zhuyanheng/Phys39-teamR-X/README.md

# Phys 39 Team R&X

Team members:

- Ricky Huang
- Xavier Zhu

## Repository

[Phys39 Team R&X GitHub Repository](https://github.com/zhuyanheng/Phys39-teamR-X)

### Quick navigation

- [Module 1: Arduino measurements](Module_1/arduino/README.md)
- [Module 2: Instrument pieces](Module_2/arduino/README.md)
- [Module 3: Manual TEC and Python GUI](Module_3/python/README.md)
- [Module 4: Open-loop TEC](Module_4/README.md)
- [Module 5: P control](Module_5/README.md)
- [Module 6: P/PI control and thermal models](Module_6/README.md)
- [Module 7: Aluminum rod instrument and stationary fin](Module_7/README.md)
- [Module 8: Angstrom experiment and final thermal transport](Module_8/README.md)
- [Current A3 PDF](Module_6/output/pdf/A3_Huang_Zhu.pdf)

## Module 1: Arduino Measurements

This repository contains the Arduino sketches, experimental data, figures,
measurement notes, and analysis used for Module 1.

- [Module 1 Arduino documentation](Module_1/arduino/README.md)
- [Module 1 data documentation](Module_1/data/README.md)
- [Part 3C quantitative analysis](Module_1/data/analysis_3c_ab.md)
- [A1 Module 1 evidence note](docs/module_notes/module_01_evidence.md)

### Module 1 Arduino Sketches

#### Part 1: Blink and Digital Output

- [Blink with 1:1 HIGH:LOW ratio](Module_1/arduino/part_01_blink_1to1/part_01_blink_1to1.ino)
- [Blink with 1:10 HIGH:LOW ratio](Module_1/arduino/part_01_blink_1to10/part_01_blink_1to10.ino)
- [Blink with 10:1 HIGH:LOW ratio](Module_1/arduino/part_01_blink_10to1/part_01_blink_10to1.ino)

#### Part 2: AnalogReadSerial

- [AnalogReadSerial](Module_1/arduino/part_02_analog_read_serial/part_02_analog_read_serial.ino)

#### Part 3: ADC Digitization and Averaging

- [Part 3A: Integer ADC readings](Module_1/arduino/part_03a_adc_integer/part_03a_adc_integer.ino)
- [Part 3B: ADC-to-voltage conversion](Module_1/arduino/part_03b_adc_voltage/part_03b_adc_voltage.ino)
- [Part 3C: N=1 and N=1000 averaging comparison](Module_1/arduino/part_03c_averaging_comparison/part_03c_averaging_comparison.ino)
- [Part 3D: ADC acquisition timing](Module_1/arduino/part_03d_averaging_timing/part_03d_averaging_timing.ino)

#### Part 4: PWM LED Control

- [Averaged ADC input controlling LED PWM](Module_1/arduino/part_04_averaged_adc_pwm_led/part_04_averaged_adc_pwm_led.ino)

### Module 1 Experimental Data

- [N=1 voltage data](Module_1/data/part_3c_N1_data.csv)
- [N=1000 averaged voltage data](Module_1/data/part_3c_N1000_data.csv)
- [Part 3C data analysis](Module_1/data/analysis_3c_ab.md)

## Module 2: First Real Instrument Pieces

This repository contains the Arduino sketches, figures, and evidence note
for Module 2: thermistor temperature measurement, Serial Plotter output,
trim-pot PWM control, H-bridge logic verification, and DC motor drive.

- [Module 2 Arduino documentation](Module_2/arduino/README.md)
- [Module 2 evidence note](docs/module_notes/module_02_instrument_pieces.md)

### Module 2 Arduino Sketches

- [Part 1: Thermistor Serial Data and Temperature Conversion](Module_2/arduino/part_1/part_1.ino)
- [Part 2: Serial Plotter Output](Module_2/arduino/part_2/part_2.ino)
- [Part 3: Trim-Pot PWM and H-Bridge Control](Module_2/arduino/part_3/part_3.ino)

### Module 2 Figures

- [Part 1 Serial Output](Module_2/figures/part_1.png)
- [Part 2 Serial Plotter](Module_2/figures/part_2.png)
- [Part 3A Serial Plotter](Module_2/figures/part_3a_serial_plotter.png)
- [Part 3AB Setup](Module_2/figures/part_3ab_setup.png)
- [Part 3B Cool PWM=142](Module_2/figures/part_3b_cool_PWM=142.png)
- [Part 3B Cool PWM=60](Module_2/figures/part_3b_cool_PWM=60.png)
- [Part 3B Heat PWM=115](Module_2/figures/part_3b_heat_PWM=115.png)
- [Part 3B Heat PWM=60](Module_2/figures/part_3b_heat_PWM=60.png)
- [Part 3C Heat Motor Running](Module_2/figures/part_3c_heat.png)
- [Part 3C Motor Video](Module_2/figures/part_3c.mp4)

## Module 3: Manual TEC Heat/Cool And First Python GUI

This repository contains the Arduino sketches, Python scripts, data, and
figures for Module 3: manual TEC control via H-bridge, thermistor feedback,
and a Python GUI for display and control.

- [Module 3 Arduino documentation](Module_3/arduino/README.md)
- [Module 3 Python documentation](Module_3/python/README.md)
- [Module 3 data documentation](Module_3/data/README.md)
- [Module 3 evidence note](docs/module_notes/module_03_tec_gui.md)

### Module 3 Arduino Sketches

- [Part 2: Manual Trim-pot Motor Control](Module_3/arduino/part_2/part_2.ino)
- [Part 3: Manual TEC Calibration](Module_3/arduino/part_3/part_3.ino)
- [Part 6: TEC Python Serial Control](Module_3/arduino/part_6_tec_python_control/part_6_tec_python_control.ino)

### Module 3 Python Scripts

- [Part 4: Temperature Strip Chart](Module_3/python/part_4_graphing.py)
- [Part 5: TEC Control GUI](Module_3/python/part_5_tec_control_gui.py)
- [Python dependencies](requirements.txt)

The final integrated pair is the
[Arduino serial-command sketch](Module_3/arduino/part_6_tec_python_control/part_6_tec_python_control.ino)
and the [Python TEC control GUI](Module_3/python/part_5_tec_control_gui.py).
They communicate at `9600 baud` using commands such as
`SET PWM 40 DIR HEAT` and measurements such as:

```text
Temperature (C): 27.73, Time (s): 645.06, PWM: 40, Heat/Cool: 1
```

The fields are temperature in degrees Celsius, Arduino elapsed time in
seconds, the active PWM command, and direction (`1` = heat, `0` = cool).

### Module 3 Figures

- [Part 2 Cooling](Module_3/figures/part_2_cooling.png)
- [Part 3 Oscilloscope on Digitals](Module_3/figures/part_3_oscilloscope_on_digitals.mp4)
- [Part 3 Oscilloscope on M+ and M-](Module_3/figures/part_3_oscilloscope_on_M+-.mp4)
- [Part 3 Switch Between Cooling and Heating](Module_3/figures/part_3_switch_between_cooling_heating.png)
- [Part 4 Temperature Graph](Module_3/figures/part_4_temperature_graph.png)
- [Part 5 GUI Without Actual Control](Module_3/figures/part_5_GUI_without_actual_control.png)
- [Part 6 TEC Control Using GUI 1](Module_3/figures/part_6_TEC_control_using_GUI_1.png)
- [Part 6 TEC Control Using GUI 2](Module_3/figures/part_6_TEC_control_using_GUI_2.png)
- [Part 7 GUI](Module_3/figures/part_7_GUI.png)
- [Part 7 Labeled Heat/Cool Record](Module_3/figures/part_7_heat_cool_record.png)
- [Part 7 Cooling](Module_3/figures/part_7_cooling.png)
- [Part 7 Heating](Module_3/figures/part_7_heating.png)

## Module 4: Open-Loop TEC Heating and Cooling

This repository contains the Arduino and Python programs, raw temperature
records, figures, and A2 analysis for Module 4: software temperature shutdown,
open-loop heating and cooling at five PWM levels per direction, and a
steady-temperature-versus-signed-PWM comparison.

- [Module 4 documentation](Module_4/README.md)
- [Module 4 selected measurements](Module_4/data/steady_state.csv)
- [Module 4 lab record and steady-state protocol audit](docs/module_notes/module_04_open_loop_tec.md)

### Module 4 Arduino Sketch

- [Part 1: TEC Control and Temperature Safety](Module_4/arudino/part_1/part_1.ino)

### Module 4 Python Scripts

- [TEC Control GUI and CSV Logger](Module_4/python/part_5_tec_control_gui.py)
- [Part 4 Data Validation and Figures](Module_4/python/plot_a2.py)
- [A2 PDF Builder](Module_4/python/build_a2_existing_data.py)

### Module 4 Data and Figures

- [Ten selected HEAT/COOL measurements](Module_4/data/steady_state.csv)
- [Raw experimental CSVs and safety-test logs](Module_4/data/)
- [Part 1 safety-test record](Module_4/check/part_1_safety_check.md)
- [Part 1 HEAT high-current diagram](Module_4/figures/part_1_heating_high_current.png)
- [Part 1 COOL high-current diagram](Module_4/figures/part_1_cooling_high_current.png)
- [HEAT time trace](Module_4/figures/part_4_heating_trace.png)
- [COOL time trace](Module_4/figures/part_4_cooling_trace.png)
- [Steady temperature versus signed PWM](Module_4/figures/part_4_steady_temperature_vs_pwm.png)
- A2 two-page PDF candidate: not present in this checkout; see the Module 4 analysis files above.

The ten-point analysis and A2 PDF are provisional. The professor's revised
Part 3 steady-state rule requires about three step-response time constants
followed by one additional minute of observation. See the Module 4 lab record
for the measurements that need review or longer recordings before submission.
The two Part 1 diagrams are historical illustrations, not verified as-built
wiring records; inspect the actual thermal-switch path with the instructor.

## Module 5: P-Only Temperature Control

This repository contains the Arduino and Python programs, raw temperature
records, figures, and analysis for Module 5: closing the TEC feedback loop with
proportional control. Python computes the signed PWM `u = Kp (T_set − T)`,
sends the direction and magnitude to the Arduino, and the Arduino keeps its
independent 60 °C shutdown. The team verified the feedback signs, swept five
gains at a 30 °C heating setpoint, and compared measured droop with the
Module 4 susceptibility model.
Three later October 7 trials tested higher gains; the fixed `Kp=250` run
overshot and oscillated around 30 °C after cooling near 20 °C.

- [Module 5 documentation](Module_5/README.md)
- [Module 5 lab note and Part 6 derivation](docs/module_notes/module_05_p_control.md)

### Module 5 Arduino Sketch

- [P-only TEC sketch](Module_5/arduino/p_only_tec/p_only_tec.ino)

### Module 5 Python Scripts

- [P-control GUI and CSV logger](Module_5/python/p_only_tec_control_gui.py)
- [Part 4 droop comparison](Module_5/python/plot_droop_comparison.py)
- [Strip-chart traces](Module_5/python/plot_strip_chart_traces.py)
- [Kp=250 oscillation plotting script](Module_5/python/plot_kp250_oscillation.py)
- [Controller tests](Module_5/python/test_p_only_tec_control_gui.py)

### Module 5 Data and Figures

- [Module 5 raw-data index](Module_5/data/README.md)
- [October 7 Kp=32 short trial](Module_5/data/20261007_104314_kp32_short_of_30c.csv)
- [October 7 mixed-gain exploration](Module_5/data/20261007_104346_mixed_kp_setpoint_exploration.csv)
- [October 7 Kp=250 oscillation CSV](Module_5/data/20261007_105005_kp250_20to30c_oscillation.csv)
- [Part 4 droop summary](Module_5/data/part_04_droop_comparison.csv)
- [Measured vs predicted droop](Module_5/figures/part_04_measured_vs_predicted_droop.png)
- [Low-gain strip-chart trace (Kp = 0.25)](Module_5/figures/low_gain_kp0.25_trace.png)
- [High-gain strip-chart trace (Kp = 4)](Module_5/figures/high_gain_kp4_trace.png)
- [Kp=250 oscillation: temperature and signed PWM](Module_5/figures/kp250_20to30c_oscillation.png)

The team selected `Kp = 0.25–4 PWM/°C` and accepts the Module 5 comparison
using the provisional Module 4 heating slope (`χ_h = 0.4954 °C/PWM`). The
underlying Module 4 steady-state limitation remains documented. Instructor
approval for the gain range and the Part 2 cooling target is not recorded.

## Module 6: P/PI Control and Lumped Modeling

Module 6 data analysis and the A3 report are complete using the retained
measurements: three P runs collected on October 21 (`Kp=0.25, 4, 100`, `Ki=0`)
and three PI runs collected on October 19 (`Kp=20`, `Ki=0.1, 0.2, 0.5`).
All six include the target sequence `20 -> 30 -> 20 °C` and a PWM limit of
255. The current A3 uses these Module 6 measurements and Module 4 calibration;
Module 5 P records remain historical evidence for Module 5 and are no longer
used in the current A3.

The 12-page report covers Questions 1-5, six experimental plots, six
standardized two-lump simulation plots, step-response metrics, damping and PI
stability calculations, windup, and gain selection. The simulations use the
teacher's v3 calculation core. Physical records, operator GUI screenshots,
and newly computed model trajectories are distinguished. Measurement and
model qualifications are recorded in the report. Repository publication and
Moodle submission are separate from completing the analysis.

### Module 6 report and evidence

- [Module 6 guide and directory map](Module_6/README.md)
- [Current A3 PDF](Module_6/output/pdf/A3_Huang_Zhu.pdf)
- [Current A3 Markdown](Module_6/docs/a3_feedback_model.md)
- [Current experimental analysis](Module_6/docs/experiment_analysis_2026-10-21.md)
- [Six raw measurements and retained run IDs](Module_6/data/physical/README.md)
- [Measured step-response metrics](Module_6/data/experiment_analysis/step_metrics.csv)
- [Data and provenance index](Module_6/data/README.md)
- [Figures index](Module_6/figures/README.md)
- [P comparison](Module_6/figures/experiment_analysis/p_aligned_comparison.png)
- [PI comparison](Module_6/figures/experiment_analysis/pi_aligned_comparison.png)
- [Analysis scripts and PDF reproduction](Module_6/python/analysis/README.md)
- [Earlier one-lump notes](Module_6/docs/one_lump_model_notes.md)
- [Earlier executed baseline notebook](Module_6/python/analysis/model_baseline_analysis.ipynb)

### Module 6 programs

- [Simulation launcher](Module_6/run_gui.command) and [teacher v3 source](Module_6/python/Lab_6_7_modeling_tec_v3.py)
- [Physical P/PI launcher](Module_6/run_pi_control.command) and [operator guide](Module_6/docs/pi_controller_guide_zh.md)
- [Arduino sketch and serial protocol](Module_6/arduino/README.md)

On the team's macOS setup, launch from the repository root or double-click
the appropriate `.command` file:

```bash
./Module_6/run_gui.command
./Module_6/run_pi_control.command
```

The mathematical simulator uses `Module_6/.venv` with modern Python/Tk;
the physical GUI and numerical analysis use the repository `.venv`.
These ignored local environments must be installed on a new checkout;
see the [Module 6 setup instructions](Module_6/README.md#首次配置环境).
The simulator never connects to the Arduino. The physical GUI connects only
when the operator requests it.

To recompute the current experimental analysis and numerical simulations:

```bash
.venv/bin/python Module_6/python/analysis/analyze_retained_experiments.py
.venv/bin/python Module_6/python/analysis/prepare_a3_evidence.py
```

These scripts do not access hardware. See the analysis README for PDF
dependencies and the final build command. Earlier Module 5-based analysis and
superseded A3 outputs are identified as historical, with the prior report in
`Module_6/archive/2026-10-21_pre_new_p/`.

## Module 7: Aluminum Rod, Step Response, and Stationary Fin

Module 7 replaces the one- and two-temperature lumped descriptions with a
position-dependent temperature field `T(x, t)`. The three course parts build
one model-testing chain: Part I derives the heat equation and the Biot test,
Part II derives the stationary finite-rod profile and its semi-infinite limit,
and Part III builds the six-channel rod instrument and measures the step
response and stationary profile.

- [Module 7 plan and requirements](Module_7/README.md)
- [Module 7 status snapshot](docs/module_notes/module_07_state.md)
- [Module 7 lab-day runbook, S16 → S17](docs/module_notes/module_07_lab_day_runbook_2026-10-26.md)
- Due Wednesday, October 28 at 9:05 AM: individual A4, submitted as
  `docs/assessments/a4_finite_length_biot.md` and `A4_Lastname.pdf`
- Due Wednesday, October 28 at 11:55 AM: C5 rod-instrument checkoff receipt
  citing the pushed acquisition-code and evidence commit

The governing equations used throughout are

```text
∂θ/∂t = α ∂²θ/∂x² − νθ,     α = k/(ρc),   ν = hP/(ρcA)
d²θ/dx² − m²θ = 0,          m² = hP/(kA)
Θ(x) = cosh[m(L − x)]/cosh(mL)   (insulated tip)
Θ∞(x) = e^(−mx)                  (semi-infinite limit)
Bi⊥ = hR/(2k) = (mR/2)²          (radius check)
```

Module 7 keeps the Module 6 Arduino sketch and Python GUI unchanged as a
working checkpoint and adds new Module 7 copies for six-channel acquisition.
Raw rod data, calibration coefficients, and corrected data are stored
separately so that measured values are never overwritten.

## Hardware

- Arduino Uno
- 100 kΩ potentiometer
- LED
- Current-limiting resistor
- Breadboard
- Jumper wires
- Oscilloscope and probe
- 100 kΩ NTC thermistor
- 100 kΩ precision resistor
- BTS7960 H-bridge
- 12 V DC power supply
- Small DC motor
- SPDT switch
- Thermoelectric Cooler (TEC)
- Thermal switch (NC)
- Heat exchanger (pump and radiator fans)

## Tested Capabilities

The team uploaded and tested the Module 1, Module 2, and Module 3 programs on an Arduino Uno.

- The three Part 1 sketches produced the intended HIGH:LOW timing ratios.
- Part 2 reported raw analog-input values over the serial connection.
- Part 3A reported discrete integer ADC values.
- Part 3B converted ADC values to voltage.
- Part 3C compared single readings with 1000-reading averages.
- Part 3D measured the time required for 1000 ADC conversions.
- Part 4 used the averaged potentiometer input to control LED brightness with PWM.
- Module 2 Part 1 measured temperature using a thermistor voltage divider and the Beta model.
- Module 2 Part 2 output temperature values for the Arduino Serial Plotter.
- Module 2 Part 3 controlled H-bridge PWM and direction with a trim-pot and switch.
- Module 2 Part 3B verified H-bridge command signals with an oscilloscope.
- Module 2 Part 3C drove a small DC motor in both directions with variable speed.
- Module 3 Part 2 and Part 3 successfully drove the TEC manually and calibrated heat/cool directions.
- Module 3 Part 4 displayed live temperature data in a Python strip chart.
- Module 3 Part 5 built a functional Python GUI with synchronized slider and text box.
- Module 3 Part 6 enabled serial-command control of PWM and direction from Python.
- Module 3 Part 7 completed integrated manual-control testing with real-time plotting and CSV logging.
- Module 4 software-safety tests recorded temperature-limit shutdown and continuing serial reports; the Part 1 record distinguishes firmware reports from independent electrical measurements.
- Module 4 collected ten selected HEAT/COOL PWM points and generated provisional time traces, fitted slopes, and an A2 PDF. Compliance with the revised steady-state rule remains to be established.
- Module 5 verified the low-gain HEAT and COOL feedback signs, swept five proportional gains at a 30 °C setpoint, measured droop versus gain, and compared measured droop with the Module 4 susceptibility prediction (no oscillation up to Kp = 4 in the September sweep). An October 7 exploratory run at Kp = 250 overshot the setpoint and showed repeated oscillation.
- Module 6 collected three P and three PI runs, with temperature, target, signed PWM, P/I terms and error logging. The retained high-gain P run uses Kp=100 and shows decaying ringing. The three PI gains trade final heating speed against overshoot.
- Module 6 completed six two-lump GUI simulations and reproducible numerical calculations, checked the P damping and PI stability criteria, and generated the current A3 report. The control software has 16 hardware-free tests, and the simulator's six model/controller combinations passed startup checks.

## How to Run a Sketch

1. Open the selected `.ino` file in Arduino IDE.
2. Select `Arduino Uno` as the board.
3. Select the correct serial port.
4. Click **Verify**.
5. Click **Upload**.
6. Open Serial Monitor or Serial Plotter at `9600 baud` when required.
7. For Module 3 Python scripts, ensure the Serial Monitor is closed before running the GUI.
8. For the Module 4 GUI, also set its `SERIAL_PORT` to the connected Arduino and close Serial Monitor before launch; see the [Module 4 documentation](Module_4/README.md).
9. Module 6 uses the same serial-command firmware family. Close other applications using the port, select the port in its physical GUI, and follow the [P/PI operator guide](Module_6/docs/pi_controller_guide_zh.md). Uploading firmware and connecting the mathematical simulator are different operations; the simulator requires no board.

### Running the Module 3 Python Programs

From the repository root, install the dependencies once:

```text
python3 -m pip install -r requirements.txt
```

Run the display-only strip chart:

```text
python3 Module_3/python/part_4_graphing.py
```

Run the final manual-control GUI:

```text
python3 Module_3/python/part_5_tec_control_gui.py
```

## AI Use

AI helped draft and debug the Arduino thermistor/serial-command code, Python
serial parser, GUI controls, plotting, CSV logging, documentation, and
repository organization. The team selected and verified the pin mapping,
thermistor constants, 1000-sample average, heat/cool direction mapping, and
low-power PWM setting, and tested the programs on the real Arduino, H-bridge,
thermistor, TEC, oscilloscope, and power supply. The code paths reviewed for
the C3 oral explanation are the measurement conversion, serial format, GUI
synchronization, command path, and plot updates; each team member must be able
to explain them without relying on the AI transcript.

For Module 4, AI also assisted with CSV validation, plotting, and the draft A2
analysis. The selected steady-state windows and physical checks remain subject
to the team's and instructor's review; generated figures are not a substitute
for the revised measurement protocol.

The Module 4 temperature-limit shutdown has serial-log evidence, but actual
output-pin voltage, disconnected-sensor behavior, and broken-serial behavior
have not been independently verified in the cited test record. The ten-point
steady-state analysis also requires review against the revised Part 3 rule.

For Module 5, AI helped draft and debug the P-control GUI, the droop
comparison and strip-chart plotting scripts, and the Part 6 one-lump
derivation. The measured droop, gain values, and the provisional Module 4
heating slope used in the prediction remain subject to the team's and
instructor's review; generated figures do not replace the physical runs or the
instructor-approved gain range.

For Module 6, AI assisted with P/PI software, raw-data checks, reproducible
analysis, two-lump stability calculations, plots, file organization, and A3
writing/PDF generation. Experimental CSVs are the team's measurements;
computed model data are labeled separately. The current A3 excludes the
superseded Module 5 P evidence. Each team member remains responsible for
understanding the equations, data selection, and interpretation.
