zhuyanheng/Phys39-teamR-X/Module_7/docs/README.md

# Module 7 documentation index

`Module_7/` holds only **this module's own** artefacts. The evidence notes the course asks for live in the repository-root `docs/`, following the same convention as Modules 1-6, and are not duplicated here.

## This directory

| File | Contents |
| --- | --- |
| `README.md` (this file) | Index of Module 7 documentation: which documents live in the repository-root `docs/`, and where figures and data come from |
| `../README.md` | Module 7 experiment design, the six components, the prediction record, the software extension plan |

## Module 7 evidence in the repository-root `docs/`

| File | Contents | Status |
| --- | --- | --- |
| `docs/module_notes/module_07_state.md` | Status snapshot: what exists, what is verified, what is missing, and the known warts; read this first when picking the module up cold | Present |
| `docs/module_notes/module_07_lab_day_runbook_2026-10-26.md` | Lab-day sequence: software, geometry, calibration, step, steady state | Present |
| `docs/module_notes/module_07_step1_integration_check.md` | On-site procedure for the first power-up of the six-channel chain: wiring, expected voltages, per-channel fingerprints, fault injection | Present |
| `docs/module_notes/module_07_rod_instrument.md` | Sensor map, same-temperature check record, geometry, baseline/step, run metadata; includes the decision to skip the soak calibration and what that costs | Holes 2, 5, 7, 8, 9 and the measured distances recorded 2026-10-30; the 2026-11-02 20 °C/40 °C runs, the 45 °C interlock trip, the ≈ 30 min settling estimate and the 31 min 40 °C confirmation run (still 2.6× over the slope limit, so the target is now ≈ 45 min) recorded 2026-11-02; the self-read ambient and why it is the largest systematic; residuals and the `h` inversion still to be filled in |
| `docs/module_notes/module_07_stationary_fin.md` | Part 3 method, steady-state criteria, the two models, two-layer uncertainty, predictions for the measured geometry, open items | Method and script complete (22 tests pass); §9: all three 2026-11-02 runs refused, so still no certified stationary profile; §10: the diagnostic fit the 31-minute record supports (`m = 4.83 ± 0.07 1/m`, five systematics) and how to quote it |
| `docs/assessments/a4_finite_length_biot.md` | A4, parts 1-4 | Complete theoretical draft for Yanheng Zhu, updated 2026-11-06; source/PDF version receipt separately verified; regenerated PNG bytes excluded from source checks; measured 12.77 mm diameter and 0.01 mm caliper specification recorded; reproducible predictions and PDF in `Module_7/output/pdf/A4_Zhu.pdf`; student review and Moodle submission not confirmed |

A4 numerical checks: `.venv/bin/python Module_7/python/analysis/a4_theory_checks.py`.
This writes provisional results to `data/processed/a4_predictions/` and the
finite-length comparison to `figures/a4/`. PDF authoring and version recording
are handled by `python/analysis/build_a4_pdf.py`; see that script's usage note.
The A4 predictions use fixed `h = 10 W/(m^2 K)` and the same 6061-T6 table's
`k = 166-172 W/(m K)` temperature envelope, never a diagnostic fitted `m`.

## Figures

`Module_7/figures/` is written by the analysis scripts. The file names map one-to-one onto the figure numbers used in the report:

- `part_01_sensor_map.png` - rod geometry, hole positions, probe numbering (`python/analysis/sensor_map_figure.py`)
- `part_02_step_response.png` - six-channel step response (no calibration correction curves: the soak was skipped) (`python/analysis/step_response_figure.py`, default input `module_07_rod_interlock_trip_45C_40C.csv`)
- `part_03_stationary_profile.png` - stationary profile with both fits and both residual sets; the committed copy is titled `CRITERION RELAXED`, because the pre-registered criterion was not met (`python/analysis/stationary_fin_fit.py`)

All three exist and are regenerated by rerunning those three commands; nothing in them is hand-edited. Regenerating
them on 2026-11-02 after the documentation pass produced **byte-identical** PNGs, and the same rerun of the fit and
the diagnostics reproduced both JSONs and the profile CSV byte for byte — so the committed files are exactly what
the committed scripts emit. Diagnostic figures are not deliverable figures: the per-run check traces sit in
`figures/pilot_checks/<raw stem>_temperatures.png`, one file per checked run.

Every number that appears in a figure must be traceable to a fit result in `Module_7/data/processed/`, and vice versa. The
`part_03` numbers therefore come from `module_07_rod_stationary_40C_stationary_fit.json`, and the systematics quoted next to them
in the report come from `module_07_rod_stationary_40C_stationary_diagnostics.json` (written by
`python/analysis/stationary_diagnostics.py`).
