zhuyanheng/Phys39-teamR-X/Module_5/figures/README.md

# Module 5 figures

- [Measured vs predicted droop](part_04_measured_vs_predicted_droop.png): Part 4 comparison, generated by `Module_5/python/plot_droop_comparison.py`.
- [Low-gain strip-chart trace (Kp = 0.25)](low_gain_kp0.25_trace.png): temperature and PWM, generated by `Module_5/python/plot_strip_chart_traces.py`.
- [High-gain strip-chart trace (Kp = 4)](high_gain_kp4_trace.png): temperature and PWM, generated by `Module_5/python/plot_strip_chart_traces.py`.
- [Kp=250 oscillation from near 20 °C toward 30 °C](kp250_20to30c_oscillation.png): temperature, setpoint, and signed firmware-reported PWM; generated by [`plot_kp250_oscillation.py`](../python/plot_kp250_oscillation.py) from [`20261007_105005_kp250_20to30c_oscillation.csv`](../data/20261007_105005_kp250_20to30c_oscillation.csv).

See the [Module 5 lab note](../../docs/module_notes/module_05_p_control.md) and [data index](../data/README.md) for source CSVs, calculations, and limitations.
