zhuyanheng/Phys39-teamR-X/Module_6/docs/pi_run_ki_0p1_2026-10-19.md

# PI experiment receipt — 2026-10-19

Source: `../data/physical/pi_kp_20_ki_0p1_20261019_093424_268559.csv`.
Raw CSV unchanged. Earlier discarded experiments are not used here.

Retain run_id=3: PI, Kp=20 PWM/°C, Ki=0.1 PWM/(°C s), PWM limit=255,
conditional anti-windup enabled. Runs 1 and 2 are brief preliminary starts
(30°C for about 2.5 s and 10°C for about 4.1 s), excluded from the comparison.
Run 3 begins with integral reset; the subsequent 20→30→20°C changes retain
the integral. All active measurement rows in run 3 report Safety=OK and no
computed output saturation. Firmware PWM is a reported command, not a current measurement.

| Segment | Recorded duration (s) | Initial T (°C) | Final-60-s mean T (°C) | Final-60-s range (°C) | Observed settling time (s) |
|---|---:|---:|---:|---:|---:|
| Initial conditioning toward 20°C | 228.50 | 24.99 | 19.9914 | 19.97–20.01 | 80.81 |
| 20→30°C | 650.92 | 19.97 | 29.9306 | 29.88–29.97 | 401.35 |
| 30→20°C | 332.86 | 29.93 | 20.0275 | 20.02–20.04 | 127.43 |

Settling definition: earliest measurement after the segment begins whose
remaining measurements stay within target ±0.2°C, with at least 60 s of
remaining observations. Times are relative to the first active measurement
after each step; event rows lack Arduino timestamps, so step timing has
approximately one sampling-interval uncertainty (about 0.51 s).

Heating maximum: 30.01°C (0.01°C above target; near reported measurement
resolution, not evidence of substantial overshoot). Cooling minimum: 20.02°C,
with no measured undershoot below target during the retained cooling step.
Final-60-s errors, defined as target minus measured temperature: heating
+0.0694°C; cooling −0.0275°C. These are finite-record tail errors, not proof of
an infinite-time equilibrium. The intact matched up/down trace is usable for
the PI comparison; classify as low/intermediate/high only after comparing the
other retained Ki runs. The response establishes that the present apparatus
can heat and cool; it does not identify the cause of the earlier flat trace.
