zhuyanheng/Phys39-teamR-X/docs/module_notes/module_05_p_control.md

# Module 5: P-only temperature control

## Part 1: controller implementation

- Python GUI: `Module_5/python/p_only_tec_control_gui.py`.
- Arduino sketch: `Module_5/arduino/p_only_tec/p_only_tec.ino`, copied from the Module 4 source on 2026-09-29. Verify that this is the version actually uploaded before a powered run.
- At startup the GUI sends PWM 0 and leaves P control off. It waits for a recent, finite 10–45 °C measurement with `Safety: OK` before enabling P control.
- For each Arduino report, Python calculates `error = setpoint - temperature`, `signed_pwm = Kp * error`, sends `HEAT` for nonnegative signed PWM or `COOL` for negative signed PWM, and rounds/clamps `abs(signed_pwm)` to an integer 0–255.
- The GUI plots measured temperature, setpoint, measured PWM by direction, and error. It writes all measurements and control values to a timestamped CSV in `Module_5/data/`.
- While P control is active, setpoint and Kp can be edited and applied with the **Apply setpoint / Kp** button (or Enter). The new command is calculated from the latest valid temperature immediately, and each subsequent CSV sample records the applied settings. Editing text alone does not change the controller. For the formal Part 3 gain sweep, stop and restart each gain from PWM 0 as the assignment requires.
- Stop requests PWM 0. A reported safety fault, temperature outside 10–45 °C, or a measurement gap over 2 seconds stops P mode and requests PWM 0. The Arduino independently checks its 60 °C software limit and invalid sensor readings. A lost Python process cannot be relied on to send a final zero command; operate only with the instructor's approved hardware precautions and supervision.

## Still to verify on the physical apparatus

- [ ] Instructor-approved wiring, current limit, live sensor reading, and firmware version.
- [x] Start with PWM 0 and confirm both firmware outputs report 0 (`20260930_105823_sign_test_heat_cool_confirmed.csv`, 0.56–11.16 s; firmware reports 0/0 and `Safety=OK`).
- [x] Low-gain HEAT and COOL feedback signs (Part 2); see the raw-data assessment below. Stop if temperature moves the wrong way in any future run.

Operator update, 2026-10-05: the team selected `Kp = 0.25–4 PWM/°C` as the Module 5 test range. The operator reports the original power-supply output setup as **12 V, 10 A, 120 W**. This reports the setup values; it does not independently verify the current-limit setting during each run, measured TEC current, instructor approval, wiring, or the uploaded firmware version. The team considers the existing Module 5 temperature records and provisional susceptibility sufficient for the Module 5 comparison; the Module 4 steady-state caveat remains part of the interpretation.

The initial implementation checks above were software-only; the subsequent physical observations are recorded below.

## Part 2: low-gain sign test, 2026-09-30

Primary raw record: `Module_5/data/20260930_105823_sign_test_heat_cool_confirmed.csv`. All 432 serial rows report `Safety=OK`. The first 22 PWM-0 samples average 23.283 °C (range 23.26–23.30 °C). The provisional Module 4 slopes are 0.4954 °C/PWM for heating and 0.1414 °C/PWM in cooling magnitude, so at `Kp=0.5 PWM/°C` the estimated loop gains are about 0.248 and 0.071, respectively; the slopes still need Module 4 steady-state revalidation.

| Segment | Setpoint, Kp | Firmware direction/PWM | Temperature observation | Assessment |
| --- | --- | --- | --- | --- |
| Heating, 12.18–59.76 s | 35 °C, 0.5 PWM/°C | HEAT, PWM 5–6 | 23.30 → 24.55 °C | Positive-error command and heating response supported. |
| PWM 0, 60.27–72.91 s | — | Both outputs 0 | 24.56 → 24.28 °C | The block cooled naturally while above ambient. |
| Cooling, 73.92–218.94 s | 15 °C, 0.5 PWM/°C | COOL, PWM 4–5 | 24.26 → 22.95 °C | Negative-error command and active cooling supported: 140 samples from 148.43 s onward were below the 23.26 °C minimum of the initial PWM-0 baseline; the final 20 samples averaged 22.961 °C. |

The earlier record, `20260930_104014_sign_test_preliminary.csv`, shows the same command directions but did not establish active cooling below ambient. The new run supplies that missing evidence. The 15 °C target remains farther below ambient than the assignment's “slightly below room temperature” instruction; instructor approval for that choice is not recorded here. **Part 2 physical direction result: both HEAT and COOL supported.** Confirm the cooling-setpoint choice with the instructor if strict adherence to “slightly below” is required.

## Part 3: original droop-versus-gain plan

Use one heating setpoint of 30 °C and a fresh PWM-0 ambient baseline before the gain sweep. With the earlier 23.283 °C baseline and provisional heating susceptibility `χ_h = 0.4954 °C/PWM`, the estimated open-loop PWM needed for the 6.717 °C change is `P_required ≈ 6.717/0.4954 = 13.56`. For each candidate, `P0 = Kp × 6.717`; recalculate if the actual ambient baseline changes. The following was the **pre-run candidate calculation** for the range the team ultimately selected. Instructor approval before the powered sweep is not documented:

| Candidate Kp (PWM/°C) | Predicted initial P0 (PWM) | Estimated loop gain L=Kpχ_h | Relative to P_required |
| ---: | ---: | ---: | --- |
| 0.25 | 1.68 | 0.124 | Well below |
| 0.5 | 3.36 | 0.248 | Below |
| 1 | 6.72 | 0.495 | About half |
| 2 | 13.43 | 0.991 | Comparable |
| 4 | 26.87 | 1.982 | Above |

For **each** approved gain: stop P mode and confirm PWM 0; start the run at the same 30 °C setpoint; wait until temperature settles or clearly fails to settle; record the actual starting temperature, final/mean temperature, error, final PWM, response shape, and raw CSV filename. Do not treat changes made with the live Apply button as separate Part 3 gain runs. Save a representative time trace and eventually plot measured droop against Kp. Keep the instructor-approved range, safety observations, and any saturation or failure to settle in the notes.

## Part 3: recorded gain sweep, 2026-09-30

The five new runs used a 30 °C heating setpoint and separate P-control starts. Each CSV begins with PWM 0 and reports `Safety=OK` throughout. The first run's PWM-0 baseline (39 samples) averaged **23.1885 °C**. Later runs began while the block was still warm, so their PWM-0 temperatures are not used as room-temperature estimates. The measured temperatures and droops below use each run's last 20 seconds of active control (40 samples).

| Kp (PWM/°C) | Last-20-s mean T (°C) | Measured droop (°C) | Last-20-s mean PWM | Raw CSV |
| ---: | ---: | ---: | ---: | --- |
| 0.25 | 24.0000 | 6.0000 | 1.700 | `20260930_110723_droop_kp0p25.csv` |
| 0.5 | 24.7700 | 5.2300 | 3.000 | `20260930_111214_droop_kp0p5.csv` |
| 1 | 25.4977 | 4.5023 | 4.275 | `20260930_112131_droop_kp1.csv` |
| 2 | 26.7695 | 3.2305 | 6.000 | `20260930_112429_droop_kp2.csv` |
| 4 | 27.7400 | 2.2600 | 9.000 | `20260930_112955_droop_kp4.csv` |

The last-20-s temperature change was about 0.01–0.02 °C per run. The team accepts these windows for the Module 5 comparison. A longer documented steady-state criterion would be needed to establish true equilibrium. The operator confirmed `Kp=0.25–4` as the team's selected range on 2026-10-05; instructor approval is not recorded in these files.

## Part 4: predicted versus measured droop

Use the provisional Module 4 heating susceptibility `χ_h = 0.4954 °C/PWM` and the first run's ambient reference `T_amb = 23.1885 °C`. At equilibrium, `T = T_amb + χ_h P` and `P = Kp(T_set − T)`, hence

`e_pred = T_set − T = (T_set − T_amb)/(1 + Kp χ_h)`.

Here `T_set − T_amb = 6.8115 °C`. The loop gain is `L = Kp χ_h`, so predicted fractional droop is `e_pred/(T_set − T_amb) = 1/(1 + L)`.

| Kp (PWM/°C) | L | Measured droop (°C) | Predicted droop (°C) | Measured − predicted (°C) |
| ---: | ---: | ---: | ---: | ---: |
| 0.25 | 0.124 | 6.0000 | 6.0609 | −0.0609 |
| 0.5 | 0.248 | 5.2300 | 5.4593 | −0.2293 |
| 1 | 0.495 | 4.5023 | 4.5550 | −0.0527 |
| 2 | 0.991 | 3.2305 | 3.4215 | −0.1910 |
| 4 | 1.982 | 2.2600 | 2.2845 | −0.0245 |

The measured droop decreases with gain and is 0.02–0.23 °C below the prediction across the five points. This is close agreement for this provisional comparison, but the Module 4 susceptibility was derived from windows that still need steady-state revalidation. The ambient reference came from the first run only; the later warm starts and the limited final windows are additional limitations. Recompute from the raw records if the Module 4 slope or ambient estimate is updated.

- Reproducible calculation: `Module_5/python/plot_droop_comparison.py`
- Calculated values and provenance: `Module_5/data/part_04_droop_comparison.csv`
- Comparison plot: `Module_5/figures/part_04_measured_vs_predicted_droop.png`
- Representative strip charts: `Module_5/figures/low_gain_kp0.25_trace.png` and `Module_5/figures/high_gain_kp4_trace.png`

## Part 5: high-gain response

The original September 30 gain sweep gives the following Part 5 summary. “Near flat” describes the last 20 s only; it is not proof of full thermal equilibrium. None of these five runs approached the PWM limit of 255.

| Kp (PWM/°C) | Last-20-s mean T (°C) | Last-20-s T range (°C) | Maximum active PWM | Saturation? | Response observation |
| ---: | ---: | --- | ---: | --- | --- |
| 0.25 | 24.0000 | 23.99–24.02 | 2 | No | Gradual heating; near-flat end |
| 0.5 | 24.7700 | 24.76–24.78 | 3 | No | Heating; near-flat end |
| 1 | 25.4977 | 25.49–25.51 | 5 | No | Heating; near-flat end |
| 2 | 26.7695 | 26.75–26.79 | 10 | No | Heating; near-flat end |
| 4 | 27.7400 | 27.73–27.75 | 19 | No | Heating; near-flat end, no sustained oscillation evident |

The highest gain in the 2026-09-30 sweep was `Kp = 4 PWM/°C` (`L ≈ 1.98` using the provisional Module 4 heating slope). Its active-control trace lasts about 273 s. Temperature rises from approximately 25.24 °C to 27.74 °C and stays within 27.73–27.75 °C in the final 20 s. The active-run PWM is at most 19 and stays at 9 in the final 20 s; the 255-count limit is never reached. The file reports `Safety=OK` throughout. No sustained temperature oscillation is evident in this record.

At the lowest gain, `Kp = 0.25 PWM/°C`, the temperature rises gradually and ends near 24.00 °C; its final-20-s PWM alternates between 1 and 2. Thus the highest recorded gain uses a larger PWM command and has smaller droop, with no observed saturation. These runs start at different block temperatures, so their absolute rise times are not a controlled settling-time comparison.

The team initially selected `Kp=4` as the top of that sweep. The assignment calls for instructor approval of the gain range, but approval is not documented in the present records. The later October 7 exploratory trials extend well beyond this range; approval of those gains is also not documented here.

### October 7 exploratory trials and setpoint crossing

The three later CSVs are indexed in [`Module_5/data/README.md`](../../Module_5/data/README.md). They are separate from the five-run droop comparison and must not be pooled with it:

| Trial | Raw record | Active settings | Observation |
| --- | --- | --- | --- |
| 1 | [`20261007_104314_kp32_short_of_30c.csv`](../../Module_5/data/20261007_104314_kp32_short_of_30c.csv) | 30 °C; `Kp=32` | Temperature reached 29.67 °C at most and ended at 29.59 °C during only about 22 s of P control. This record shows that 30 °C was not reached **during this short trial**; it does not establish an unreachable steady state. |
| 2 | [`20261007_104346_mixed_kp_setpoint_exploration.csv`](../../Module_5/data/20261007_104346_mixed_kp_setpoint_exploration.csv) | `Kp=64, 128, 50, 250`; setpoints 20 and 30 °C | Multiple live changes of setpoint and gain, with heating, cooling, a maximum of 32.49 °C, and PWM saturation. This is exploratory behavior, not one controlled gain comparison. |
| 3 | [`20261007_105005_kp250_20to30c_oscillation.csv`](../../Module_5/data/20261007_105005_kp250_20to30c_oscillation.csv) | Pre-cooled near 20 °C; then 30 °C at fixed `Kp=250` | P mode begins at 20.90 °C (57.94 s), overshoots, and continues oscillating around the target. All 270 rows report `Safety=OK`. |

In trial 3 the temperature first exceeds 30 °C at 63.55 s (30.37 °C). The calculated error has then become negative, so the controller requests cooling. The firmware still reports the preceding HEAT command in that same serial row; at 64.06 s it reports COOL. **Reversing the command does not reverse the block's temperature instantly:** the temperature keeps rising to its first peak of **32.46 °C at 65.08 s**, an overshoot of **2.46 °C**, while COOL is already reported. It then falls below the setpoint and the controller requests HEAT again. The repeated direction changes and thermal response produce the observed oscillation. The CSV's `signed_pwm` is calculated from the *current* temperature, whereas the firmware PWM fields report the command already in effect; comparing them on the same row requires this one-report timing distinction.

Using local temperature peaks after 90 s (seven peaks from 93.12 to 134.48 s), the mean peak-to-peak period is **6.89 s** (frequency about **0.145 Hz**). Seven late peaks average **31.65 °C** and seven late troughs average **29.19 °C**. Define oscillation amplitude here as **half their mean peak-to-trough difference**, about **1.23 °C**; peak-to-peak is **2.46 °C**. The active record contains **64 of 157 samples at the PWM magnitude limit of 255**. These are descriptive measurements of the late observed cycles, not a claim that the oscillation will persist indefinitely. [Temperature and signed PWM plot](../../Module_5/figures/kp250_20to30c_oscillation.png); reproducible plotting script: [`plot_kp250_oscillation.py`](../../Module_5/python/plot_kp250_oscillation.py).

The much larger gain and repeated saturation distinguish trial 3 from the September sweep. Thermal lag between the TEC and sensor, other thermal masses, discrete sampling, and saturation are plausible contributors; the record alone does not isolate one cause. Do not extend the gain further without the instructor's approved range and supervision.

## Part 6: interpretation — one-lump model, loop gain, and transients

### Steady droop from the one-lump balance

Treat the TEC, block, and thermistor as one object at uniform temperature `T` with thermal capacity `C = dU/dT ≈ m c_p` (J/°C). Under P-only control the energy balance is

`C dT/dt = P_u Kp (T_set − T) − H (T − T_amb)`,

where `P_u` is the TEC power per signed PWM count (W/PWM count) and `H` is the lump's total passive conductance to the room (W/°C). Setting `dT/dt = 0` gives

`H (T − T_amb) = P_u Kp (T_set − T)`.

Collecting the `T` terms and solving,

`T_set − T = H (T_set − T_amb) / (H + P_u Kp) = (T_set − T_amb) / (1 + Kp P_u/H)`.

This is identical to Part 4's `e_pred = (T_set − T_amb)/(1 + Kp χ_h)` provided `χ_h = P_u/H`. The agreement requires the one-lump idealizations: one uniform temperature, linear passive heat loss (`H` constant), instantaneous measurement and actuation, no PWM saturation, and `P_u` approximately constant over the tested PWM/temperature range.

### Susceptibility is `P_u/H`, not a thermal capacity

Open the loop (`u` an independent input). At steady state `0 = P_u u − H(T − T_amb)`, so `T − T_amb = (P_u/H) u` and

`χ_{T,u} = dT/du = P_u/H`,  units `(W/PWM)/(W/°C) = °C/PWM`.

- `P_u` doubles → `χ` doubles (same `H`).
- `H` doubles → `χ` halves.
- `C` alone doubles → `χ` and the steady droop are unchanged; only the closed-loop time constant `τ_cl = C/(H + P_u Kp)` doubles.

So `C` controls how fast the lump moves but does not enter the steady droop, which is a balance between actuator strength per count and passive coupling. This is why the Part 4 susceptibility model (which has no `C`) predicts droop correctly.

### Loop gain and fractional droop

With `χ_h = 0.4954 °C/PWM` and `T_set − T_amb = 6.8115 °C`, the loop gain is `L = Kp χ_h` and the predicted fractional droop is `1/(1+L)`. Measured fractional droop is `(measured droop)/(T_set − T_amb)`.

| Kp (PWM/°C) | L | 1/(1+L) | measured fractional droop | measured − model |
| ---: | ---: | ---: | ---: | ---: |
| 0.25 | 0.124 | 0.890 | 0.881 | −0.009 |
| 0.5 | 0.248 | 0.801 | 0.768 | −0.034 |
| 1 | 0.495 | 0.669 | 0.661 | −0.008 |
| 2 | 0.991 | 0.502 | 0.474 | −0.028 |
| 4 | 1.982 | 0.335 | 0.332 | −0.004 |

The measured fractional droop tracks `1/(1+L)` closely, falling from about 0.88 at `L≈0.12` to about 0.33 at `L≈2.0`. Only `Kp=0.25` and `Kp=0.5` (`L≈0.12`, `0.25`) genuinely qualify as small gain (`L≪1`); `Kp=1` has `L≈0.5`, and `Kp=2` (`L≈1`) and `Kp=4` (`L≈2`) are comparable and strong feedback. The measured droop is consistently a little below the prediction (the block settles slightly closer to the setpoint), consistent with `χ_h = P_u/H` being a local approximation: the Module 4 heating slope spans 0–45 PWM, whereas these runs use only about 2–19 PWM near 24–28 °C, so `P_u` and `H` are not exactly constant. A heating setpoint uses `χ_h = 0.4954`; a cooling setpoint would instead use the cooling magnitude `0.1414 °C/PWM`, so this comparison is specific to the heating branch. Different starting temperatures also prevent a controlled settling-time comparison.

### First-order (transient) expectation

The algebraic model gives only the steady droop. For time dependence, define `θ = T − T_ss`. The one-lump P-only model gives

`dθ/dt = −θ/τ_cl`,  `τ_cl = C/(H + P_u Kp)`,

so `θ(t) = θ(0) e^(−t/τ_cl)`: under its assumptions, the response approaches steady state exponentially and cannot sustain an oscillation. The 2026-09-30 sweep shows no sustained oscillation up to `Kp=4` (`L≈1.98`), consistent with this picture. The October 7 `Kp=250` run **does** oscillate, so this simple model is insufficient for that run. It assumes instantaneous, unsaturated actuation and a single uniform temperature; the observed PWM clipping and possible thermal or measurement delay violate or may violate those assumptions. The data show the model's limitation but do not by themselves identify a unique mechanism.

This derivation is preserved for the A3 feedback-and-model memo.
