zhuyanheng/Phys39-teamR-X/docs/module_notes/module_06_p_pi_model.md

# Module 6, Part I: P/PI control and lumped modeling

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

## Part 1: Algebraic droop model

### 1a. Derivation

The measured Module 4 open-loop steady-state relationship (signed PWM `u`, positive = heat) is

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

P-only feedback supplies

`u = Kp (T_set − T)`.

Substitute the controller law into the open-loop relationship:

`T = T_amb + χ_{T,u} Kp (T_set − T)`.

At steady state, collect all terms containing `T`:

`(1 + χ_{T,u} Kp) T = T_amb + χ_{T,u} Kp T_set`.

Subtract this from `T_set` to isolate the droop:

`T_set − T = (T_set − T_amb) / (1 + χ_{T,u} Kp)`.

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

### 1b. Numerical check (one Module 5 gain sweep)

Measured inputs (2026-09-30 sweep, 30 °C heating setpoint):

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

Detailed example, `Kp = 2 PWM/°C`:

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

Measured droop decreases with gain and tracks the prediction to within 0.02–0.23 °C (a few hundredths of the full `e_0 = 6.81 °C`). Source values are in [`part_04_droop_comparison.csv`](../../Module_5/data/part_04_droop_comparison.csv) and the [Module 5 note](module_05_p_control.md).

### 1c. One physical reason the prediction differs

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

## Part 2: dimensional energy balance and measured parameters

The First Law gives

\[
C\frac{dT}{dt}=P_u u-H(T-T_{\rm amb}).
\]

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

\[
\frac{dT}{dt}=\frac{T_{\rm amb}+\chi_{T,u}u-T}{\tau}.
\]

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

### Integrated Module 5 interpretation questions

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

## Part 3: time constant and its uncertainty

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

\[
T_{63.2}=T_0+(1-e^{-1})(T_f-T_0)
\]

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

H0/C0 and H4/C4 are excluded from time-constant estimation because there is no meaningful captured step or sufficient final-command duration. H1 still has endpoint drift and insufficient duration for 3τ+60 s. Having enough duration in other rows does not establish a noise/drift acceptance criterion. The [Module 4 protocol audit](module_04_open_loop_tec.md#revised-steady-state-protocol-audit) remains applicable.

Time-constant estimates

## Part 4: official v3 open-loop comparison

The official v3 source is preserved unchanged at `python/Lab_6_7_modeling_tec_v3.py`. Download URL and SHA256 are recorded in [`analysis_results.json`](../../data/module_06/analysis_results.json).

From the five provisional points per direction, ordinary unweighted straight-line fits with free intercept give:

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

The fitted intercepts and slope sensitivity after excluding each maximum endpoint are in [`susceptibility.csv`](../../data/module_06/susceptibility.csv). The fit is provisional; five selected windows are not five independently validated equilibria.

Susceptibility

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

Open-loop comparison

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

## Parts 5–6: P-only simulation and analytic solution

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

P droop

Measured and simulated P transient

The Kp=2 transient starts from the first P-active measurement, with the same measured starting temperature for its simulation. Firmware PWM is delayed relative to the newly computed Python command and is integer-rounded; v3 applies a continuous-valued command. This explains why the two PWM traces should not match sample by sample. The existing record says no oscillation was observed through Kp=4. Do not infer an instability threshold or oscillation frequency from these stable runs; the current Module 5 onset-evidence requirement remains incomplete.

## Part 7: matched simulated P/PI comparison

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

P/PI simulation

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

### Physical PI implementation and matched measurements — pending

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

## Part 8: windup thought experiment

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

Windup simulation

This is a **simulation-only** demonstration: setpoint 60 °C for 400 s, then 30 °C, Kp=2, Ki=0.08, limit ±15 PWM, otherwise the same model. The first setpoint is unreachable because maximum heating equilibrium is about 30.62 °C. Without anti-windup, the I contribution reaches about 983.39 PWM counts at the switch and the model remains near 30.62 °C through 1400 s. Conditional integration prevents that accumulation and the model returns near 30 °C. The 60 °C setting is not a physical run instruction. Numeric data are in [`windup_comparison.csv`](../../data/module_06/windup_comparison.csv).

## Part 9: reproduction and evidence checkpoint

Authoritative inputs: unchanged Module 4 raw CSVs and selected summary, unchanged Module 5 raw CSVs and droop summary, and the official v3 source. Raw hashes, parameters and output values are stored in [`analysis_results.json`](../../data/module_06/analysis_results.json). Derived outputs live in `data/module_06/` and `docs/figures/module_06/`.

From the repository root:

```bash
.venv/bin/python -m pip install -r python/analysis/requirements.txt
.venv/bin/python python/analysis/module_06_analysis.py
.venv/bin/python python/Lab_6_7_modeling_tec_v3.py
```

The first analysis command produces all numerical tables and seven PNG/SVG figures using the official v3 computation core. The GUI command is separate; no screenshot of a GUI experiment is claimed. A companion executed notebook is `python/analysis/module_06_analysis.ipynb`. Numerical validation is recorded in [`numerical_checks.csv`](../../data/module_06/numerical_checks.csv). Simulation CSVs preserve solver outputs at 0.5 s export cadence, with solver dt=0.1 s; `StepResult` reports post-step temperature alongside the command used over the preceding Euler step.

This local checkpoint has not yet been committed or pushed. Before submission, commit the completed evidence, push it, and replace this status with a verified GitHub commit permalink. The draft [A3 memo](../assessments/a3_feedback_model.md) remains incomplete until physical P/PI and required onset evidence are supplied.

## What the team still needs to do

- Review/extend Module 4 calibration where required by the existing steady-state audit.
- Explain the derivation and the selected parameters without relying on the AI transcript.
- Prepare and review the physical PI controller with the instructor; collect matched P/PI evidence and tune gains.
- Obtain instructor-approved Module 5 instability/onset evidence or document an accepted limitation; no threshold is inferred here.
- Insert physical results, verify the Git checkpoint, and produce `A3_Huang_Zhu.pdf`. Each teammate separately uploads the team PDF to Moodle by Wednesday, October 21, 2026, 6:00 PM.

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
