zhuyanheng/Phys39-teamR-X/Module_8/docs/README.md

# Module 8 documentation index

| File | Purpose |
| --- | --- |
| `../README.md` | Module structure, programs, status, output locations and deadlines |
| `theory_and_analysis.md` | Periodic derivation, offline fitting/viewer, reproduction and uncertainty limits |
| `serial_protocol.md` | Commands, schema, events, timing and safety state |
| `verification.json` | Current software verification and build results |
| `source_manifest.json` | Original copied files and their source SHA-256 hashes |
| `../../docs/module_notes/module_08_angstrom.md` | Current setup and experimental evidence status |
| `../../docs/module_notes/module_08_lab_day_runbook_2026-11-04.md` | Ordered trials and acceptance gates |
| `../../docs/module_notes/module_08_modeling_app.md` | Implemented offline analysis and remaining experimental requirements |

Course evidence remains in repository-root `docs/`, consistent with Modules 1–7.
