zhuyanheng/Phys39-teamR-X/Module_6/docs/README.md

# Module 6 文档索引

| 文档 | 用途 |
|---|---|
| [a3_feedback_model.md](a3_feedback_model.md) | A3 完整英文报告；[当前 PDF](../output/pdf/A3_Huang_Zhu.pdf) |
| [experiment_analysis_2026-10-21.md](experiment_analysis_2026-10-21.md) | 当前六组Module 6实测定量分析 |
| [experiment_analysis_2026-10-19.md](experiment_analysis_2026-10-19.md) | 已替代的旧P分析记录 |
| [pi_comparison_2026-10-19.md](pi_comparison_2026-10-19.md) | 三组PI对照 |
| [pi_run_ki_0p1_2026-10-19.md](pi_run_ki_0p1_2026-10-19.md) | 第一组PI收数记录 |
| [two_lump_simulation_log_2026-10-19.md](two_lump_simulation_log_2026-10-19.md) | 六张 two-lump 截图检查；旧 P 配对说明已由21日新数据替代 |
| [one_lump_model_notes.md](one_lump_model_notes.md) | 早期理论、标定和one-lump记录 |
| [gui_simulation_log_2026-10-13.md](gui_simulation_log_2026-10-13.md) | 早期GUI操作日志 |
| [pi_controller_guide_zh.md](pi_controller_guide_zh.md) | 实物控制器说明 |
| [file_organization_2026-10-21.json](file_organization_2026-10-21.json) | 改名路径、SHA256及检查清单 |

历史记录描述当时状态；当前结果优先阅读 A3 及 [10月21日实验分析](experiment_analysis_2026-10-21.md)。19日 PI 对照记录仍适用；含旧 Module 5 P 的分析只作历史资料。

10月21日新 P 命名与来源校验：[new_p_data_selection_2026-10-21.json](new_p_data_selection_2026-10-21.json)。[旧报告归档](../archive/2026-10-21_pre_new_p/README.md)不用于当前 A3。
