zhuyanheng/Phys39-teamR-X/Module_6/data/physical/README.md

# 原始实物 P / PI 数据

以下文件内容保持原样，仅统一文件名。Kp单位PWM/°C，Ki单位PWM/(°C s)。

| 文件 | Kp | Ki | 正式 run_id |
|---|---:|---:|---:|
| [p_kp_0p25_20261021_103204_751306.csv](p_kp_0p25_20261021_103204_751306.csv) | 0.25 | 0 | 1 |
| [p_kp_4_20261021_103836_296838.csv](p_kp_4_20261021_103836_296838.csv) | 4 | 0 | 1 |
| [p_kp_100_20261021_105056_326633.csv](p_kp_100_20261021_105056_326633.csv) | 100 | 0 | 1 |
| [pi_kp_20_ki_0p1_20261019_093424_268559.csv](pi_kp_20_ki_0p1_20261019_093424_268559.csv) | 20 | 0.1 | 3 |
| [pi_kp_20_ki_0p2_20261019_095648_364327.csv](pi_kp_20_ki_0p2_20261019_095648_364327.csv) | 20 | 0.2 | 2 |
| [pi_kp_20_ki_0p5_20261019_101544_769937.csv](pi_kp_20_ki_0p5_20261019_101544_769937.csv) | 20 | 0.5 | 3 |

文件中有连接、停止和短暂试运行，不能把整份 CSV 自动当作一组正式实验。分析选取 `event=measurement`、`control_active=1`、表中 `run_id`，并验证逐行模式与参数，保留同一正式运行里的20→30→20°C过程。

新采集仍按连接时间命名，一次连接可包含多组增益，归档文件名不能替代逐行参数。早期改名对照见[文件整理清单](../../docs/file_organization_2026-10-21.json)。

10月21日新增三组 P，已替代 A3 中旧 Module 5 P。新 P 改名与哈希见[数据选择清单](../../docs/new_p_data_selection_2026-10-21.json)，观测时长与计算定义见[当前分析](../../docs/experiment_analysis_2026-10-21.md)。
