zhuyanheng/Phys39-teamR-X/docs/figures/module_05/high_gain_kp4_trace.png

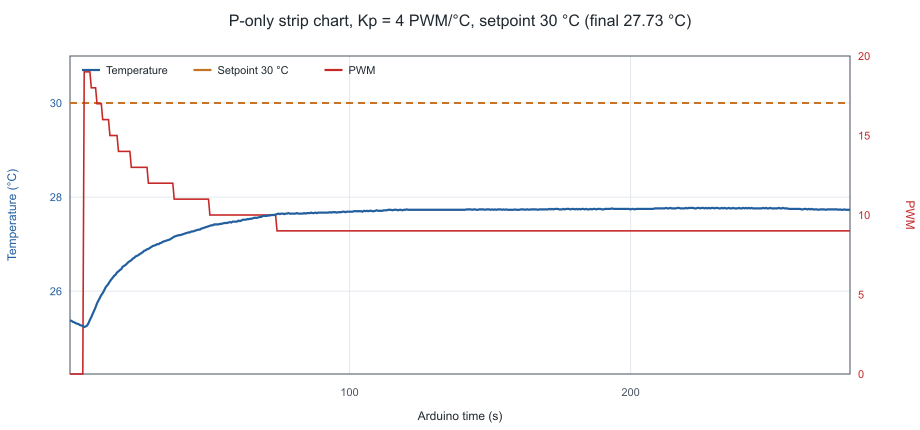
docs/figures/module_05/high_gain_kp4_trace.png
