zhuyanheng/Phys39-teamR-X/docs/figures/module_05/kp250_20to30c_oscillation.png

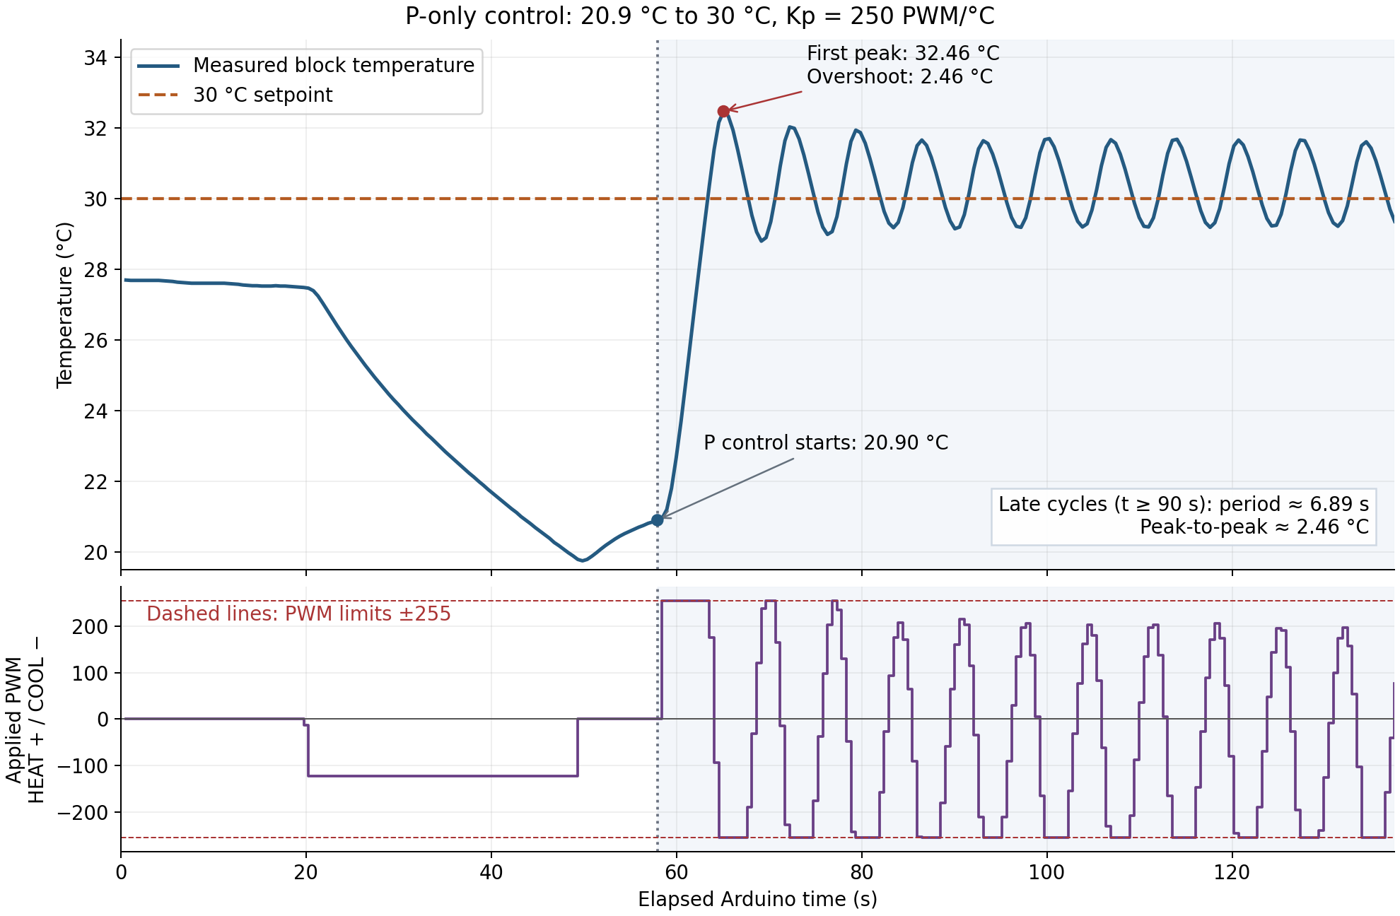
docs/figures/module_05/kp250_20to30c_oscillation.png
