zhuyanheng/Phys39-teamR-X/docs/figures/module_05/low_gain_kp0.25_trace.png

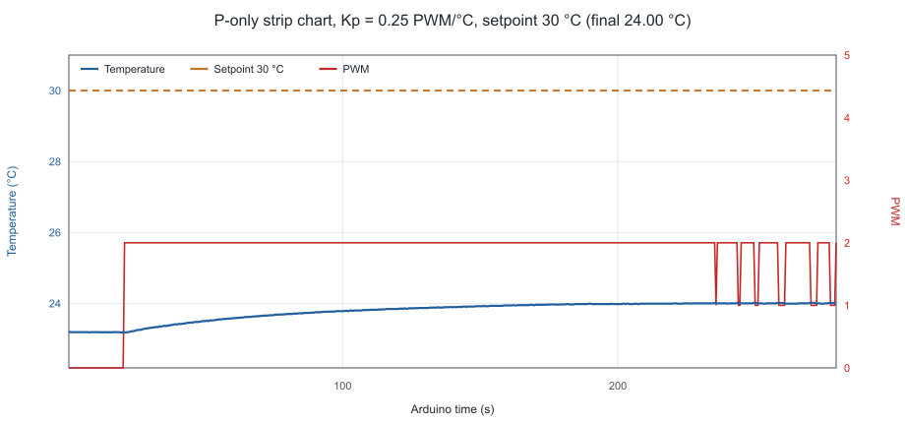
docs/figures/module_05/low_gain_kp0.25_trace.png
