zhuyanheng/Phys39-teamR-X/Module_1/figures/part_2b_potentiometer.png

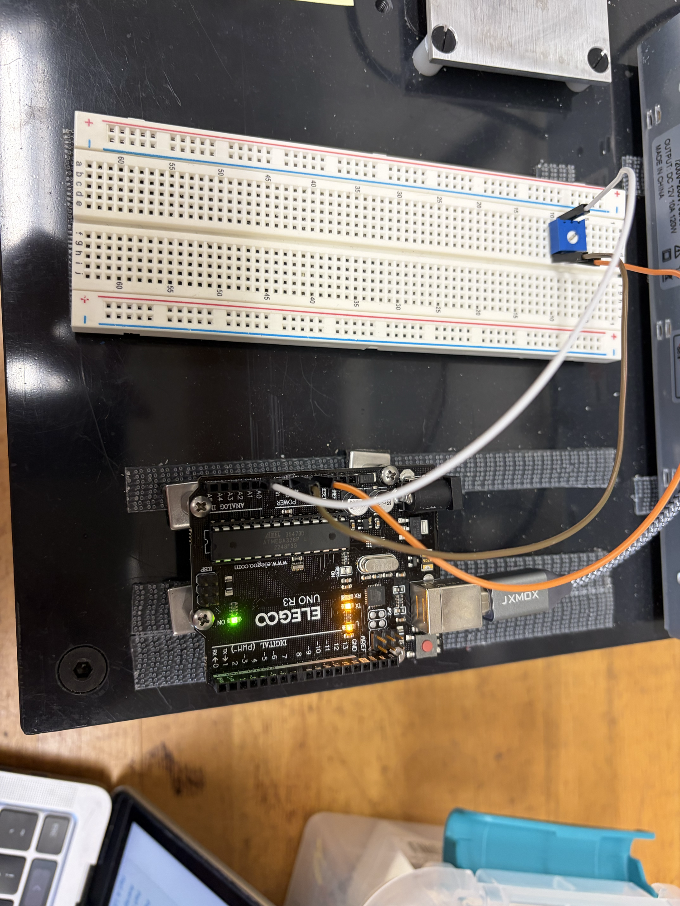
Module_1/figures/part_2b_potentiometer.png
