zhuyanheng/Phys39-teamR-X/Module_1/figures/part_4_oscilloscope.png

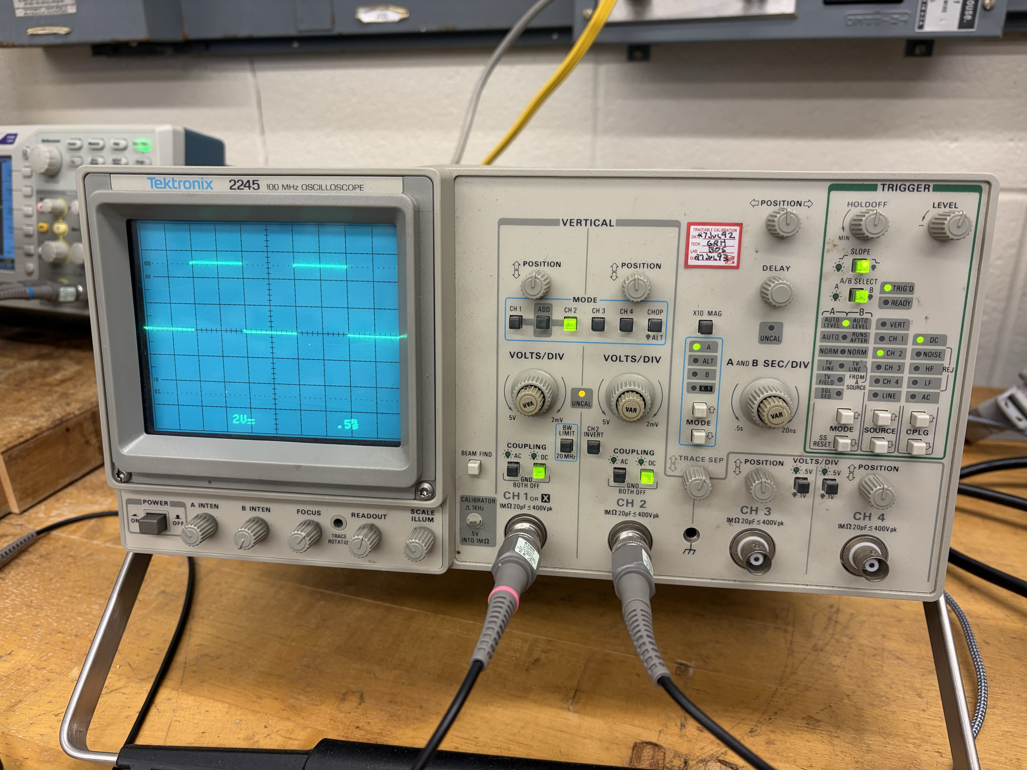
Module_1/figures/part_4_oscilloscope.png
