zhuyanheng/Phys39-teamR-X/Module_2/figures/part_3a_serial_plotter.png

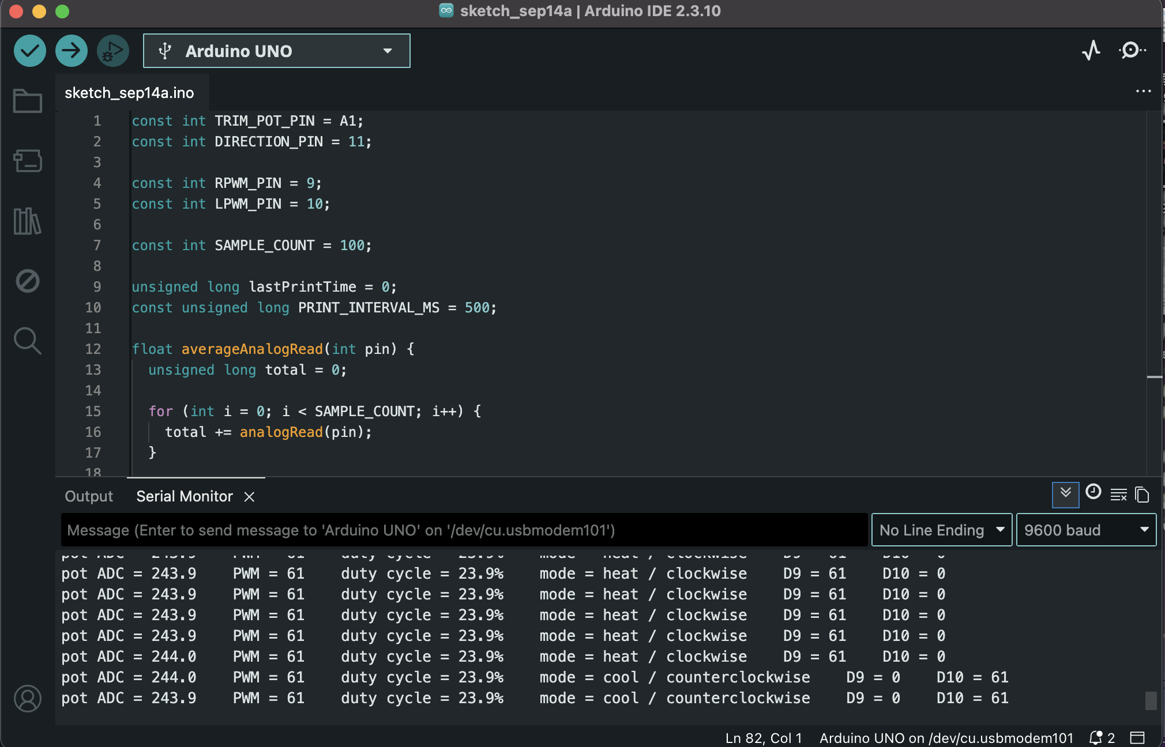
Module_2/figures/part_3a_serial_plotter.png
