zhuyanheng/Phys39-teamR-X/Module_3/figures/part_2_cooling.png

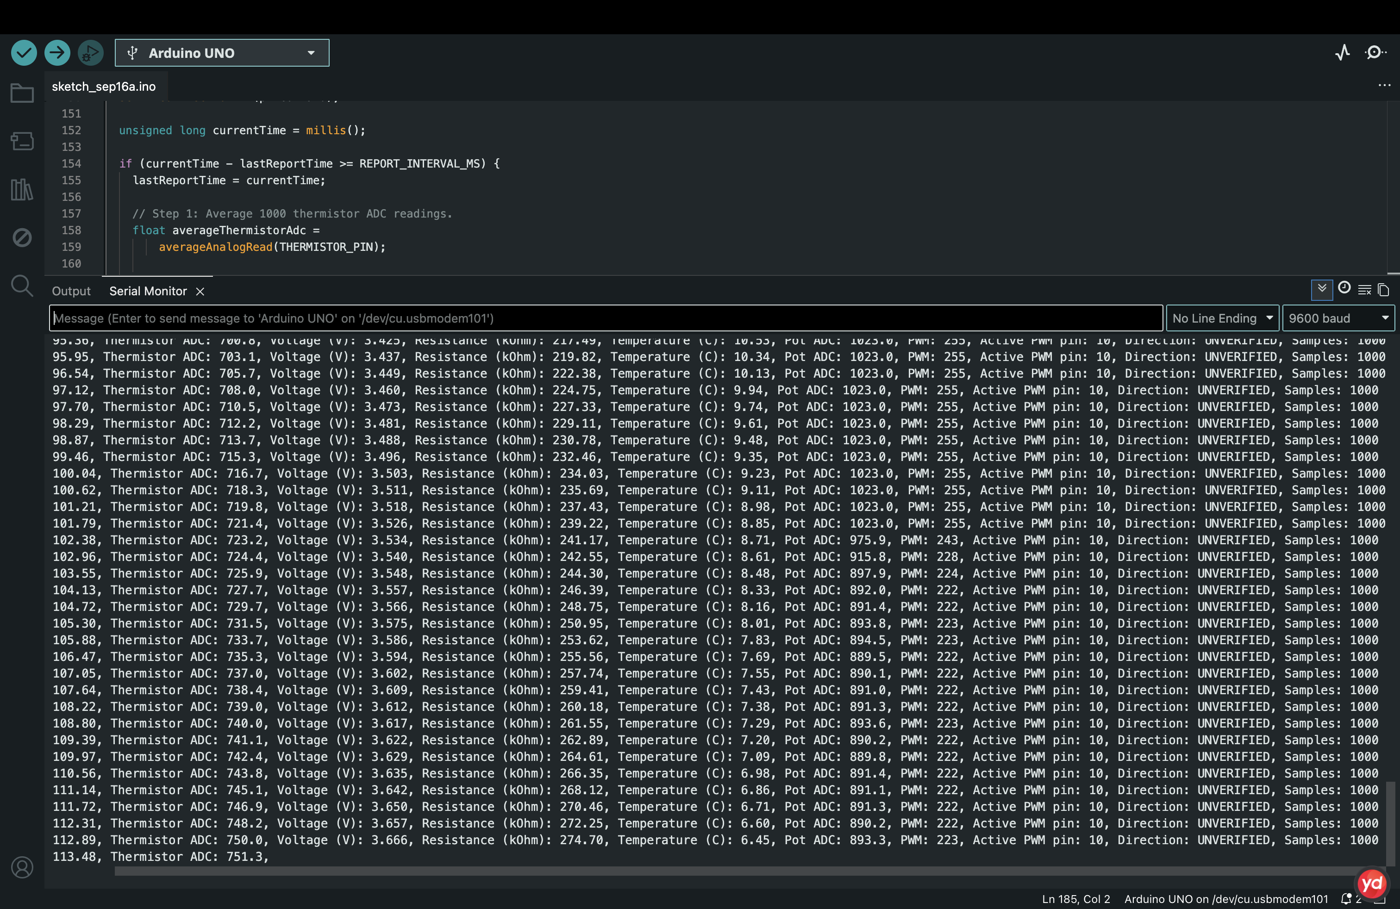
Module_3/figures/part_2_cooling.png
