zhuyanheng/Phys39-teamR-X/Module_3/figures/part_3_switch_between_cooling_heating.png

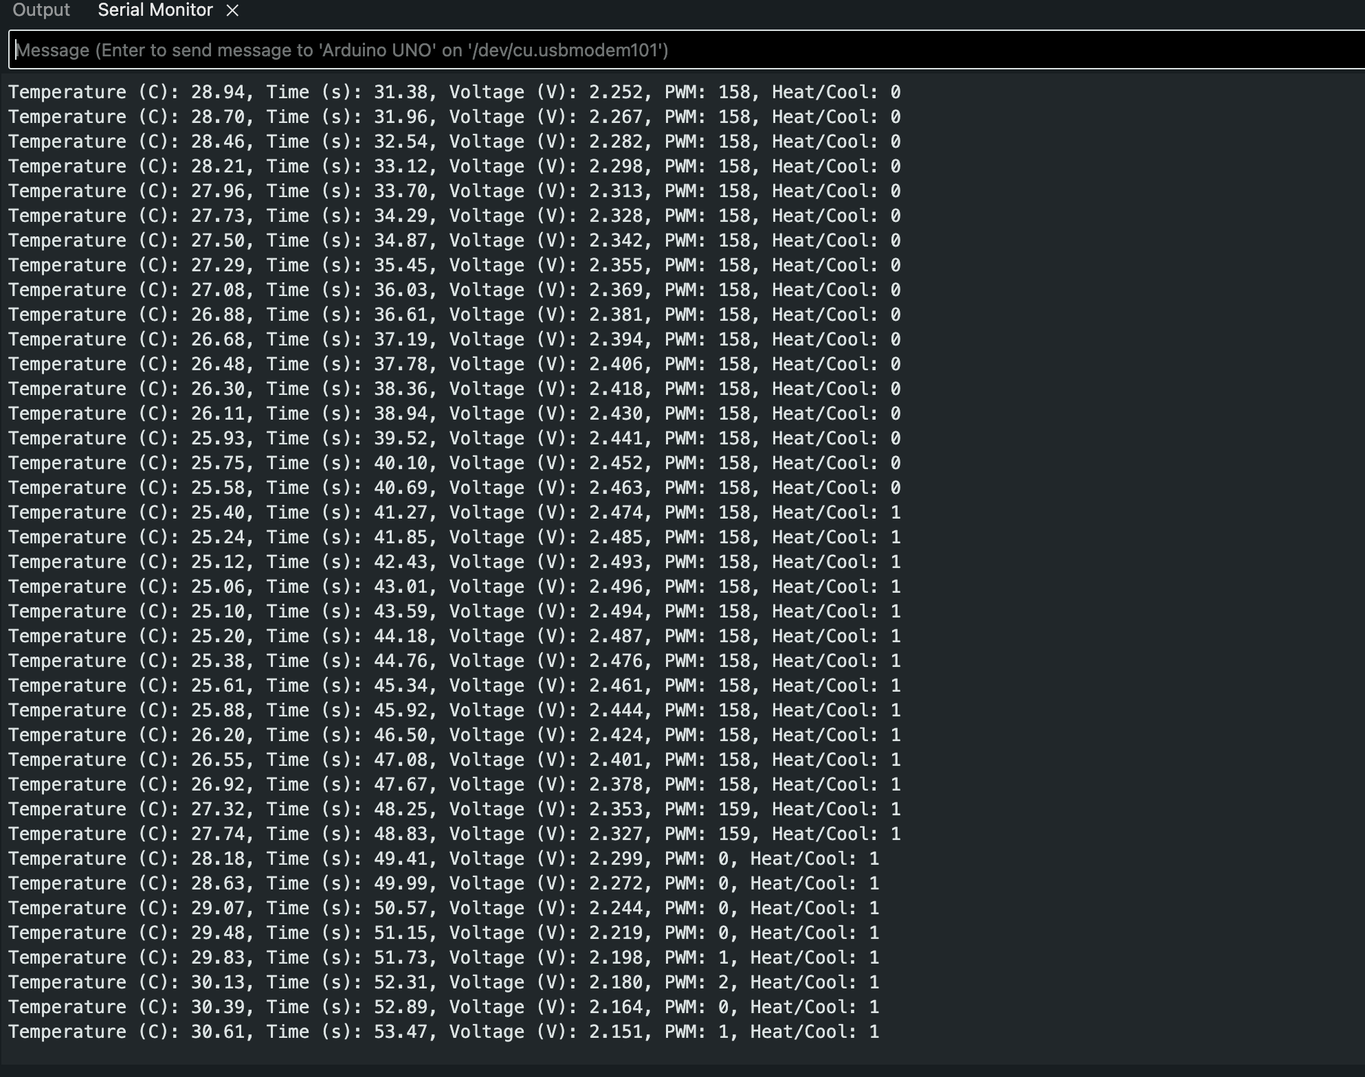
Module_3/figures/part_3_switch_between_cooling_heating.png
