zhuyanheng/Phys39-teamR-X/Module_3/figures/part_4_temperature_graph.png

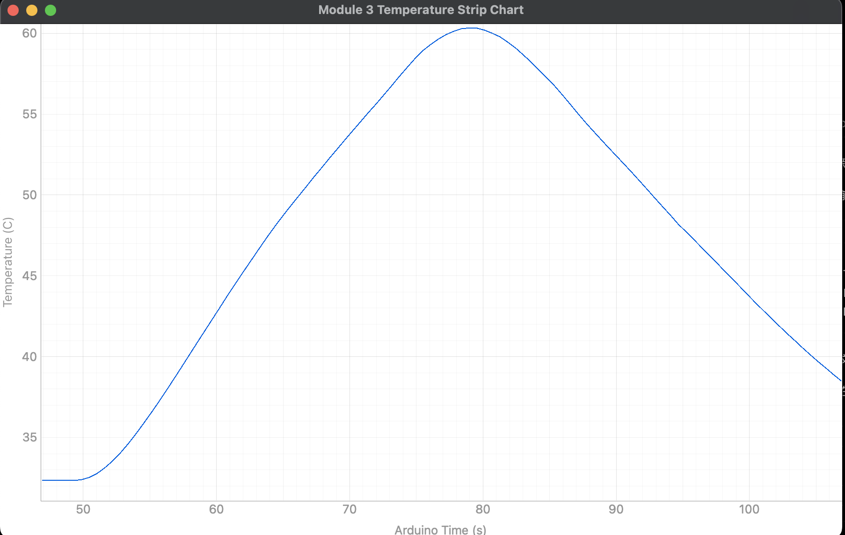
Module_3/figures/part_4_temperature_graph.png
