zhuyanheng/Phys39-teamR-X/Module_3/figures/part_5_GUI_without_actual_control.png

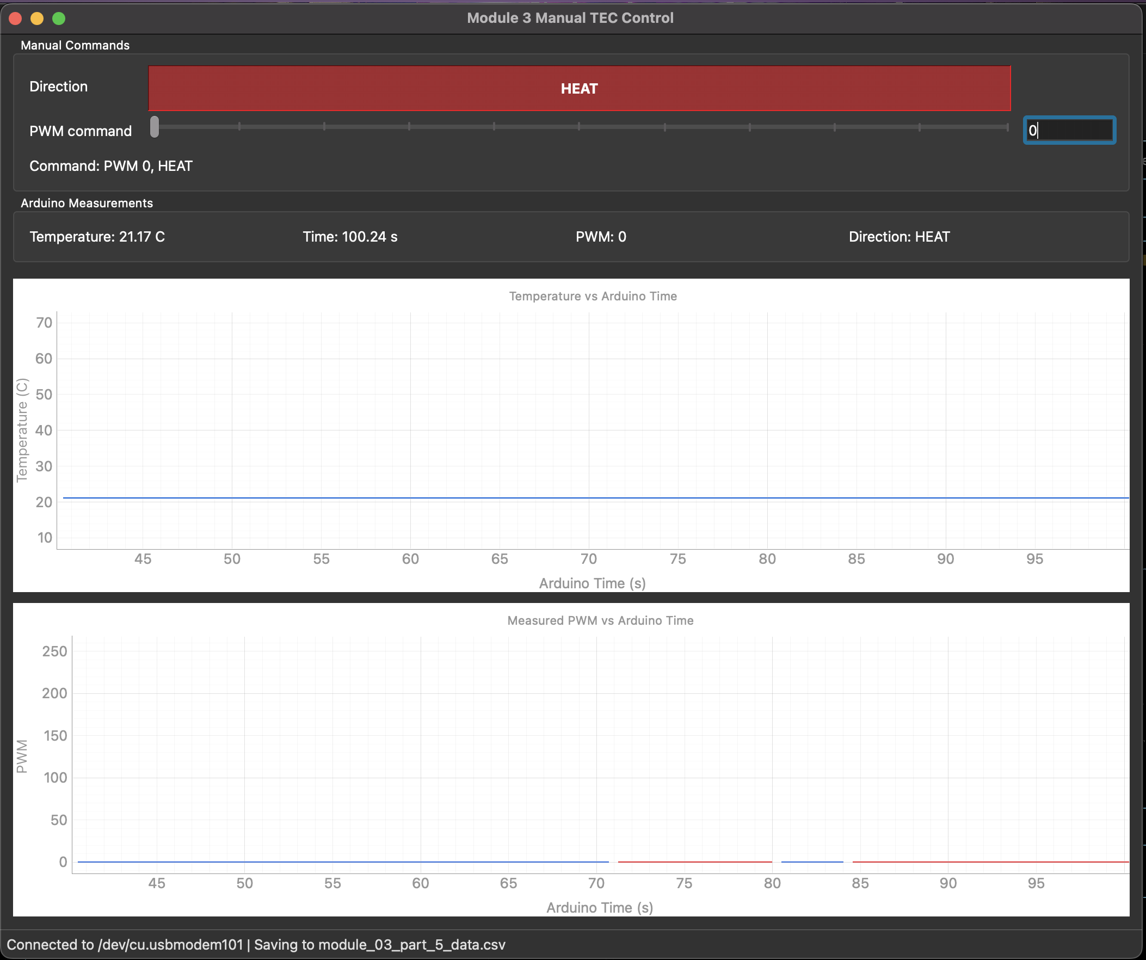
Module_3/figures/part_5_GUI_without_actual_control.png
