zhuyanheng/Phys39-teamR-X/Module_3/figures/part_6_TEC_control_using_GUI_1.png

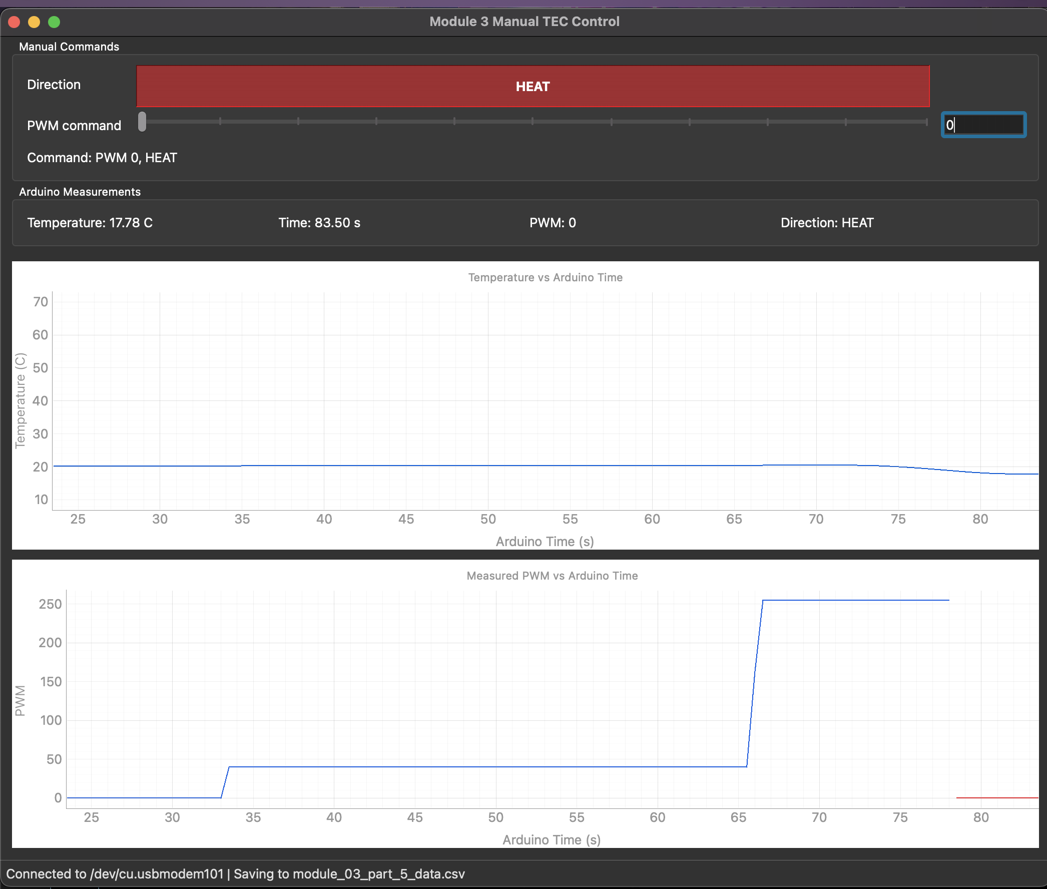
Module_3/figures/part_6_TEC_control_using_GUI_1.png
