zhuyanheng/Phys39-teamR-X/Module_3/figures/part_6_TEC_control_using_GUI_2.png

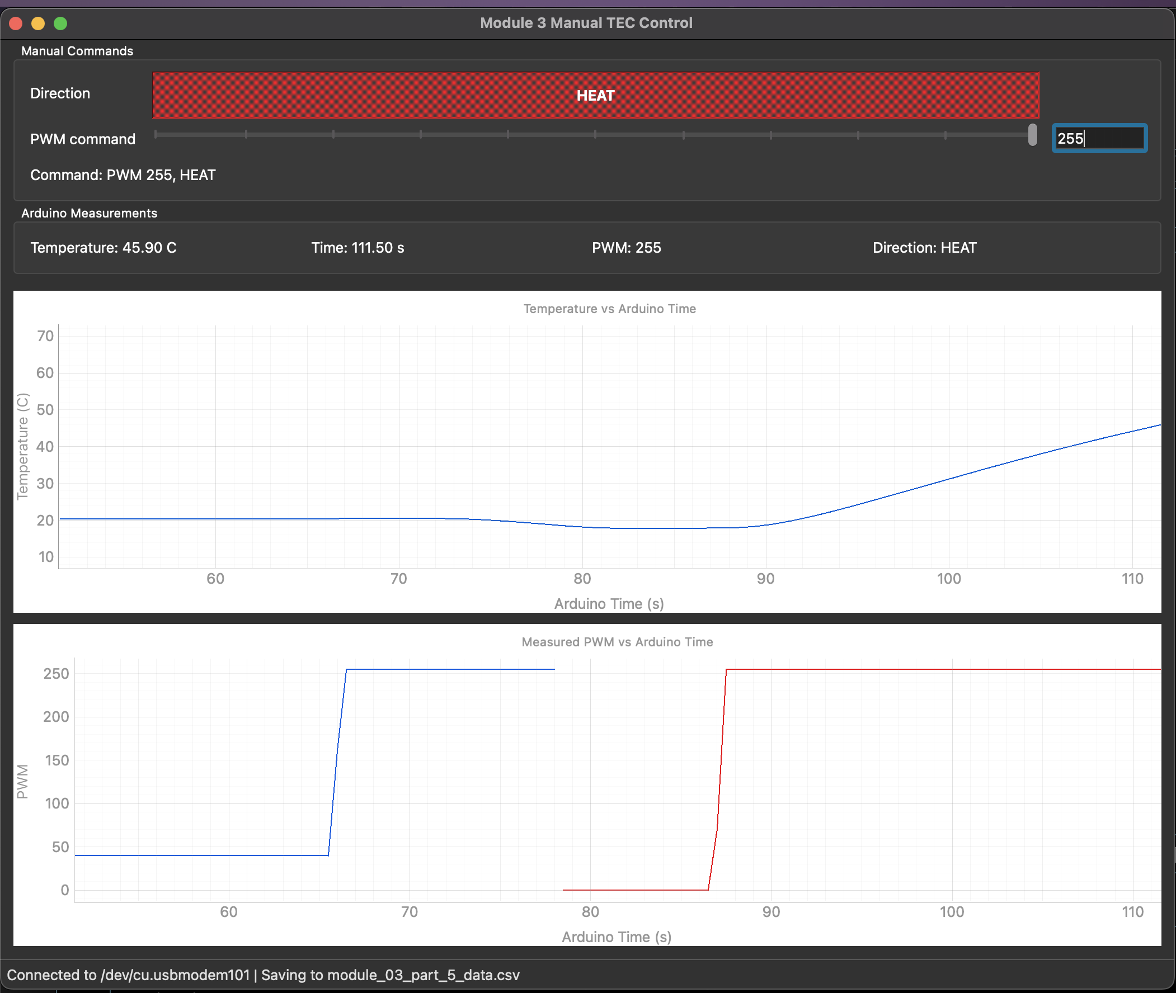
Module_3/figures/part_6_TEC_control_using_GUI_2.png
