zhuyanheng/Phys39-teamR-X/Module_3/figures/part_7_cooling.png

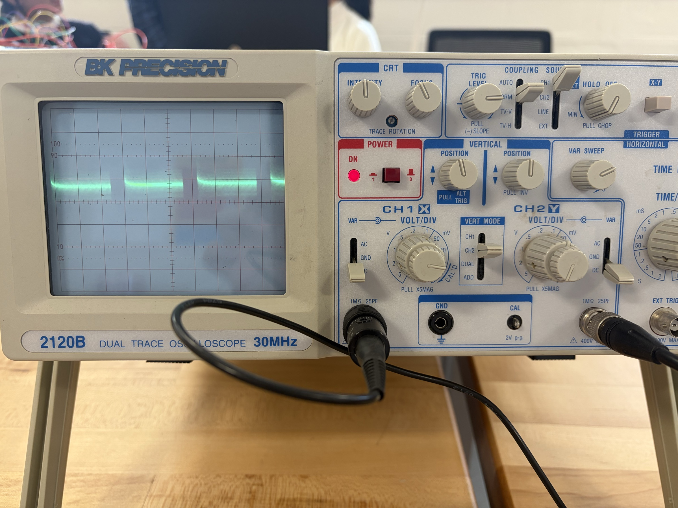
Module_3/figures/part_7_cooling.png
