zhuyanheng/Phys39-teamR-X/Module_3/figures/part_7_GUI.png

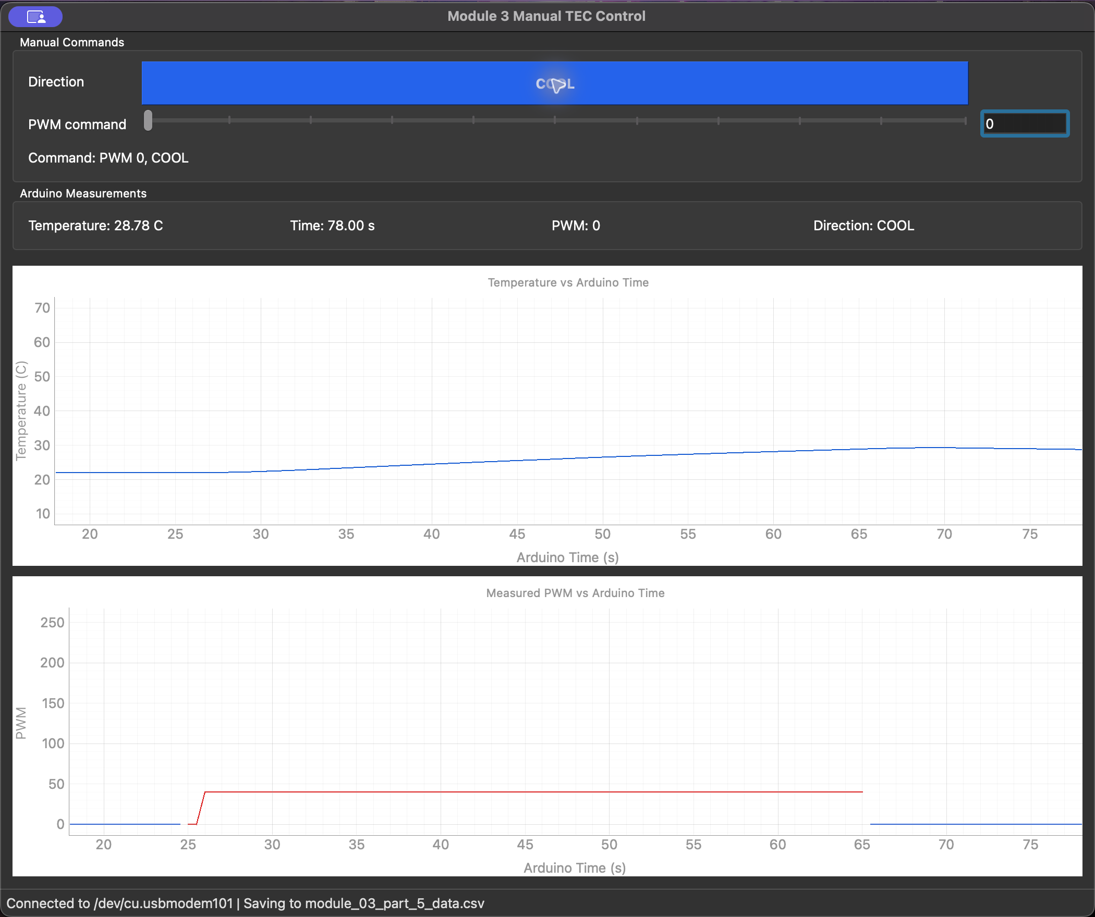
Module_3/figures/part_7_GUI.png
