zhuyanheng/Phys39-teamR-X/Module_3/figures/part_7_heat_cool_record.png

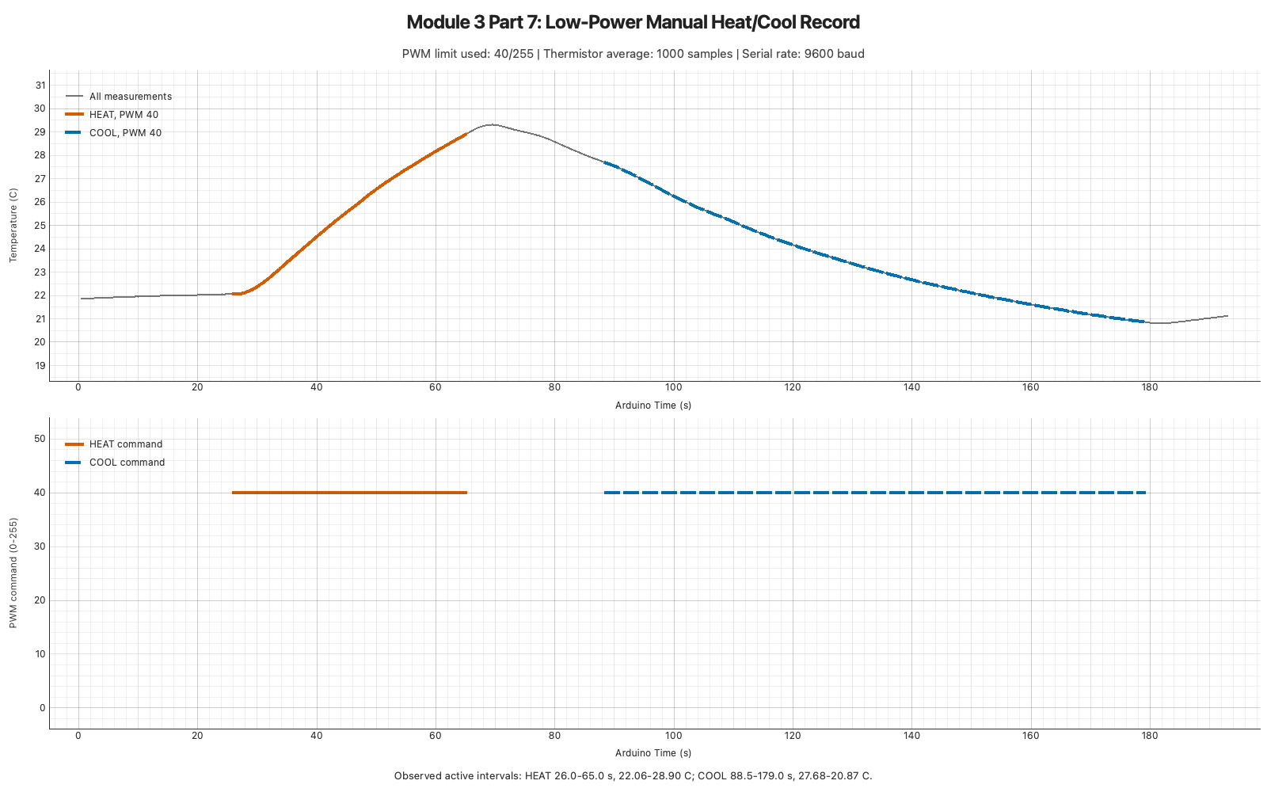
Module_3/figures/part_7_heat_cool_record.png
