zhuyanheng/Phys39-teamR-X/Module_3/figures/part_7_heating.png

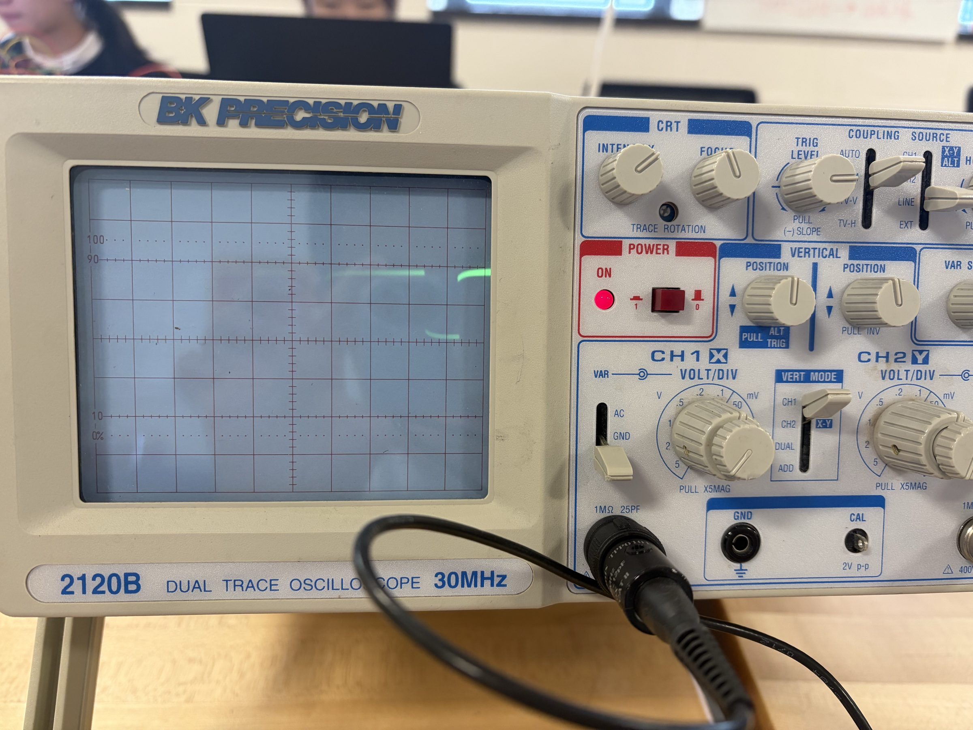
Module_3/figures/part_7_heating.png
