zhuyanheng/Phys39-teamR-X/Module_4/figures/part_1_heating_high_current.png

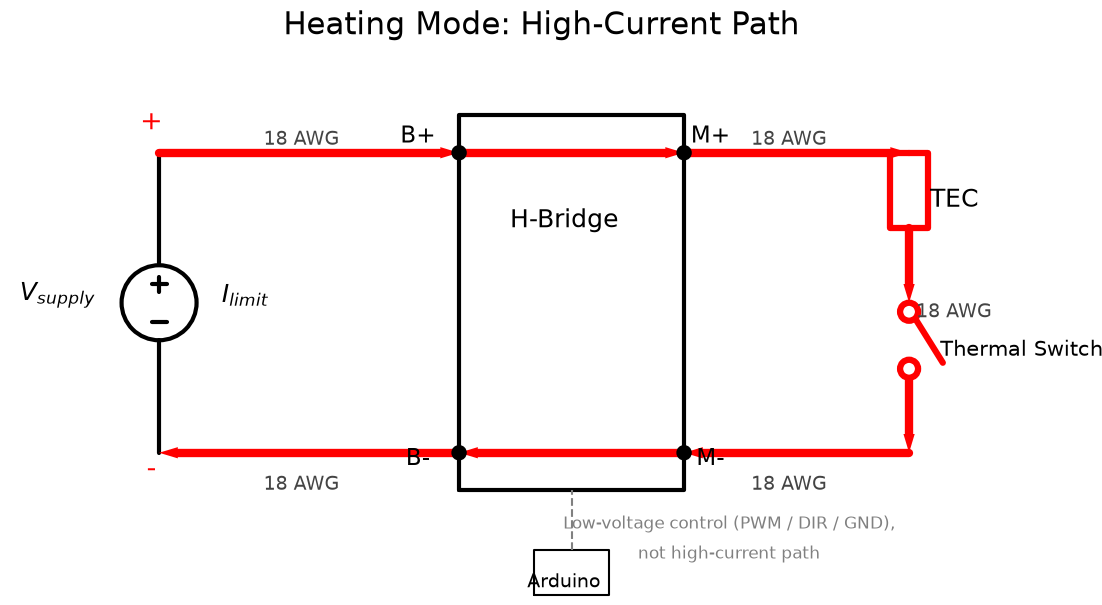
Module_4/figures/part_1_heating_high_current.png
