zhuyanheng/Phys39-teamR-X/Module_4/figures/part_4_cooling_trace.png

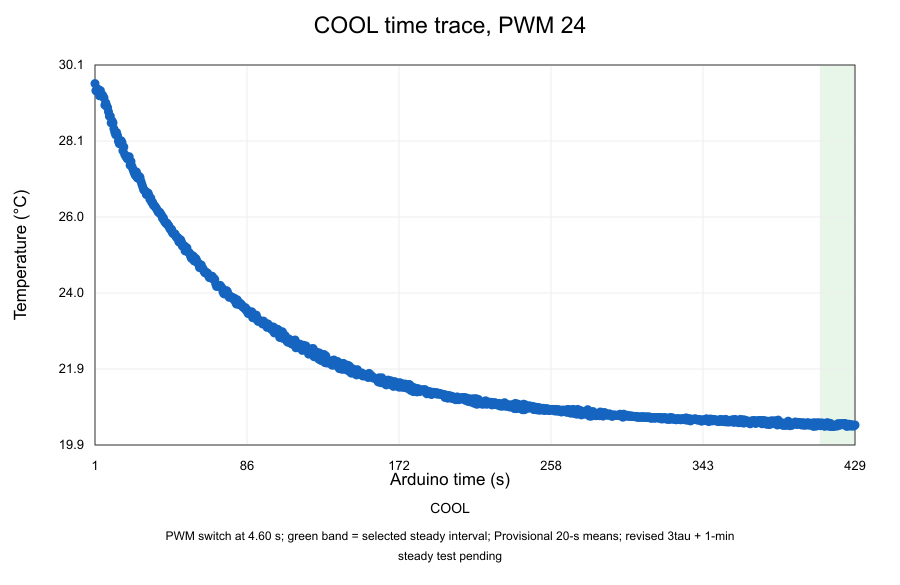
Module_4/figures/part_4_cooling_trace.png
