zhuyanheng/Phys39-teamR-X/Module_4/figures/part_4_heating_trace.png

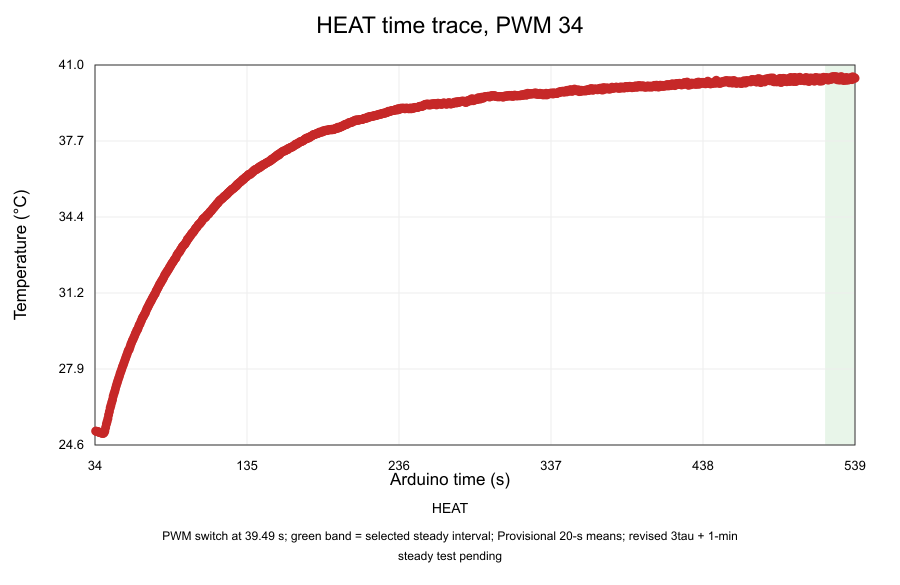
Module_4/figures/part_4_heating_trace.png
