zhuyanheng/Phys39-teamR-X/Module_4/figures/part_4_steady_temperature_vs_pwm.png

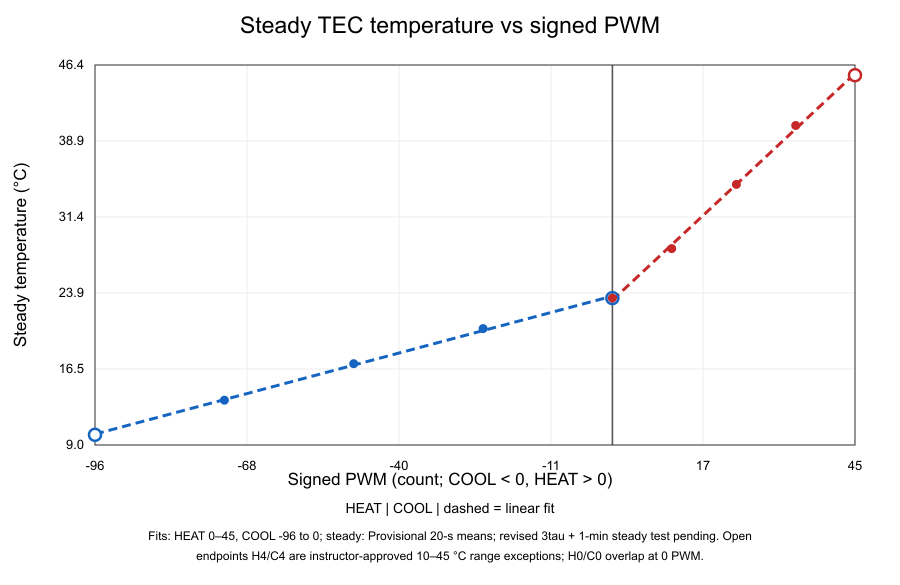
Module_4/figures/part_4_steady_temperature_vs_pwm.png
