zhuyanheng/Phys39-teamR-X/Module_6/figures/2lump_kp0.25.png

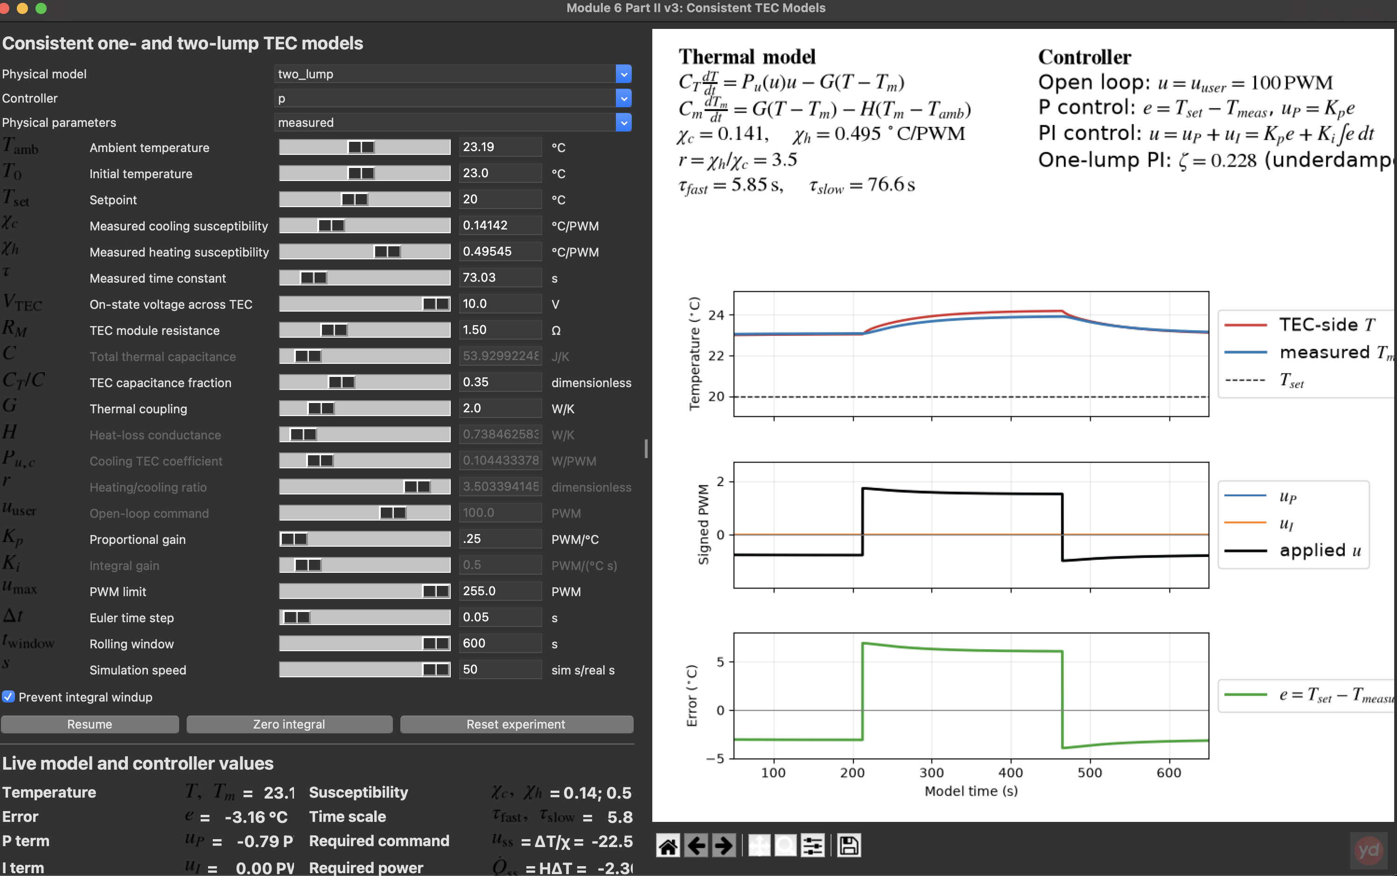
Module_6/figures/2lump_kp0.25.png
