zhuyanheng/Phys39-teamR-X/Module_6/figures/2lump_kp20_ki0.2.png

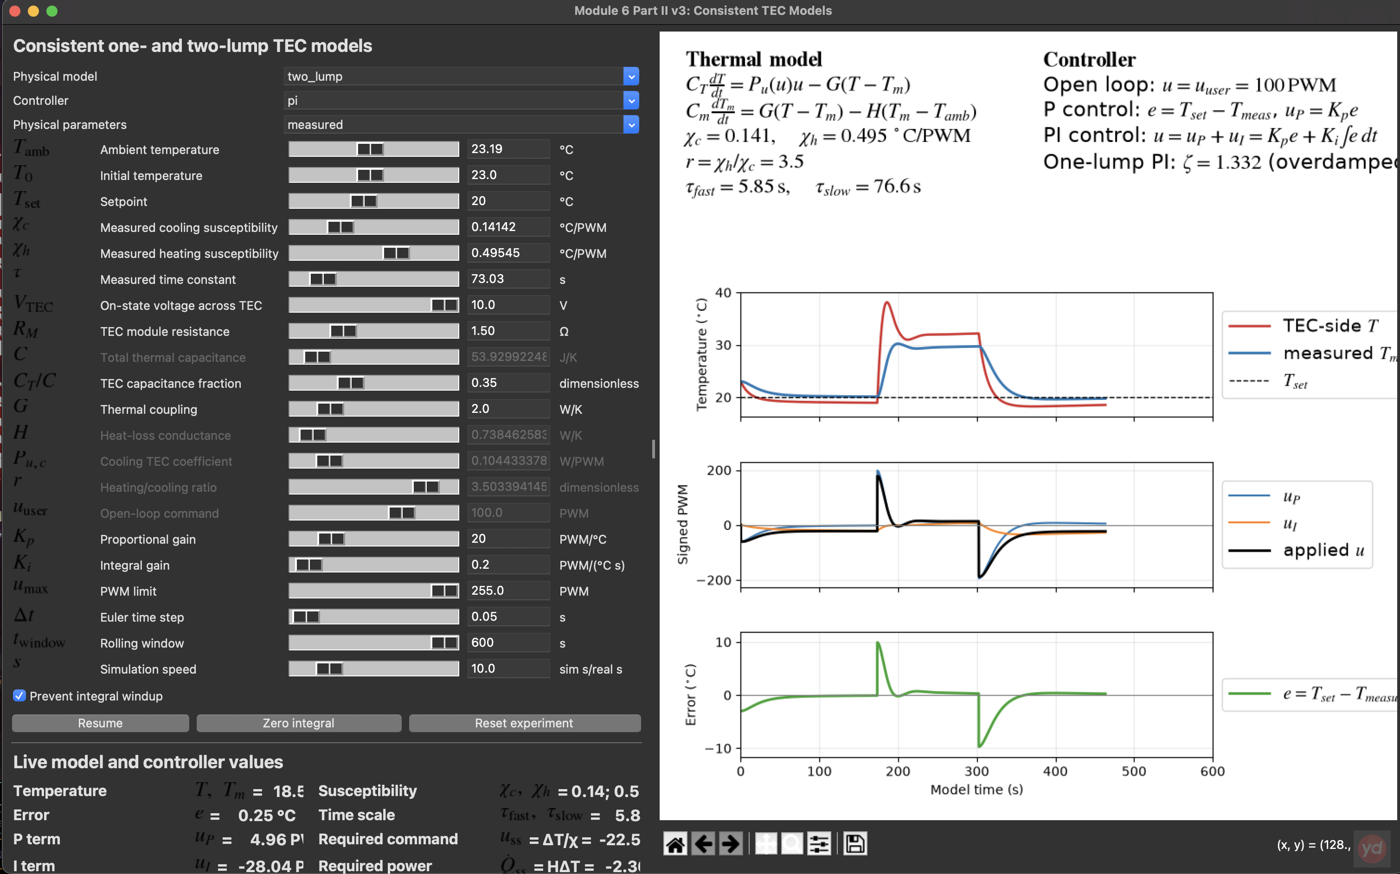
Module_6/figures/2lump_kp20_ki0.2.png
