zhuyanheng/Phys39-teamR-X/Module_6/figures/a3/exp_p_kp_250.png

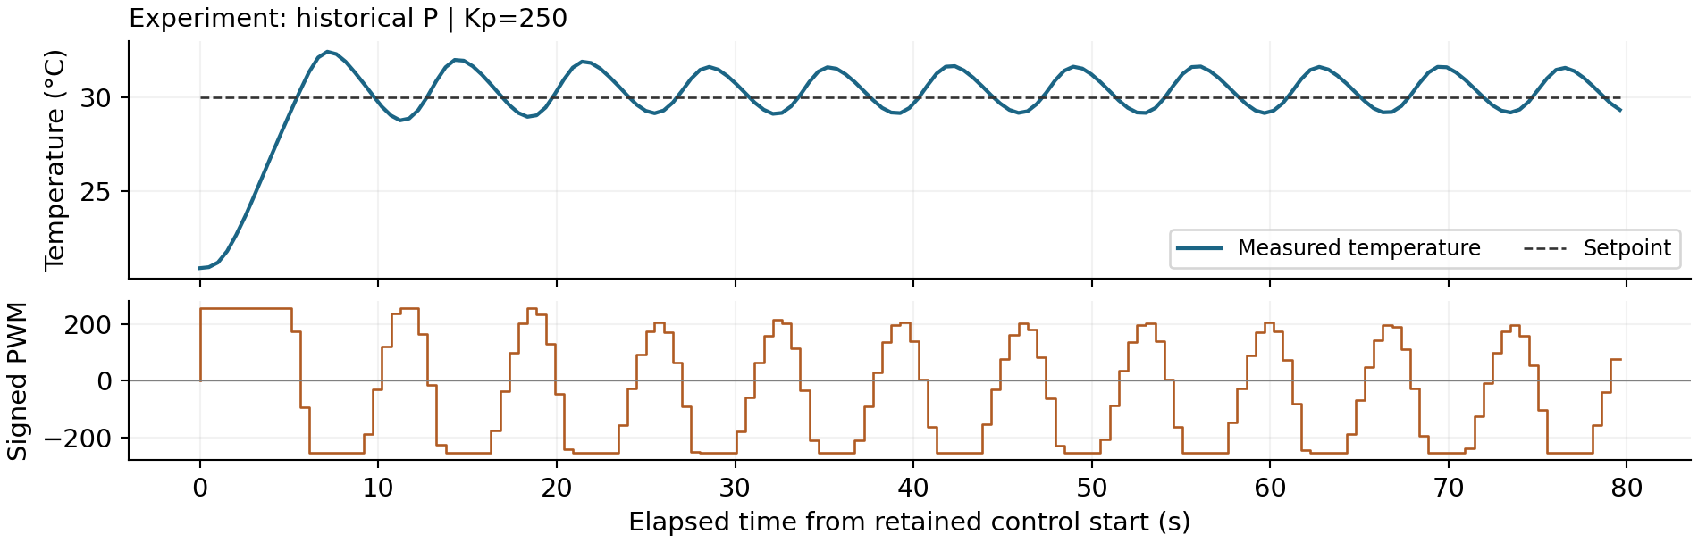
Module_6/figures/a3/exp_p_kp_250.png
