zhuyanheng/Phys39-teamR-X/Module_6/figures/PI_kp2_ki0.08.png

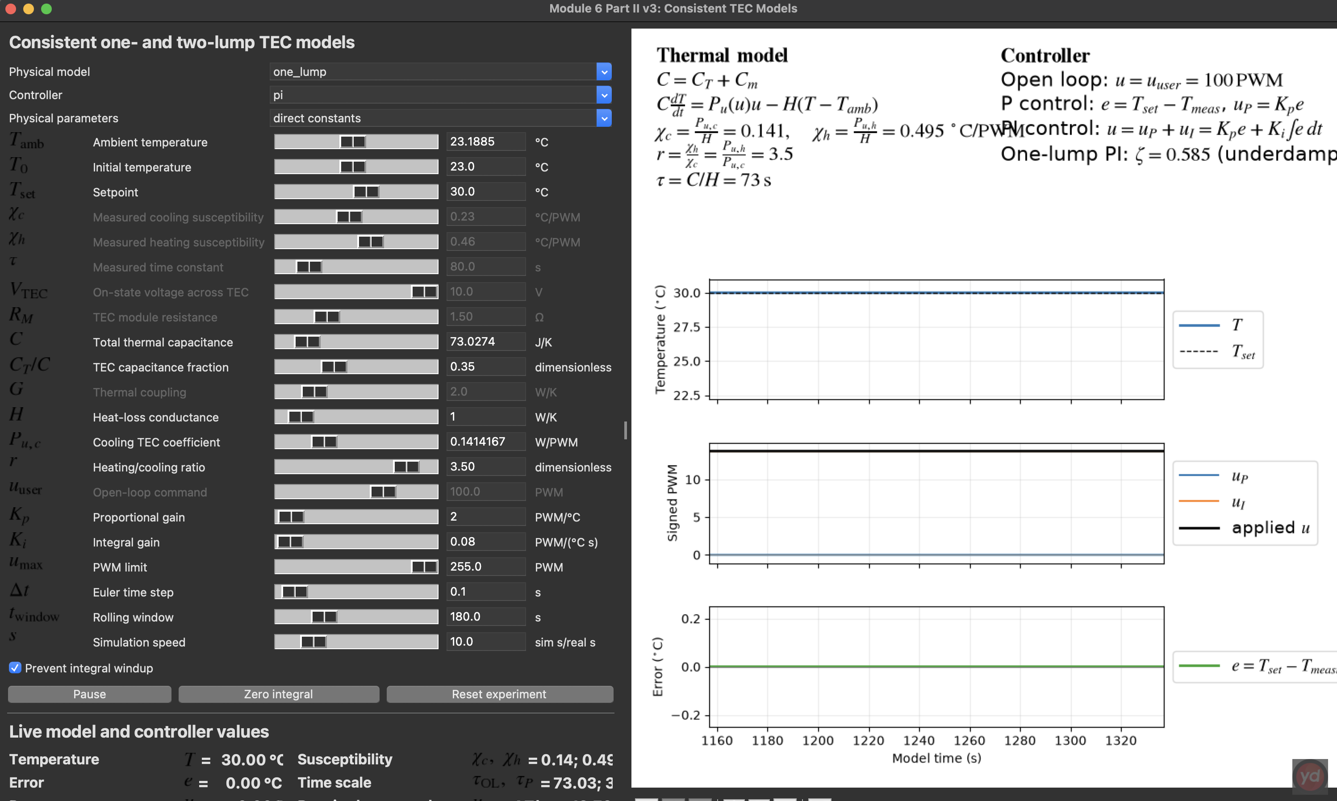
Module_6/figures/PI_kp2_ki0.08.png
