zhuyanheng/Phys39-teamR-X/Module_6/figures/retained_analysis/P_kp250.png

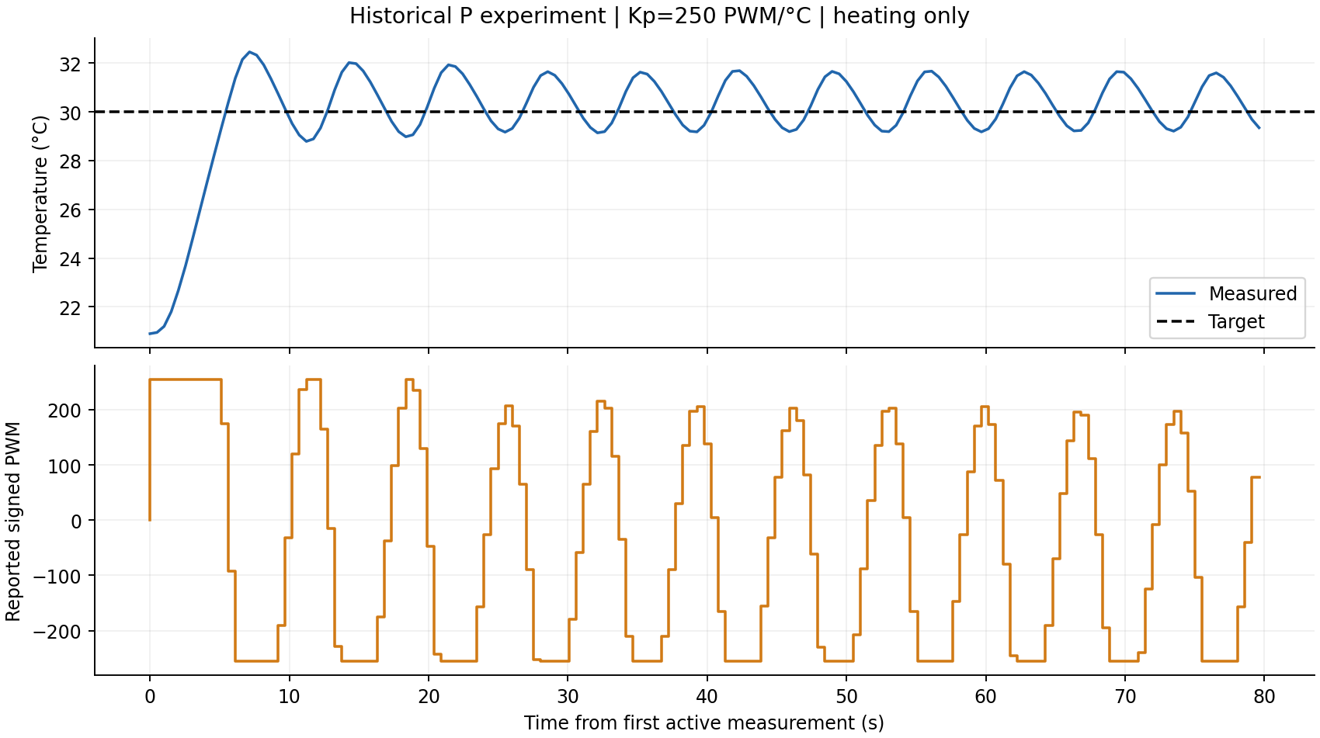
Module_6/figures/retained_analysis/P_kp250.png
