zhuyanheng/Phys39-teamR-X/Module_6/figures/retained_analysis/PI_ki0p2.png

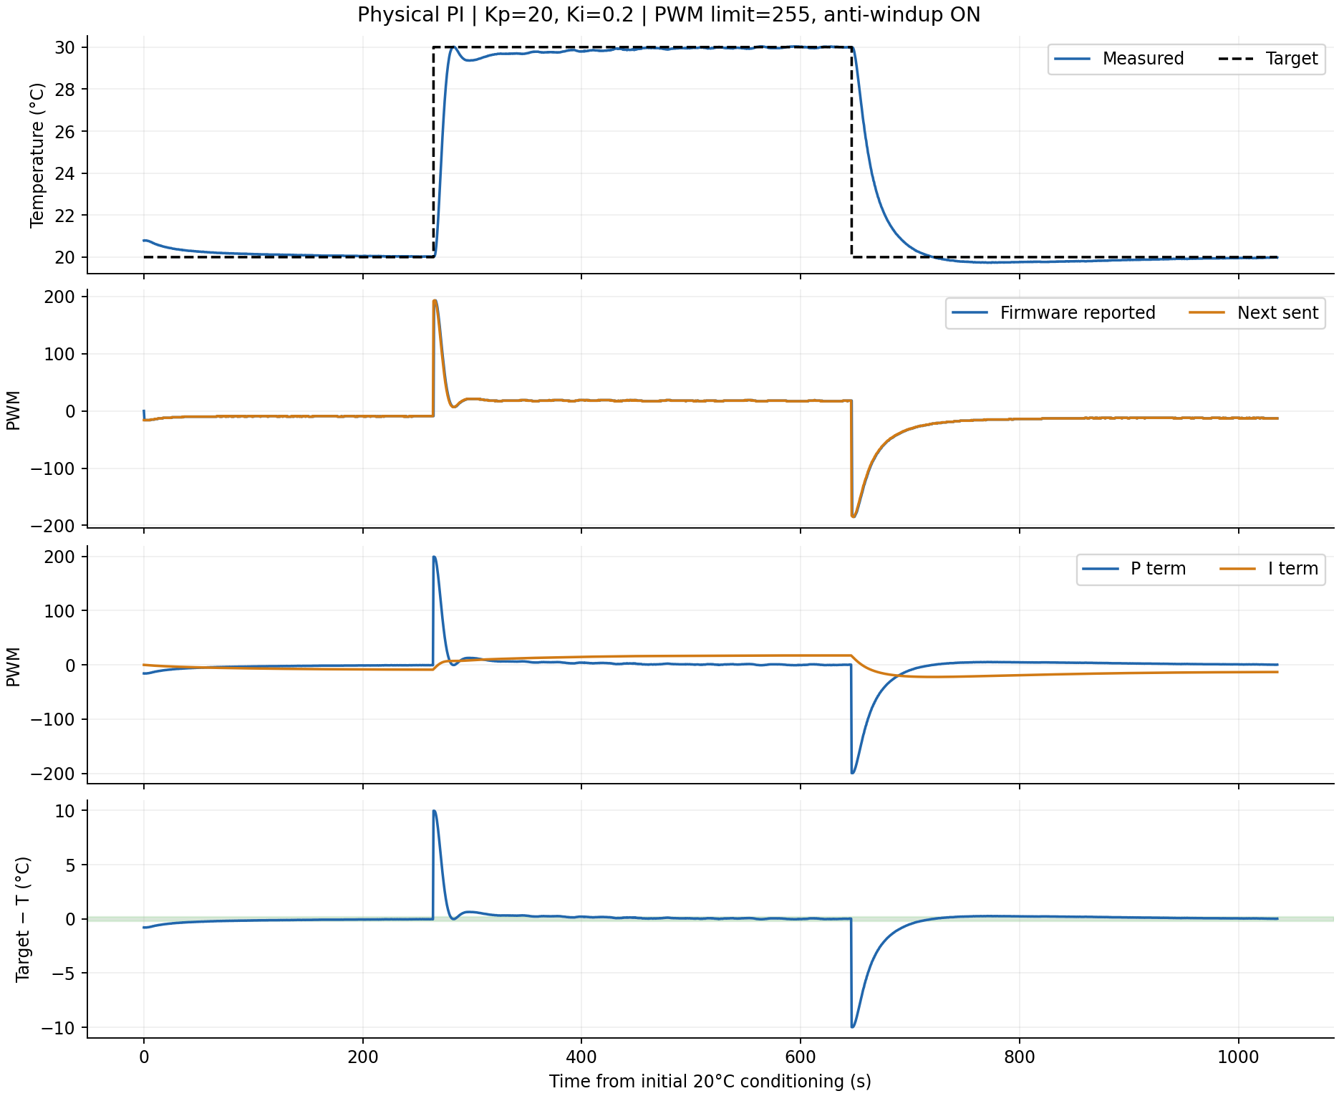
Module_6/figures/retained_analysis/PI_ki0p2.png
