zhuyanheng/Phys39-teamR-X/Module_7/figures/part_01_sensor_map.png

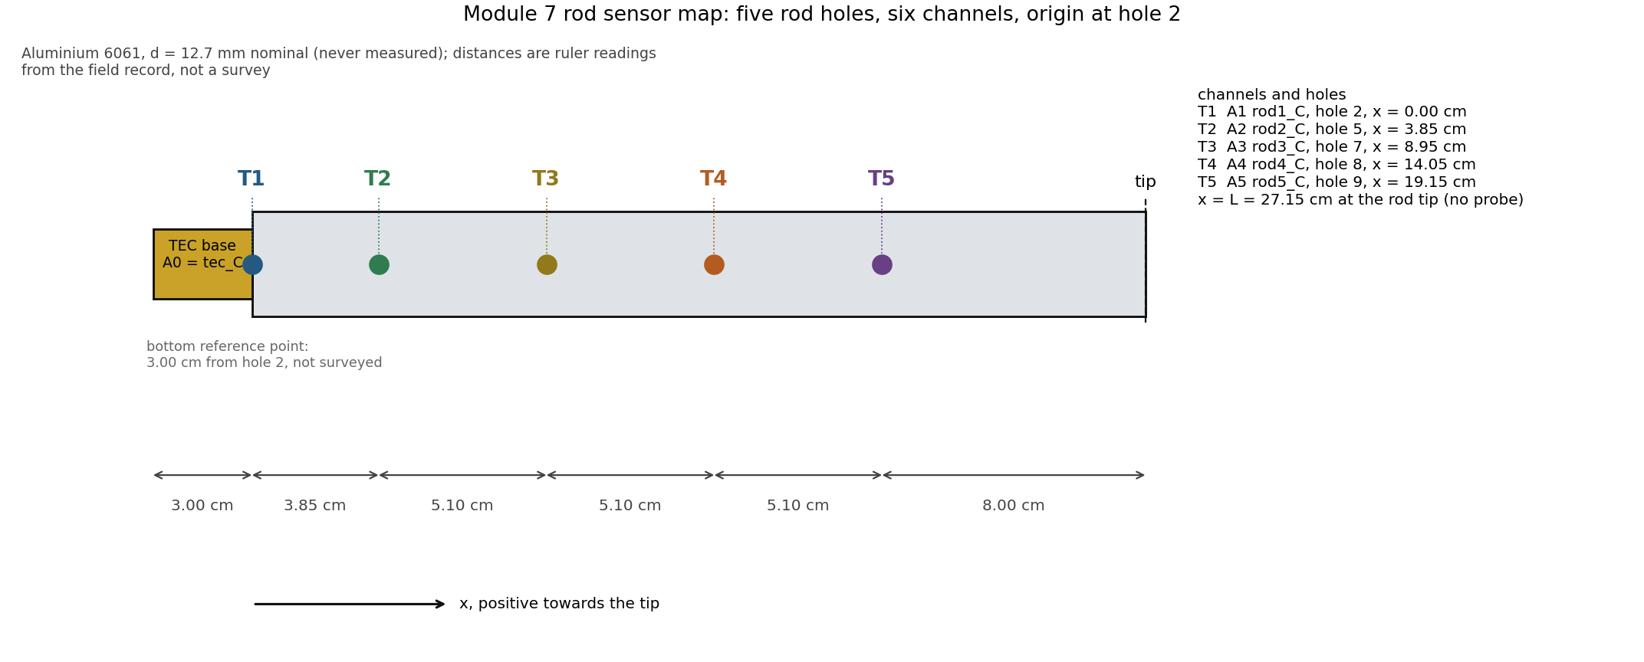
Module_7/figures/part_01_sensor_map.png
