zhuyanheng/Phys39-teamR-X/Module_7/figures/part_03_stationary_profile.png

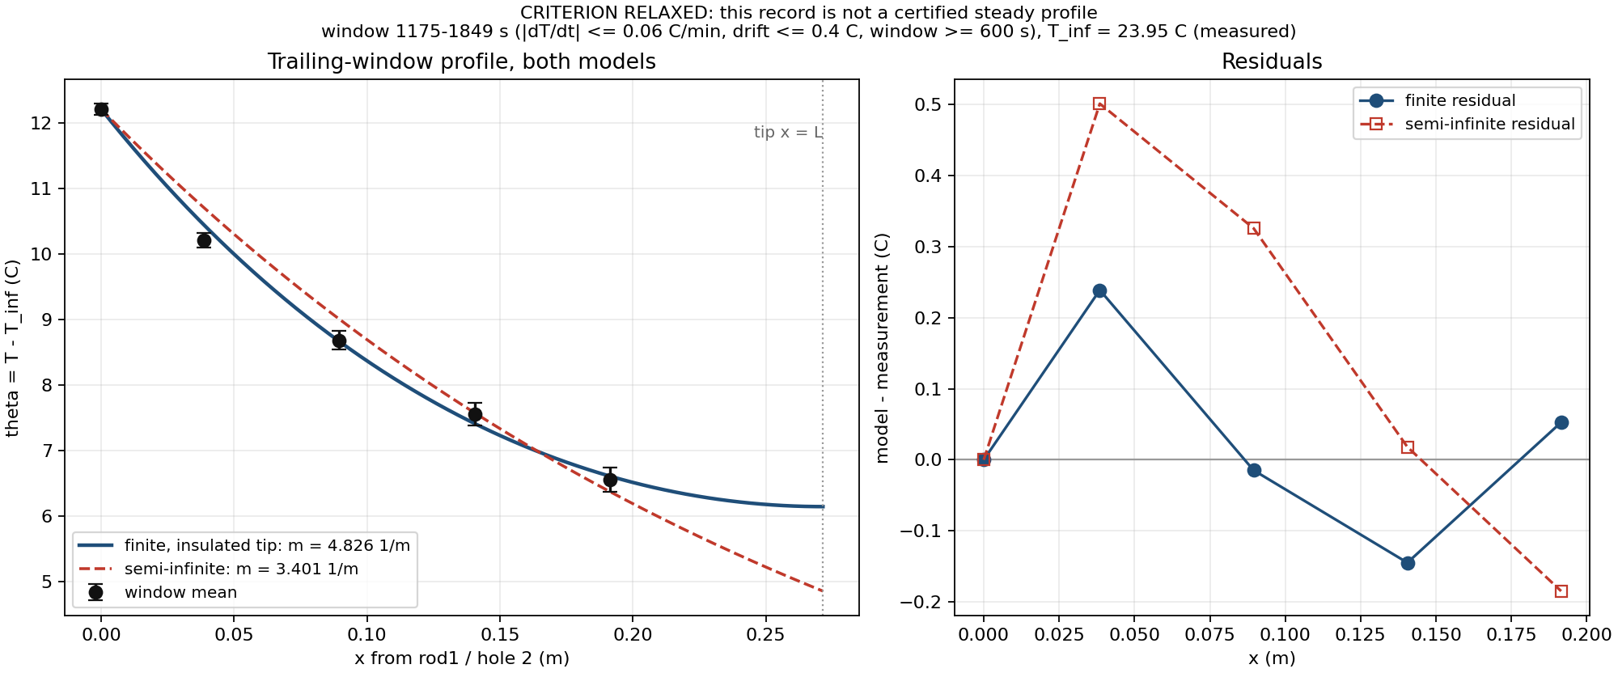
Module_7/figures/part_03_stationary_profile.png
