zhuyanheng/Phys39-teamR-X/Module_7/figures/pilot_checks/module_07_rod_20261030_152300_037075_T20C_T30C_T20C_temperatures.png

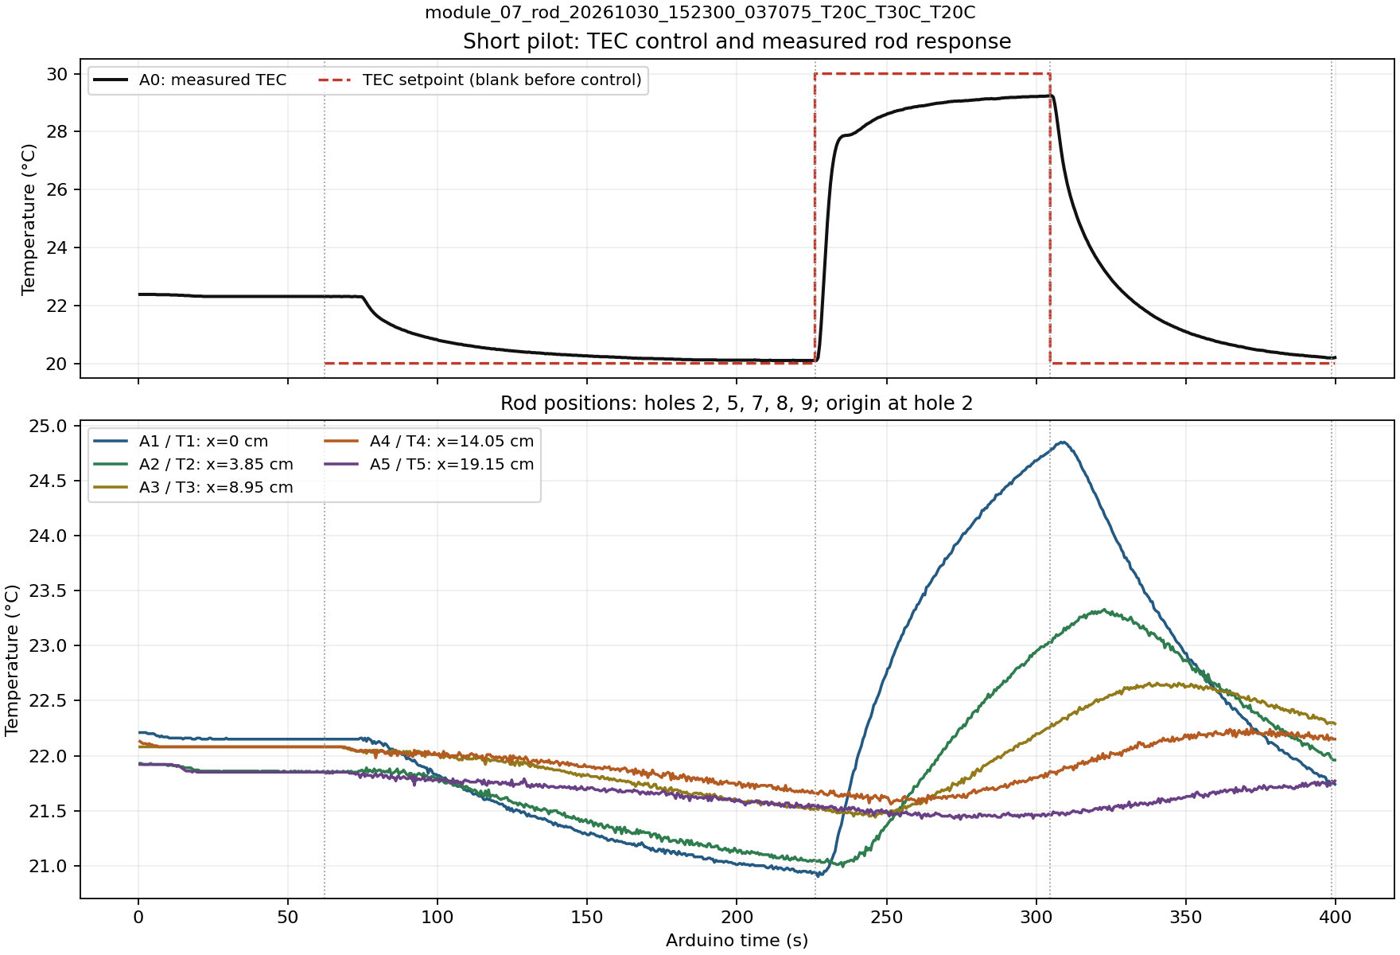
Module_7/figures/pilot_checks/module_07_rod_20261030_152300_037075_T20C_T30C_T20C_temperatures.png
