zhuyanheng/Phys39-teamR-X/Module_7/figures/pilot_checks/module_07_rod_20261102_100034_422916_T20C_temperatures.png

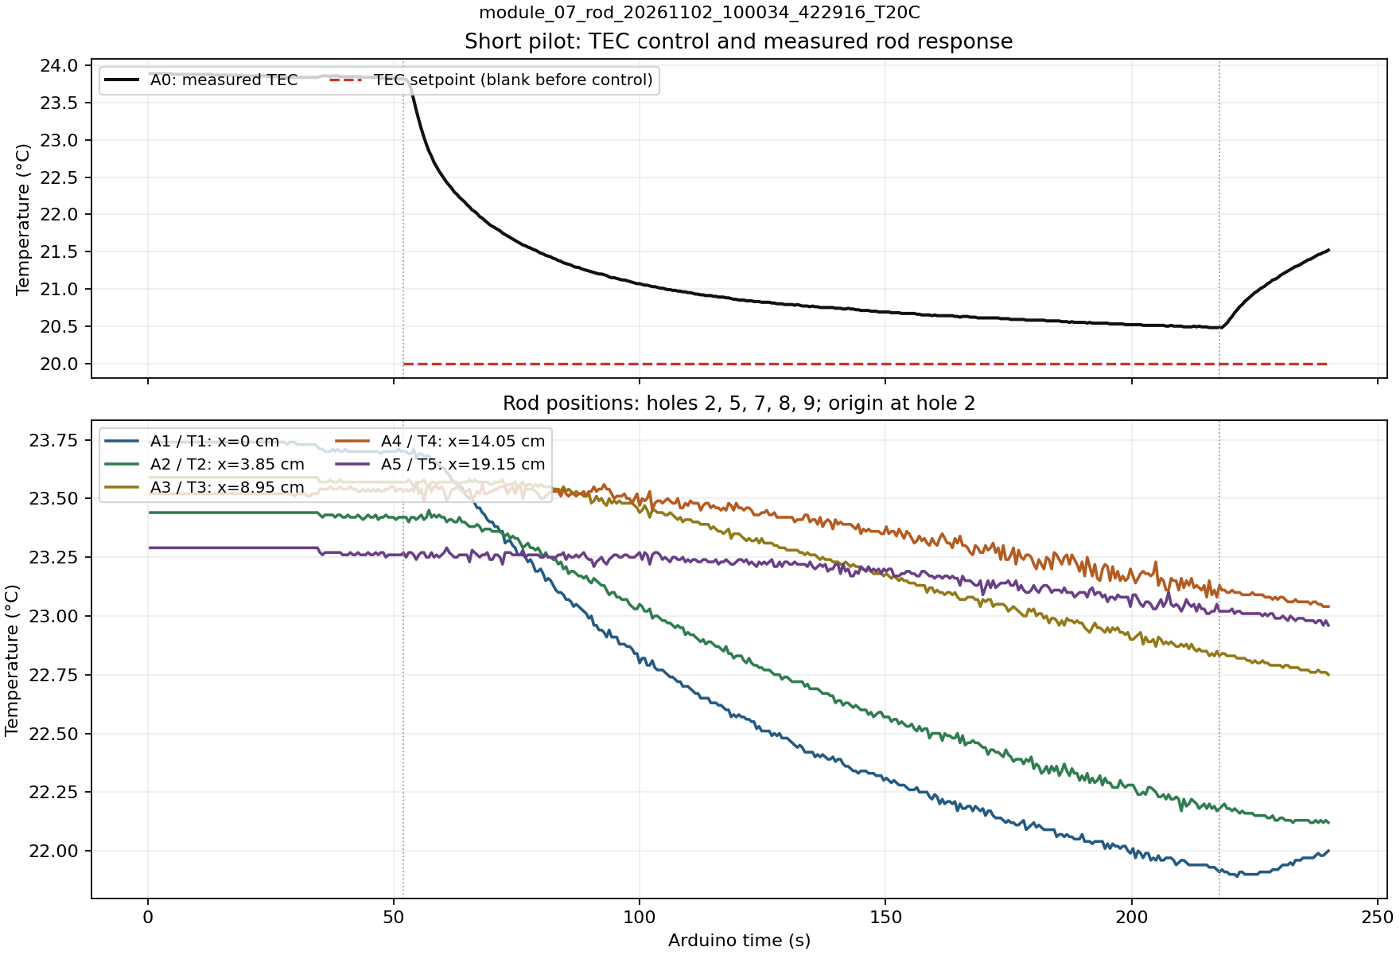
Module_7/figures/pilot_checks/module_07_rod_20261102_100034_422916_T20C_temperatures.png
