zhuyanheng/Phys39-teamR-X/Module_7/figures/pilot_checks/module_07_rod_20261102_100448_913799_T20C_trip45C_T40C_temperatures.png

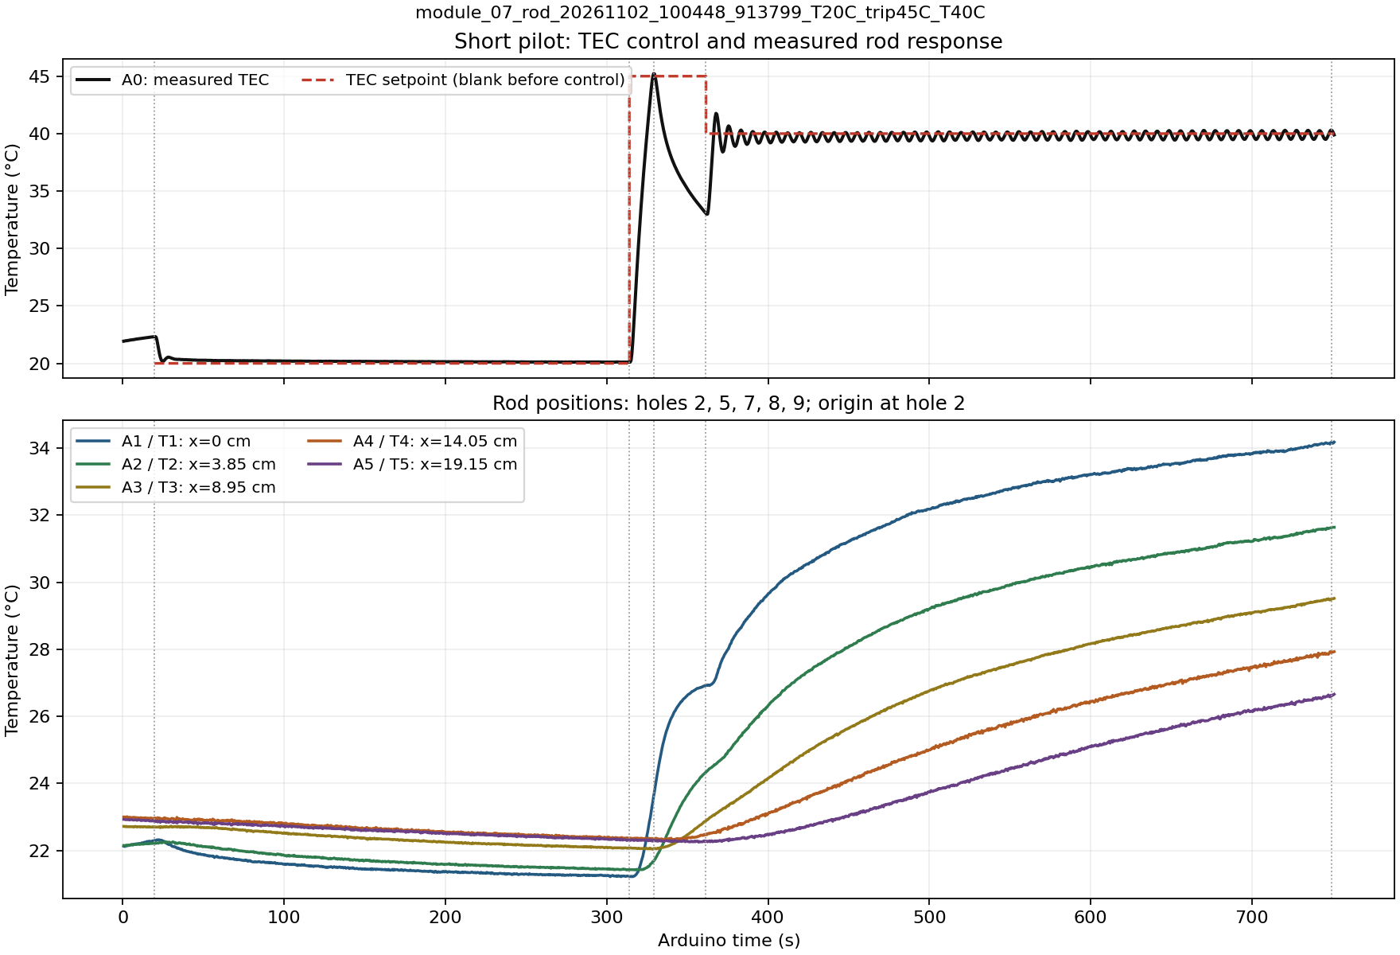
Module_7/figures/pilot_checks/module_07_rod_20261102_100448_913799_T20C_trip45C_T40C_temperatures.png
