zhuyanheng/Phys39-teamR-X/Module_8/figures/control_comparison/module_08_open_p_pi_comparison_200s.png

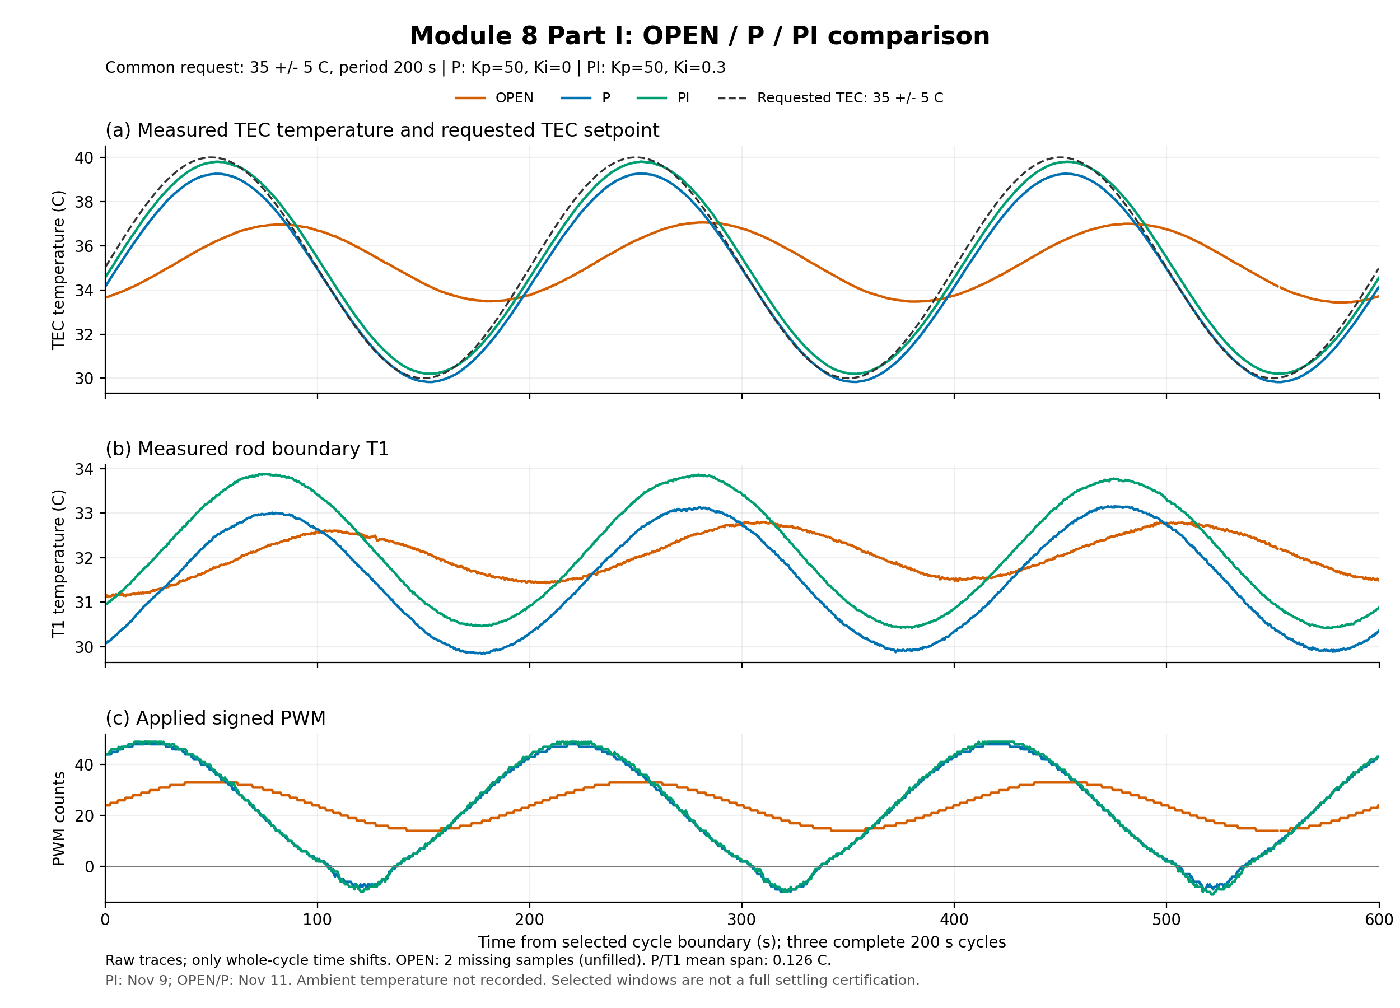
Module_8/figures/control_comparison/module_08_open_p_pi_comparison_200s.png
