zhuyanheng/Phys39-teamR-X/docs/module_notes/module_06_next_steps_zh.md

# Module 6：目前已经做完什么，接下来怎么做

## 已完成的数据分析

- 从 Module 4 五个加热点、五个制冷点重新拟合斜率：χh = 0.49545、χc = 0.14142 °C/PWM；比值约 3.50345。
- 从六条原始阶跃曲线估计时间常数，约 60.86–75.50 秒。H3 加热曲线作为主要例子，τ = 73.03 秒。
- 使用老师原版 v3 程序的计算核心，对照实测开环曲线和 Module 5 的 P 控制数据。
- 在 Kp=2 时，预测 droop 约 3.421 °C，实测约 3.231 °C。
- 完成 P、过阻尼 PI、欠阻尼 PI 的模拟，以及打开／关闭 anti-windup 的模拟比较。
- 写好可复算的 notebook、详细推导和 A3 草稿，并保存数值表格、参数和七组图。

重要限制：Module 4 部分稳态记录尚未满足老师更新后的观测要求，所以斜率仍是暂定值。时间常数的不同运行范围不是统计置信区间。模拟中的 H=1 是任意归一化，不能写成“实测散热系数”。现有 Arduino 源码使用 1000 次电压平均，但 CSV 没有记录当时上传的固件版本。

## 你现在可以先阅读什么

1. 打开 [P droop 图](../figures/module_06/04_p_droop.png)：看 Kp 越大，稳态误差越小。
2. 打开 [P／PI 模拟图](../figures/module_06/06_p_pi_simulation.png)：P 留有误差，PI 可以逐渐接近目标；Ki 增大时，这组模型响应更快但出现超调。
3. 阅读 [详细英文实验记录](module_06_p_pi_model.md)，尤其 Part 2 的三个解释题、Part 3 的 τ 估计和 Part 8 的 windup。
4. 打开 [A3 草稿](../assessments/a3_feedback_model.md)：已有数据和模拟结果已经填入，缺少的实物实验留有明确位置。

## 在课堂中操作 v3 模拟

从项目根目录运行：

```bash
.venv/bin/python python/Lab_6_7_modeling_tec_v3.py
```

选择 one-lump 和直接输入物理参数的模式。以下是同一组测量比值的一种等效参数化：

| 参数 | 值 | 意义 |
| --- | --- | --- |
| H | 1 W/°C | 任意归一化，未独立测量 |
| 总 C | 73.02743 J/°C | 设置 C/H = τ |
| 制冷 Pu,c | 0.14141667 W/PWM | 设置 Pu,c/H = χc |
| 加热／制冷比 r | 3.50345048 | χh/χc |
| 初始温度、环境温度 | 23.1885 °C | Module 5 比较的参考值 |
| 设定温度 | 30 °C | 与已有 P 数据一致 |
| Kp | 2 PWM/°C | 已有实测比较的例子 |
| Ki | 0、0.01、0.08 PWM/(°C·s) | 分别看 P、过阻尼 PI、欠阻尼 PI |
| 时间步长 | 0.1 s | 数值检查已与 0.05 s 比较 |
| PWM 上限 | 255 | 仅为本组模拟设置 |
| anti-windup | 开启 | 条件积分 |

每次比较前重置相同初始条件并清零积分。数值文件中的精确设置优先于本表的显示精度。上表 Ki 是模拟探索值，不是已经验证的实物增益。windup 演示中的 60 °C 仅为不可达目标的数学模拟，不能照搬到实物操作。

## 仍需补齐的实验

- 按已有 Module 4 审查记录，与老师确认哪些稳态点需延长或重测。
- 在已有 Module 5 控制器上准备 PI、积分清零和条件积分 anti-windup，并保留 Arduino 温度保护、PWM 限幅。
- 10 月 14 日通电前，向老师展示 e、q、P 项、I 项和实际限幅输出的计算代码。
- 先记录 Ki=0 的 P 基准，再记录初始条件相近的 PI。改变模式或清零积分前，先将 PWM 设为零。
- 保存实际采样间隔、设定值、初始温度、Kp、Ki、PWM 限制、anti-windup 状态和原始曲线。
- 10 月 19 日继续在老师监督下调参，量化上升时间、超调、稳定时间、稳态误差和饱和。
- 已有记录只说明到 Kp=4 未观察到振荡，不能据此填写“振荡起始增益”。需要老师允许范围内的起始／振荡证据，或明确获得对这一限制的认可。

## 最后提交

A3 目前是**不完整草稿**，还不能直接提交。补齐实物结果后，检查图、数据链接和解释，commit、push，并填写可验证的 GitHub checkpoint 链接。生成 `A3_Huang_Zhu.pdf`，每位组员分别上传相同团队 PDF 至 Moodle；截止 2026 年 10 月 21 日（周三）下午 6 点。

本次分析保留了原始数据及 Module 5 控制程序。新分析文件和文稿目前只在本地，尚未 commit／push。
