zhuyanheng/Phys39-teamR-X/Module_7/figures/part_02_step_response.png

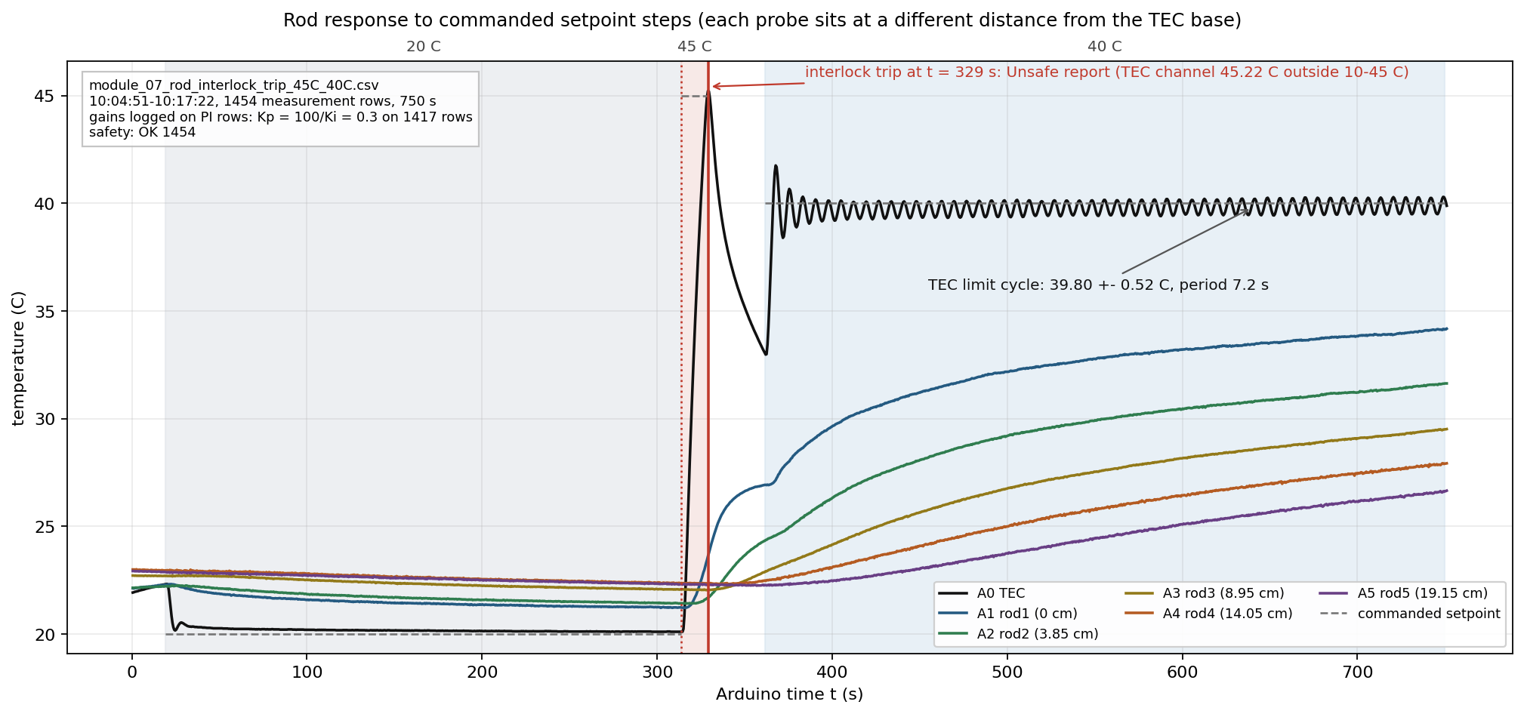
Module_7/figures/part_02_step_response.png
