zhuyanheng/Phys39-teamR-X/Module_6/docs/experiment_analysis_2026-10-19.md

# P / PI 实验分析（2026-10-19）

> 已被 [10月21日新P分析](experiment_analysis_2026-10-21.md) 替代。以下旧Module 5 P结果只保留作历史记录，不参与当前A3。
按用户决定，使用 Module 5 的历史 P 数据和 10月19日三组 PI 数据。旧 P 数据明确保留；此前作废的 Module 6 记录不参与。原始 CSV 未修改。

## 结论

- P 增益从0.25提高至4时，30°C目标下末段误差明显缩小，但仍有 droop；Kp=250 的记录出现超调和持续振荡。
- PI 三组均完成20→30→20°C，固定 Kp=20，Ki=0.1、0.2、0.5；PWM上限255，anti-windup开启。
- Ki增加使升温最终修正更快，同时增大超调。降温稳定时间不是单调变化，不能声称所有方向均更快。
- 本组 Ki=0.2 可作为低超调与速度间的折中；Ki=0.5 升温最快，但约有0.82°C升温超调和1.08°C降温过冲。这不是全局最优参数的证明。

## PI 定量结果

| Ki | 方向 | 10–90%响应时间/s | 超调/°C | 超调/% | 稳定时间/s | 最后60秒误差/°C |
|---:|---|---:|---:|---:|---:|---:|
| 0.1 | 升温 | 10.46 | 0.01 | 0.10 | 401.35 | 0.0694 |
| 0.1 | 降温 | 50.51 | 0.00 | 0.00 | 127.43 | -0.0275 |
| 0.2 | 升温 | 9.62 | 0.03 | 0.30 | 138.04 | 0.0020 |
| 0.2 | 降温 | 37.78 | 0.27 | 2.71 | 199.19 | 0.0420 |
| 0.5 | 升温 | 8.80 | 0.82 | 8.19 | 27.51 | -0.0382 |
| 0.5 | 降温 | 25.42 | 1.08 | 10.78 | 168.67 | 0.0328 |

## 历史 P 结果

| Kp | 最后20秒平均温度/°C | 最后20秒误差/°C | 超调/°C | 目标±0.2°C稳定时间/s |
|---:|---:|---:|---:|---:|
| 0.25 | 24.00 | 6.00 | 0.00 | 未达到/未确认 |
| 0.5 | 24.77 | 5.23 | 0.00 | 未达到/未确认 |
| 1 | 25.50 | 4.50 | 0.00 | 未达到/未确认 |
| 2 | 26.77 | 3.23 | 0.00 | 未达到/未确认 |
| 4 | 27.74 | 2.26 | 0.00 | 未达到/未确认 |
| 250 | 30.40 | -0.40 | 2.46 | 未达到/未确认 |

Kp=250 后期振荡周期约 6.89 秒。全幅输出样本数为 64/157；振荡曲线末段平均值不是稳定平衡温度。

## 机制与证据边界

误差 e=Tset−T，积分 q=∫e dt，控制输出 u=Kp e+Ki q。达到目标时 P项可接近零，但I项仍保留先前误差的记忆；继续输出与热惯性共同造成越过目标后回归。Ki=0.5降温首次经过20°C附近时，19.97°C样本的P项为+0.60而I项约−62.78 PWM，仍有显著制冷请求。
三组 PI 保留段 computed_saturated 均为0，因此没有证据把本次超调归因于饱和造成的积分windup。步幅均约10°C，不能据此单独验证“步幅越大超调越大”；该点保留为现场观察及待验证假设。未对PI报告单一振荡周期：过冲回归不等于存在足够多稳定周期。

## 方法与限制

- 时间从各阶跃后第一个有效测量点起算，约有一个采样间隔的不确定性；指标描述这次记录，不提供重复实验置信区间。
- 10–90%按实际初始温度到目标温度的步幅定义，线性插值首次交叉。P低增益若到不了90%目标步幅，结果为缺失，不替换成相对最终温度的响应时间。
- 稳定判据：误差始终在±0.2°C内直到该段结束，且有至少60秒后续观察；不是无限时间稳定性证明。最后60秒误差不是严格无限时间稳态误差。
- P droop表用最后20秒，以衔接Module 5既有表；机器可读指标另含最后60秒。接近0.01°C量级的峰值不应解释为显著超调。
- 历史P记录不是三组完整的20↔30°C双向配对：低增益记录缺少降温，高增益记录从约20.95°C开始升温。不能补造缺失方向的指标，也不能宣称满足课程六组完全匹配的实验协议。
- 历史P程序输出钳位为255，但旧CSV没有独立pwm_limit字段；60°C的limit_C是温度保护阈值，不是PWM上限。不同日期的环境温度、初始条件和硬件状态可能不同。
- 为图示选择P Kp=0.25、4、250作为低、稳定示例、高增益；Kp=4不是已验证的最佳中增益，PI Kp=20也不满足“略低于4”的匹配关系。按用户决定复用数据，但这一课程协议差异必须保留。
- P与PI的Kp不同，不能把跨组的全部速度差异单独归因于积分项。三组PI内部只改变Ki，比较依据更充分。

## 产物与下一步

- data/experiment_analysis/step_metrics.csv：12段记录的指标；analysis_results.json：定义、来源SHA256和计算结果。
- figures/experiment_analysis/：三张历史P、三张PI完整轨迹，以及一张PI对齐比较图；均有PNG与SVG。
- 下一步是六组对应的two-lump模拟与实验比较，再将理论、图表、参数选择和协议限制整理进A3。本脚本没有运行新的模拟。
