zhuyanheng/Phys39-teamR-X/Module_6/docs/experiment_analysis_2026-10-21.md

# 当前 P / PI 实验分析（2026-10-21）

使用10月21日新P（Kp=0.25、4、100）与10月19日PI（Kp=20，Ki=0.1、0.2、0.5）。Module 5 P数据不再参与A3。三组新P原始内容不变，保留连接时间戳，文件名按实际模式和增益归档。

| 模式 | Kp | Ki | 方向 | 记录时长/s | 10–90%/s | 超调/°C | 稳定时间/s | 最后60秒误差/°C | 最后20秒误差/°C |
|---|---:|---:|---|---:|---:|---:|---:|---:|---:|
| P | 0.25 | 0 | up | 257.51 | 未达到/未确认 | 0.00 | 未达到/未确认 | 7.8491 | 7.8188 |
| P | 0.25 | 0 | down | 74.55 | 未达到/未确认 | 0.00 | 未达到/未确认 | -1.8493 | -1.7393 |
| P | 4 | 0 | up | 220.54 | 未达到/未确认 | 0.00 | 未达到/未确认 | 2.8659 | 2.8642 |
| P | 4 | 0 | down | 296.54 | 未达到/未确认 | 0.00 | 未达到/未确认 | -1.2333 | -1.2203 |
| P | 100 | 0 | up | 44.79 | 5.89 | 3.21 | 未达到/未确认 | 未达到/未确认 | 0.0608 |
| P | 100 | 0 | down | 56.07 | 13.49 | 0.23 | 未达到/未确认 | 未达到/未确认 | -0.2273 |
| PI | 20 | 0.1 | up | 650.92 | 10.46 | 0.01 | 401.35 | 0.0694 | 0.0552 |
| PI | 20 | 0.1 | down | 332.86 | 50.51 | 0.00 | 127.43 | -0.0275 | -0.0217 |
| PI | 20 | 0.2 | up | 381.49 | 9.62 | 0.03 | 138.04 | 0.0020 | 0.0008 |
| PI | 20 | 0.2 | down | 388.77 | 37.78 | 0.27 | 199.19 | 0.0420 | 0.0285 |
| PI | 20 | 0.5 | up | 137.53 | 8.80 | 0.82 | 27.51 | -0.0382 | -0.0317 |
| PI | 20 | 0.5 | down | 263.39 | 25.42 | 1.08 | 168.67 | 0.0328 | 0.0170 |

## 结论与限制

- 新P与模拟使用相同增益0.25、4、100，均有目标20→30→20°C，修复了旧P缺少降温及250/100不匹配的问题。
- Kp=100升温最高33.21°C，降温最低19.77°C；两段分别约45与56秒，无法确认持续60秒稳定，最后60秒均值留空而不是用整段均值冒充稳态。
- 高P升温两个明显峰值（33.21、30.58°C）相隔约17.81秒，振荡幅度下降；仅一个峰间间隔，不能当作精确持续振荡周期。降温缺少足够周期，周期留空。
- Kp=0.25初始段约26秒，降温段约75秒且仍漂移，不能声称充分预稳态；所有初始温度和观测时长都明确记录。
- 三组P/PI共同目标和限幅一致，但分两天测量，室温没有独立逐次记录；原模型23.19°C是名义参考，不能声称等于新实验实测室温。
- 新P中增益仍为4，而PI使用20，不满足PI略低于中增益P的严格配对。不能把跨模式速度差异完全归因于积分。
- 当前PI三组结论不变：Ki增大加快最终升温修正并增大超调，降温稳定时间不单调。
- 旧Module 5记录保留；旧报告和退役Kp250图在 archive/2026-10-21_pre_new_p/，不再作为当前证据。

## 当前来源

- P Kp=0.25, Ki=0, run_id=1: `Module_6/data/physical/p_kp_0p25_20261021_103204_751306.csv`
- P Kp=4, Ki=0, run_id=1: `Module_6/data/physical/p_kp_4_20261021_103836_296838.csv`
- P Kp=100, Ki=0, run_id=1: `Module_6/data/physical/p_kp_100_20261021_105056_326633.csv`
- PI Kp=20, Ki=0.1, run_id=3: `Module_6/data/physical/pi_kp_20_ki_0p1_20261019_093424_268559.csv`
- PI Kp=20, Ki=0.2, run_id=2: `Module_6/data/physical/pi_kp_20_ki_0p2_20261019_095648_364327.csv`
- PI Kp=20, Ki=0.5, run_id=3: `Module_6/data/physical/pi_kp_20_ki_0p5_20261019_101544_769937.csv`
