zhuyanheng/Phys39-teamR-X/Module_5/data/20260930_104014_sign_test_preliminary.csv

time_s | temperature_C | pwm | heat_cool | safety | heat_pwm_firmware | cool_pwm_firmware | limit_C | p_active | setpoint_C | Kp_pwm_per_C | error_C | signed_pwm
0.56 | 22.83 | 0 | 0 | OK | 0 | 0 | 60.00 | 0
1.07 | 22.83 | 0 | 0 | OK | 0 | 0 | 60.00 | 0
1.57 | 22.83 | 0 | 0 | OK | 0 | 0 | 60.00 | 0
2.08 | 22.84 | 0 | 0 | OK | 0 | 0 | 60.00 | 0
2.58 | 22.84 | 0 | 0 | OK | 0 | 0 | 60.00 | 0
3.09 | 22.84 | 0 | 0 | OK | 0 | 0 | 60.00 | 0
3.59 | 22.84 | 0 | 0 | OK | 0 | 0 | 60.00 | 0
4.09 | 22.84 | 0 | 0 | OK | 0 | 0 | 60.00 | 0
4.60 | 22.84 | 0 | 0 | OK | 0 | 0 | 60.00 | 0
5.10 | 22.85 | 0 | 1 | OK | 0 | 0 | 60.00 | 0
5.61 | 22.85 | 0 | 1 | OK | 0 | 0 | 60.00 | 0
6.11 | 22.85 | 0 | 1 | OK | 0 | 0 | 60.00 | 0
6.62 | 22.85 | 0 | 1 | OK | 0 | 0 | 60.00 | 0
7.12 | 22.85 | 0 | 1 | OK | 0 | 0 | 60.00 | 0
7.63 | 22.85 | 0 | 1 | OK | 0 | 0 | 60.00 | 0
8.13 | 22.85 | 0 | 1 | OK | 0 | 0 | 60.00 | 0
8.64 | 22.85 | 0 | 1 | OK | 0 | 0 | 60.00 | 0
9.14 | 22.86 | 0 | 1 | OK | 0 | 0 | 60.00 | 0
9.65 | 22.86 | 0 | 1 | OK | 0 | 0 | 60.00 | 0
10.15 | 22.86 | 0 | 1 | OK | 0 | 0 | 60.00 | 0
10.66 | 22.86 | 0 | 1 | OK | 0 | 0 | 60.00 | 0
11.16 | 22.86 | 0 | 1 | OK | 0 | 0 | 60.00 | 0
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
