zhuyanheng/Phys39-teamR-X/Module_5/data/20260930_105823_sign_test_heat_cool_confirmed.csv

time_s | temperature_C | pwm | heat_cool | safety | heat_pwm_firmware | cool_pwm_firmware | limit_C | p_active | setpoint_C | Kp_pwm_per_C | error_C | signed_pwm
0.56 | 23.26 | 0 | 0 | OK | 0 | 0 | 60.00 | 0
1.07 | 23.26 | 0 | 0 | OK | 0 | 0 | 60.00 | 0
1.57 | 23.26 | 0 | 0 | OK | 0 | 0 | 60.00 | 0
2.08 | 23.26 | 0 | 0 | OK | 0 | 0 | 60.00 | 0
2.58 | 23.27 | 0 | 0 | OK | 0 | 0 | 60.00 | 0
3.09 | 23.27 | 0 | 0 | OK | 0 | 0 | 60.00 | 0
3.59 | 23.27 | 0 | 0 | OK | 0 | 0 | 60.00 | 0
4.09 | 23.28 | 0 | 0 | OK | 0 | 0 | 60.00 | 0
4.60 | 23.28 | 0 | 0 | OK | 0 | 0 | 60.00 | 0
5.10 | 23.28 | 0 | 0 | OK | 0 | 0 | 60.00 | 0
5.61 | 23.29 | 0 | 0 | OK | 0 | 0 | 60.00 | 0
6.11 | 23.29 | 0 | 0 | OK | 0 | 0 | 60.00 | 0
6.62 | 23.29 | 0 | 0 | OK | 0 | 0 | 60.00 | 0
7.12 | 23.29 | 0 | 0 | OK | 0 | 0 | 60.00 | 0
7.63 | 23.29 | 0 | 0 | OK | 0 | 0 | 60.00 | 0
8.13 | 23.29 | 0 | 0 | OK | 0 | 0 | 60.00 | 0
8.64 | 23.30 | 0 | 0 | OK | 0 | 0 | 60.00 | 0
9.14 | 23.29 | 0 | 0 | OK | 0 | 0 | 60.00 | 0
9.65 | 23.30 | 0 | 0 | OK | 0 | 0 | 60.00 | 0
10.15 | 23.30 | 0 | 0 | OK | 0 | 0 | 60.00 | 0
10.66 | 23.30 | 0 | 0 | OK | 0 | 0 | 60.00 | 0
11.16 | 23.30 | 0 | 0 | OK | 0 | 0 | 60.00 | 0
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
