zhuyanheng/Phys39-teamR-X/docs/figures/module_05/part_04_measured_vs_predicted_droop.png

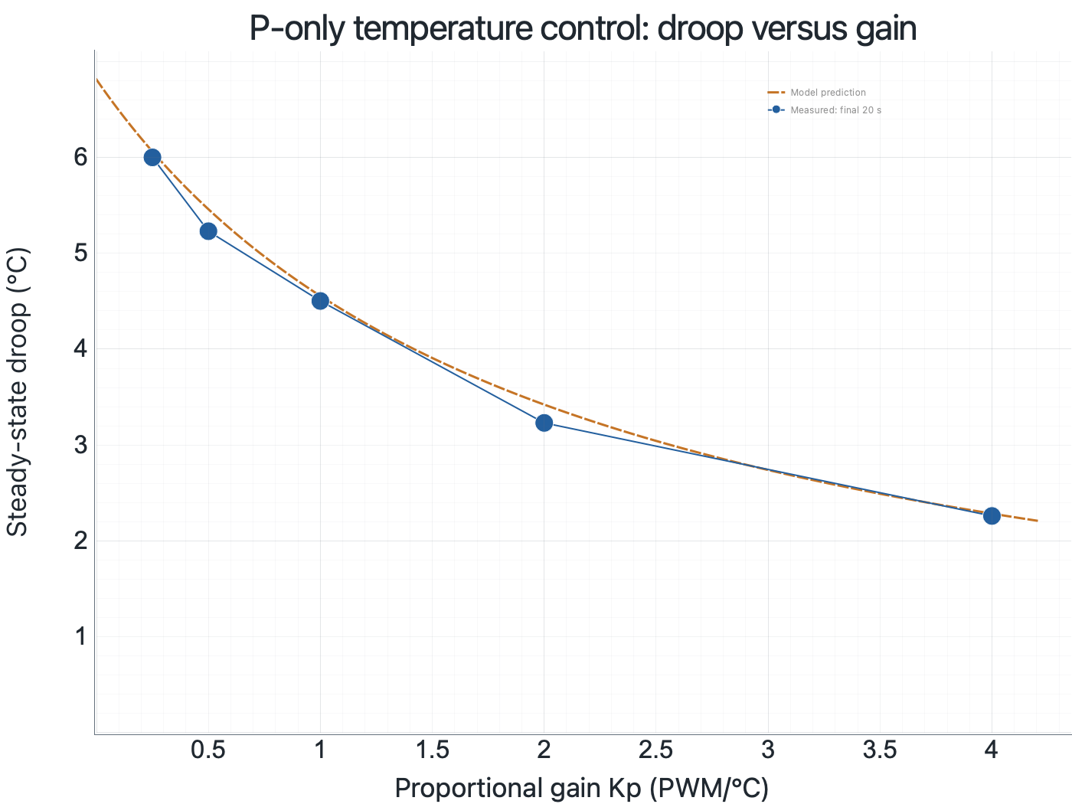
docs/figures/module_05/part_04_measured_vs_predicted_droop.png
