zhuyanheng/Phys39-teamR-X/Module_4/figures/part_1_gui_after_30c_limit_test.png

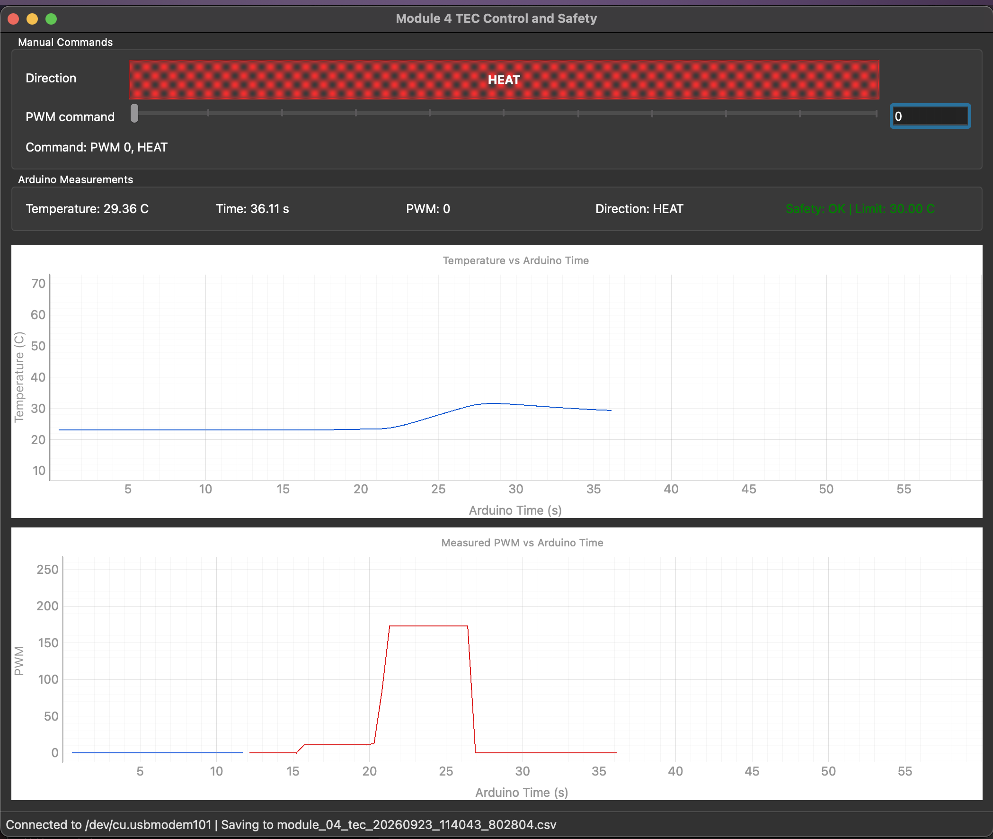
Module_4/figures/part_1_gui_after_30c_limit_test.png
