zhuyanheng/Phys39-teamR-X/Module_6/figures/experiment_analysis/exp_p_kp_100.png

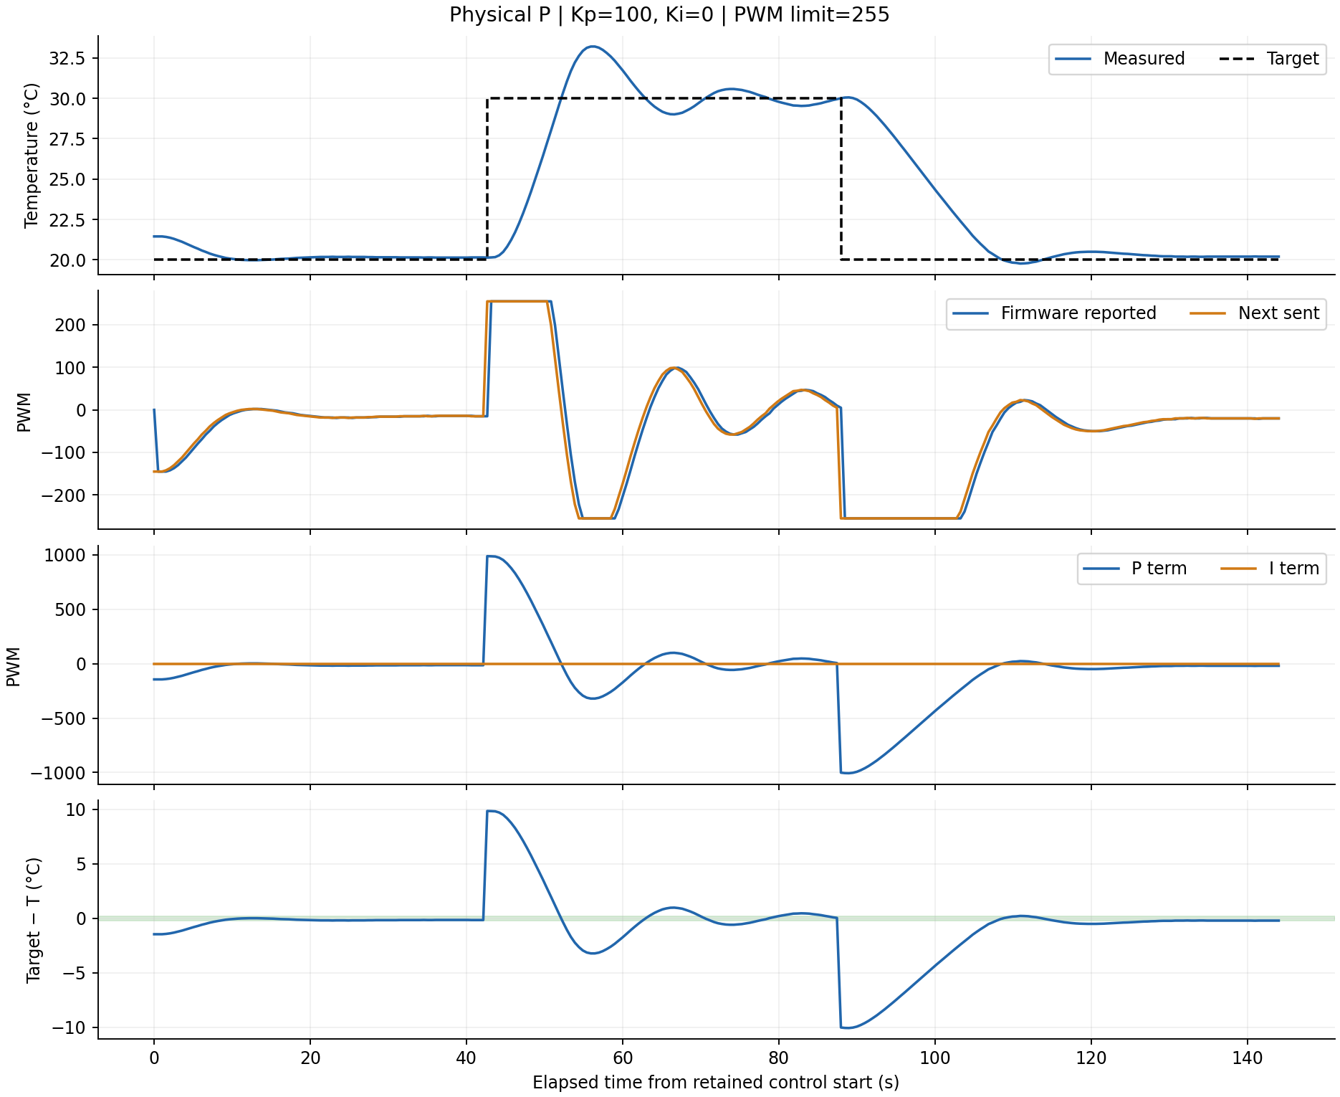
Module_6/figures/experiment_analysis/exp_p_kp_100.png
