zhuyanheng/Phys39-teamR-X/Module_6/figures/experiment_analysis/exp_pi_kp_20_ki_0p5.png

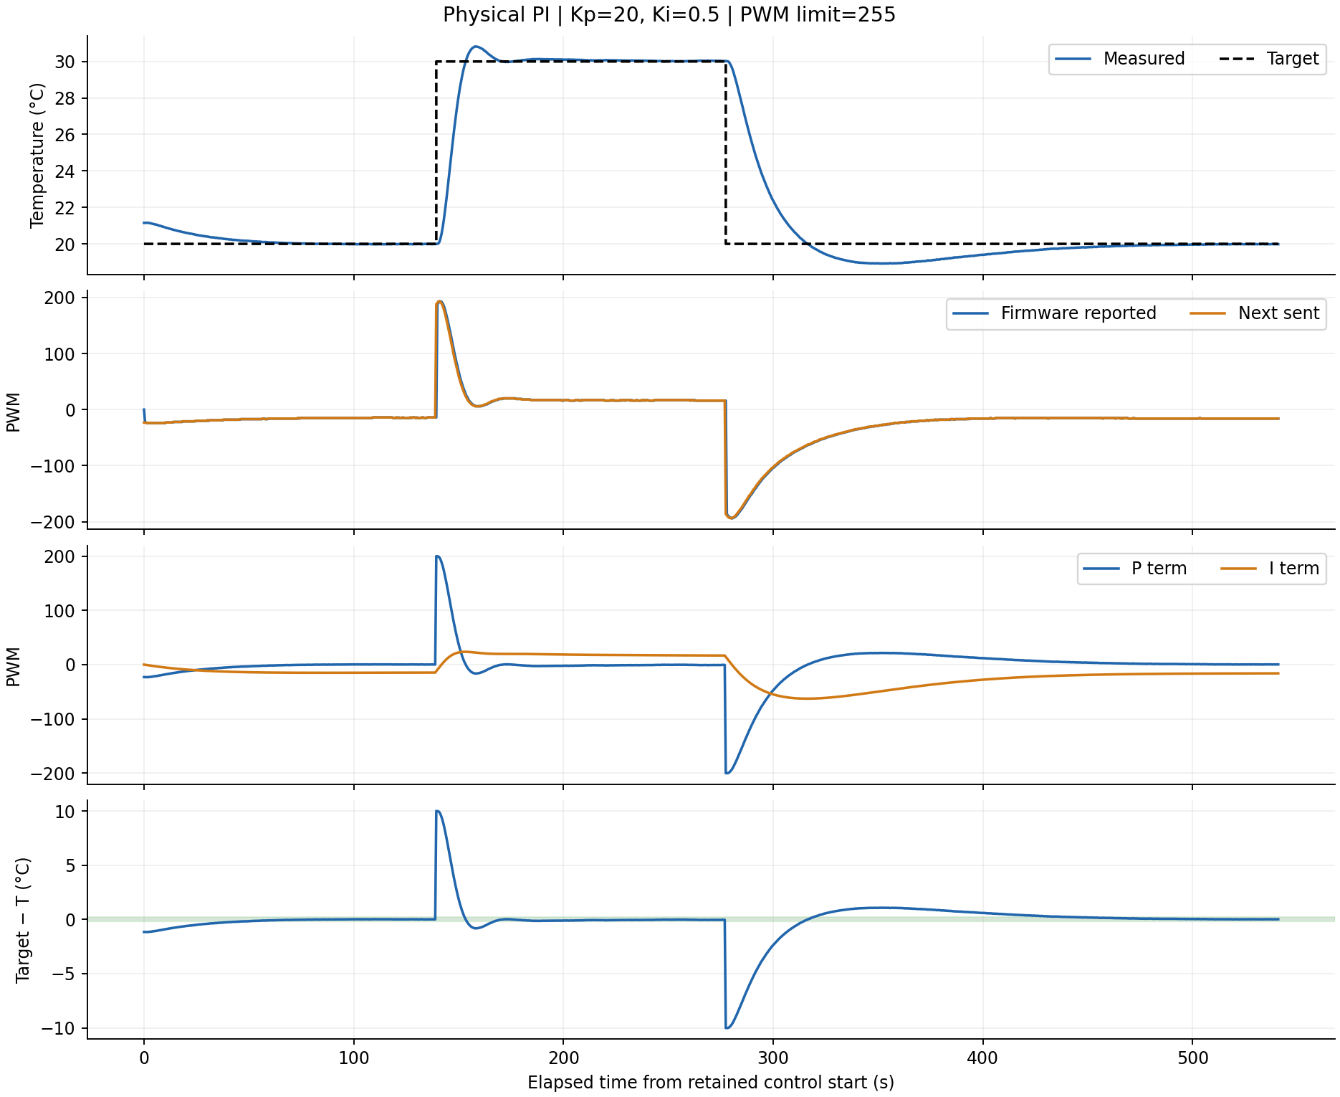
Module_6/figures/experiment_analysis/exp_pi_kp_20_ki_0p5.png
