zhuyanheng/Phys39-teamR-X/Module_6/figures/experiment_analysis/p_aligned_comparison.png

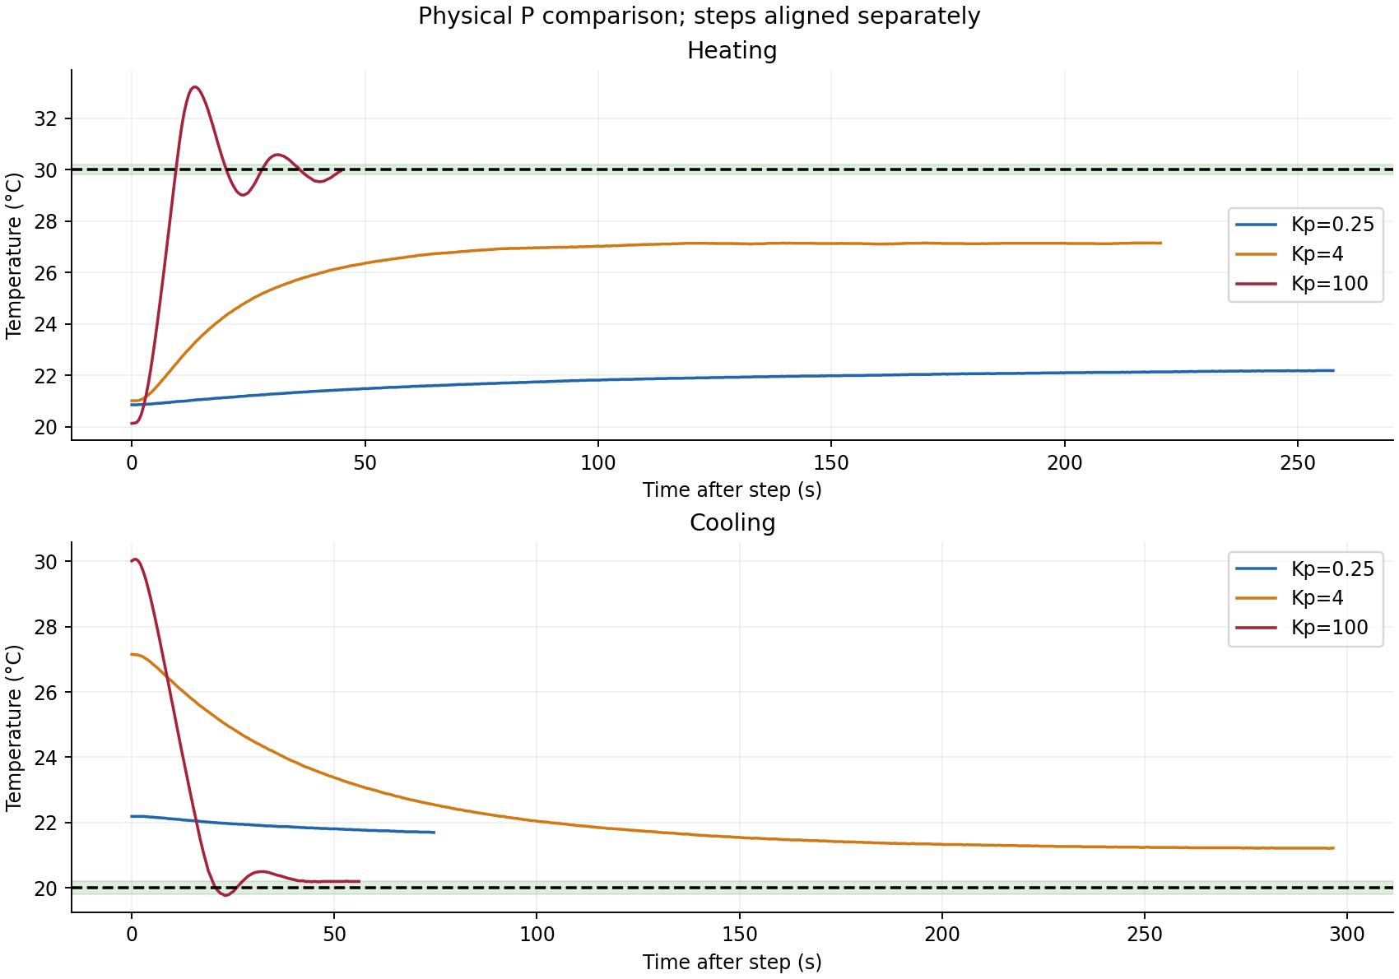
Module_6/figures/experiment_analysis/p_aligned_comparison.png
