zhuyanheng/Phys39-teamR-X/Module_6/figures/experiment_analysis/pi_aligned_comparison.png

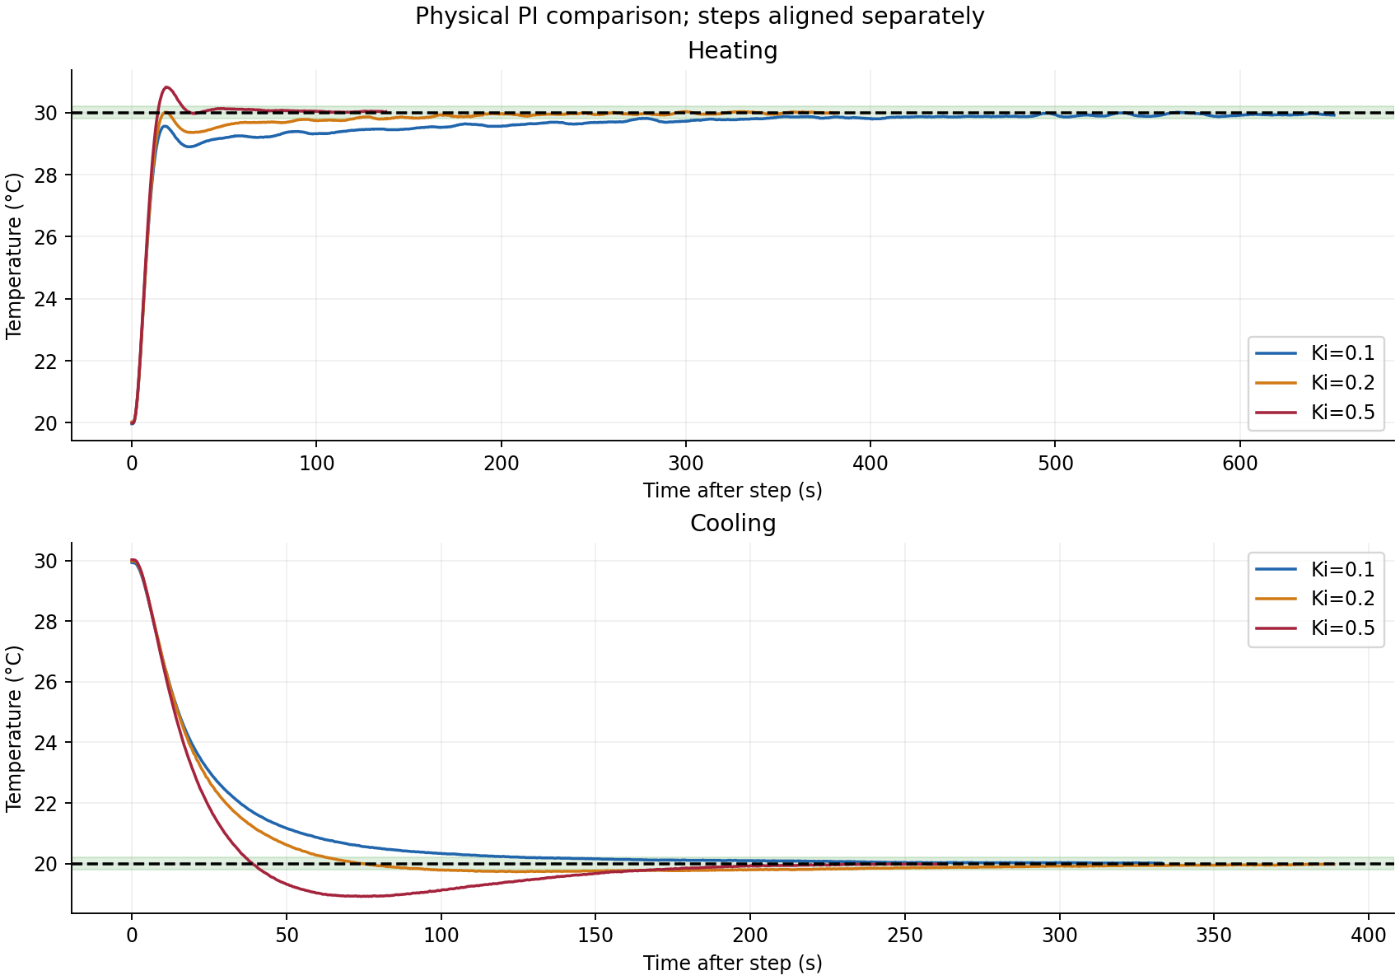
Module_6/figures/experiment_analysis/pi_aligned_comparison.png
