zhuyanheng/Phys39-teamR-X/Module_7/figures/final_selected/module_07_rod_20261104_095908_593628_selected_stationary_history.png

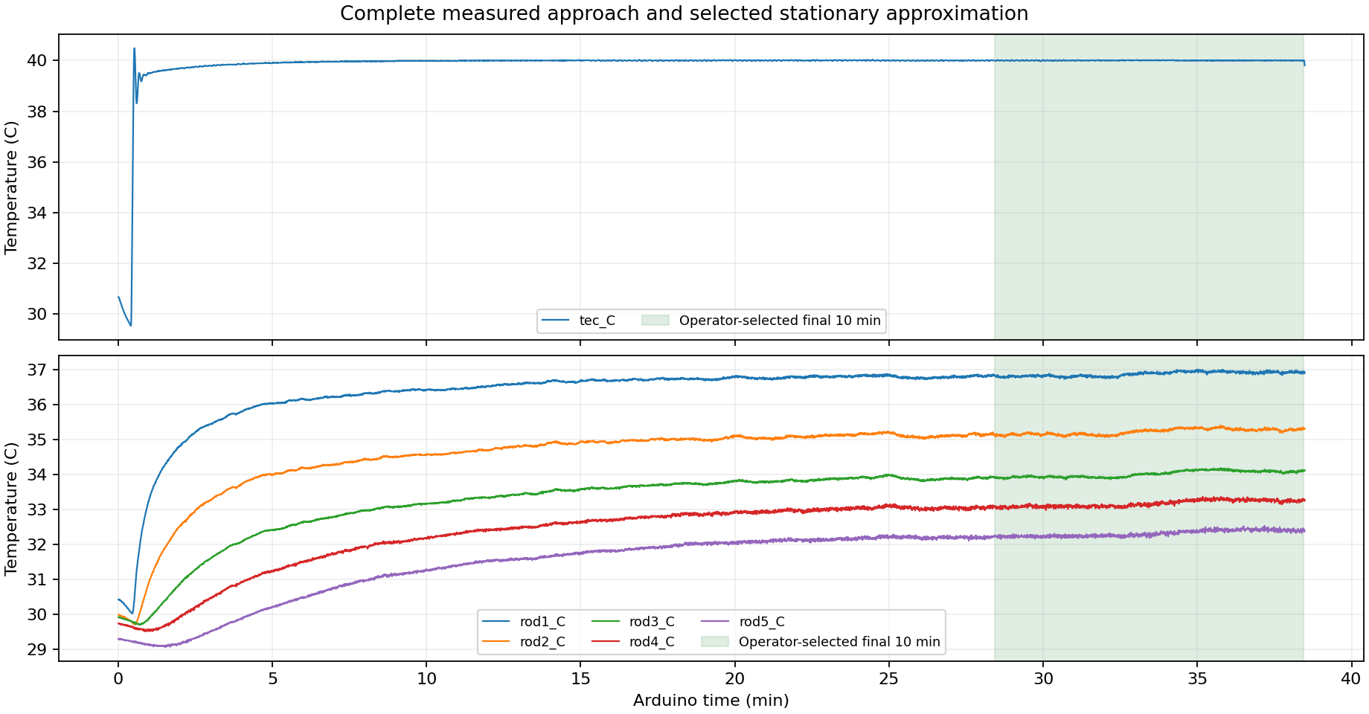
Module_7/figures/final_selected/module_07_rod_20261104_095908_593628_selected_stationary_history.png
