zhuyanheng/Phys39-teamR-X/Module_8/figures/control_comparison/module_08_open_p_pi_comparison_200s.pdf

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

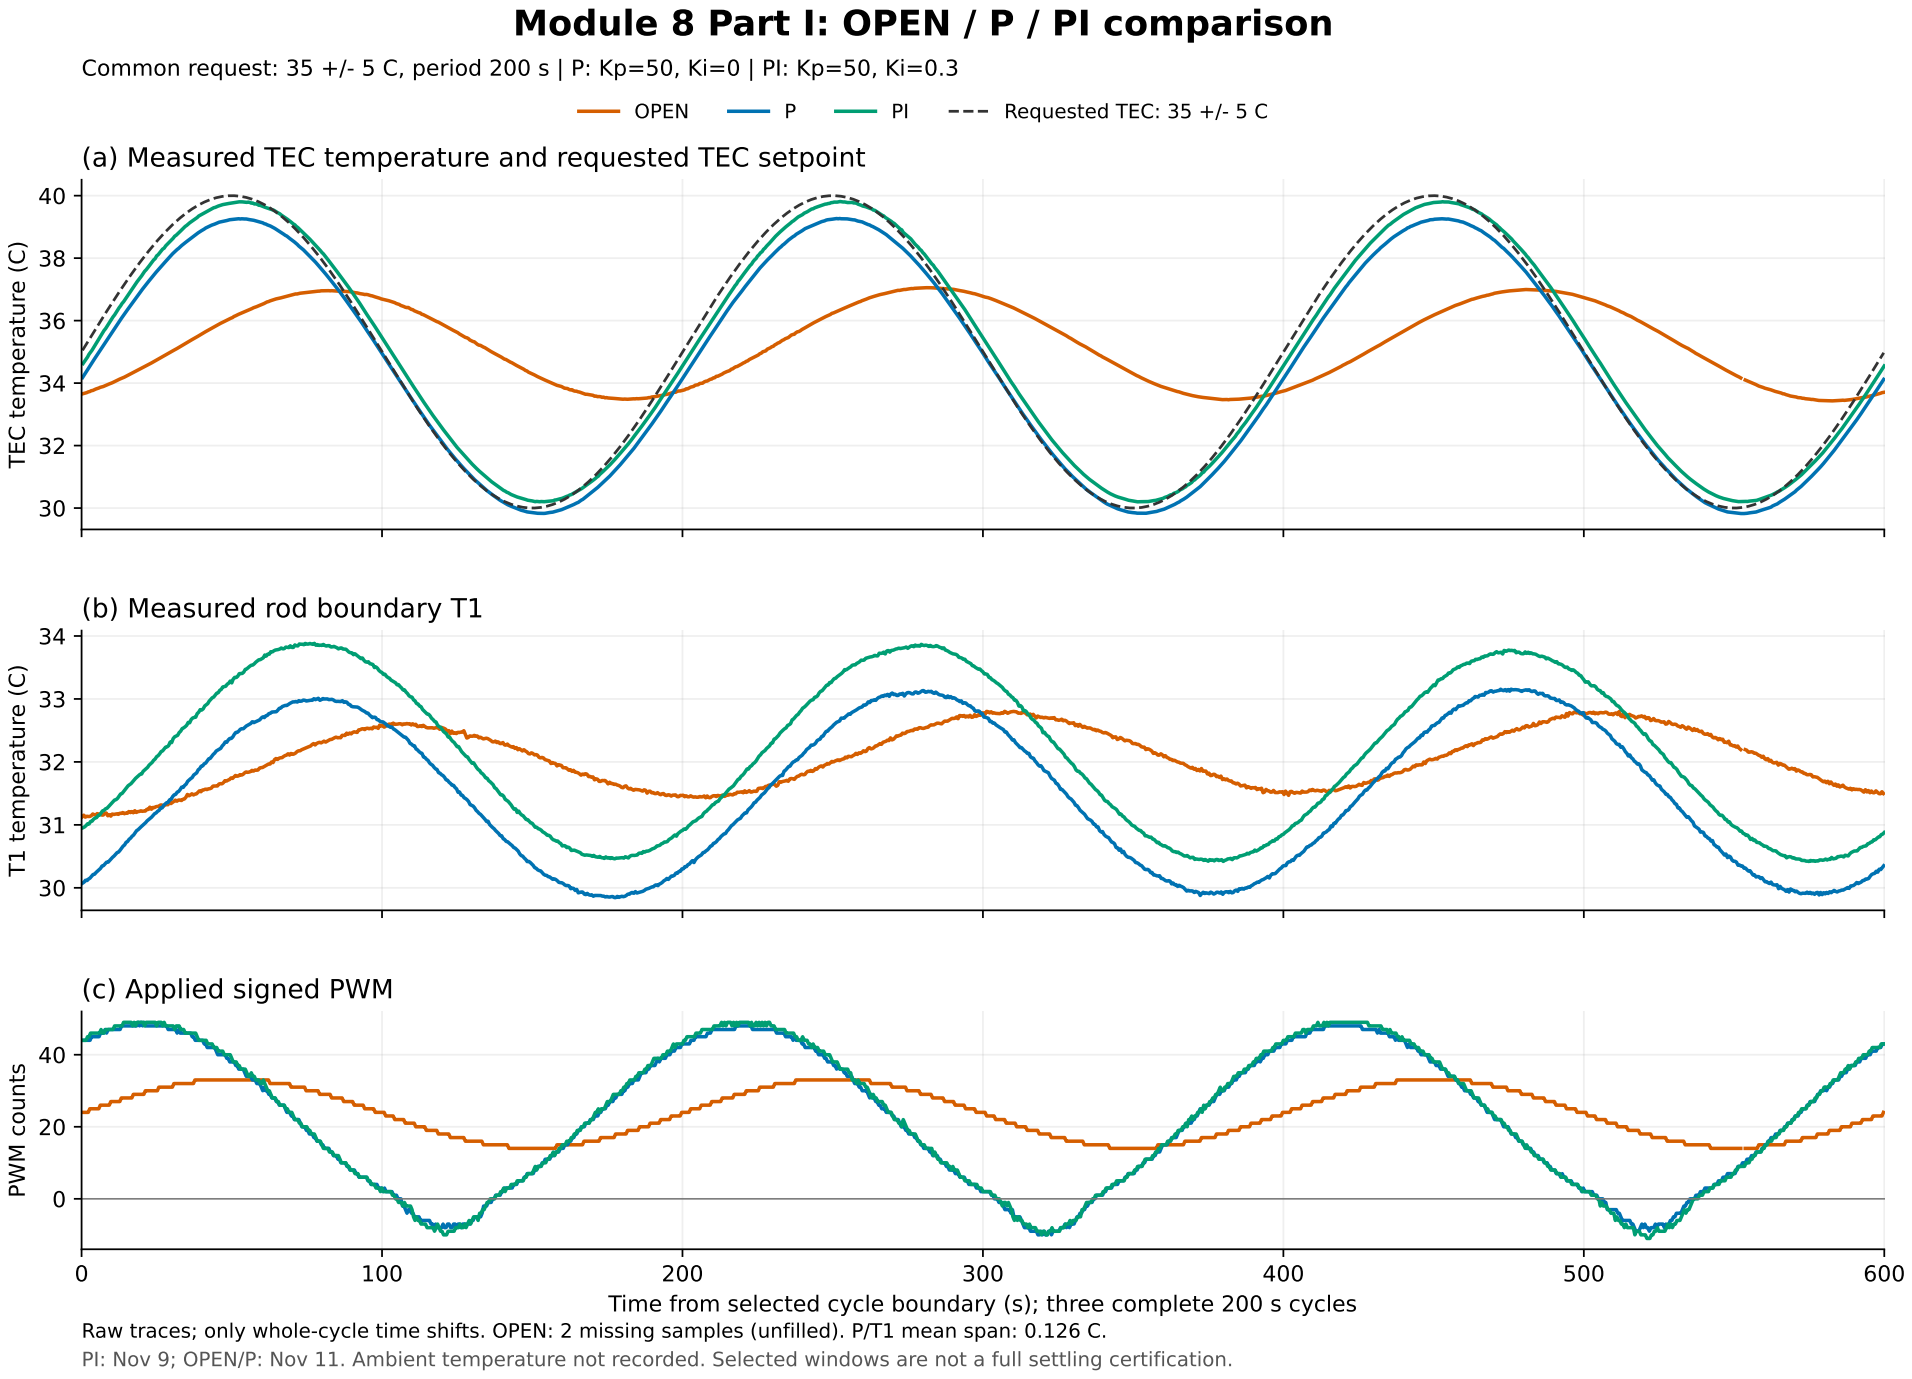
[picture p92: page 1]
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
