zhuyanheng/Phys39-teamR-X/Module_1/arduino/part_01_blink_1to1/part_01_blink_1to1.ino

/*
 * Part 1 - Blink with 1:1 Duty Cycle (HIGH:LOW = 1:1)
 * 
 * For oscilloscope measurement:
 * Record: High voltage, Low voltage, Period, Frequency, Duty Cycle
 * Expected duty cycle: 50%
 */

const int ledPin = 9; 

void setup() {
  pinMode(ledPin, OUTPUT);
}

void loop() {
  digitalWrite(ledPin, HIGH);
  delay(500);  // HIGH for 500 ms
  
  digitalWrite(ledPin, LOW);
  delay(500);  // LOW for 500 ms
  
  // Duty cycle = HIGH / (HIGH + LOW) = 500/(500+500) = 50% = 1:1
}
