zhuyanheng/Phys39-teamR-X/(commit log)

2026-09-02 Add organized Module 1 Arduino sketches and documentation
    Add Parts 1–4 Arduino sketches, measurement documentation, figures folders, data folders, and project README.
2026-09-04 Mostly Completion for Arduino and Data Folder
    Theratically, if nothing went wrong, these two folders are all set. Maybe Perhaps, possibly
    [part_3c_N1000_data.csv, part_3c_N1_data.csv]
2026-09-04 Update on Arduino/README
2026-09-09 Create Screenshot 2026-09-09 at 11.25.49 AM.png
2026-09-09 Create Screenshot 2026-09-09 at 11.28.08 AM.png
2026-09-14 Create Screenshot 2026-09-14 at 10.19.51 AM.png
2026-09-23 Adjust position
    [part_4_data.csv, part_5_data.csv]
2026-09-30 理论上搞定了，把一些不重要的删掉
2026-10-26 feat(module7): cross-calibration script + tests, and the step-1 integration sheet
    - Module_7/python/analysis/module_07_calibration.py: fits T_TEC = a_i + b_i*T_i
    for rod 1-5 from one shared soak, writes the coefficient table and a corrected
    copy into data/calibration/ (raw CSVs are only ever read), and plots the fits
    and correction residuals. Standard library only; matplotlib is optional.
    - Residual criteria: mean (a self-check, 0 by construction), curvature, max |r|.
    Curvature replaces the hot-end-minus-cold-end difference, which least squares
    drives to ~0 for any smooth distortion and therefore never fired.
    - Module_7/python/test_module_07_calibration.py: 24 hardware-free tests o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
2026-11-02 gui(module7): two plots so the rod-to-rod difference is readable
    One y-axis for six channels drew rods A1-A5 as a single flat line: the TEC
    spans 15-45 C while the probes sit within a degree of each other, and that
    difference is the measurement.
    - plot 1: TEC base plus the dashed setpoint
    - plot 2: rods A1-A5 only, own auto-ranged axis, probe distance in the legend,
    larger vertical share than the base panel
    - the two plots share one x-axis, so zooming either zooms both
    - the signed-PWM, P/I and error panels are gone; those columns are still in
    every CSV row and still printed in the readout line
    Also in this commit: a GUI test that the two plots stay split and linked, a
    test that the ra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
2026-11-02 gui(module7): x axis always shows the whole run, with zoom to inspect
    The 900 s sliding window threw the early rows away, so the plot could never be
    zoomed back out to t = 0 and the warm-up (the part that shows the rod lagging
    the TEC) was lost after 15 min.
    - history now keeps every row up to HISTORY_LIMIT (50000 rows = 6.9 h); only
    the oldest rows beyond the cap are dropped.
    - the x axis auto-fits the whole run after every sample (`X axis: whole run`,
    ticked by default); a minimum span of X_MIN_SPAN keeps the first minute from
    filling the plot with one point.
    - wheel-zoom and drag-pan inspect a window: the first manual x-range change
    unticks auto-follow (guarded by _fitting_x so t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
2026-11-02 data(module7): drop the seven short UI-check raw runs
    Each of these was a few seconds of "does the window work": no setpoint column,
    max |PWM sent| = 0, TEC and rods flat at room temperature, and none of them is
    cited by a note, test or script.
    20261030_144244_607441 16 s rod2 reported nan (wiring check)
    20261030_144627_120085 6 s rod3 nan
    20261030_145025_062531 15 s
    20261030_145410_552095 9 s
    20261030_145528_089509 70 s
    20261102_104851_452213 10 s (was untracked, removed from disk)
    20261102_111233_392923 59 s (was untracked, removed from disk)
    The first five are recoverable from git history; the last two existed only on
    disk and are gone.
    Kept: 20261030_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
2026-11-02 data(module7): one naming rule for the four kept runs
    Every remaining raw file now carries a chronological setpoint tag, per rule 6 of
    Module_7/data/README.md:
    20261030_152300_037075 -> 20261030_152300_037075_T20C_T30C_T20C
    774 rows, 20 -> 30 -> 20 C trial; tagged now that the run is written up
    already tagged, untouched: 20261102_100034_422916_T20C,
    20261102_100448_913799_T20C_trip45C_T40C
    20261102_111341_355018 -> 20261102_111341_355018_T40C
    PI at 40 C, still being written by the GUI. The GUI keeps one open handle, so
    the rename left logging untouched: the file grew 3351 bytes in the 6 s after
    the move and the Arduino time kept advancing.
    Deleted: 20261102_103646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
2026-11-02 data(module7): name the raw runs by purpose, not by clock time
    20261030_152300_037075_T20C_T30C_T20C -> pilot_20C_30C_20C
    20261102_100034_422916_T20C -> pi_check_20C
    20261102_100448_913799_T20C_trip45C_T40C -> interlock_trip_45C_40C
    20261102_111341_355018_T40C -> stationary_40C
    (still being written: the GUI holds one open handle, so the move did not
    interrupt logging - the file grew 3352 bytes in the 6 s after the rename)
    Scheme: module_07_rod_<role>_<programme>.csv. The role says why the run exists
    (pilot = function and propagation trial, pi_check = do the gains hold a setpoint,
    interlock_trip = the safety path cutting a 45 C attempt, stationary = input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
2026-11-02 analysis(module7): a relaxed steady criterion must label itself a diagnostic
    The 2026-11-02 40 C record never reaches the pre-registered limits, so the only fit available is a trailing window under looser ones. Any change to --slope-limit/--drift-budget/--hold now writes criterion.relaxed, prints a CRITERION RELAXED banner, retitles the profile axis and prefixes the figure title, so such a fit cannot be mistaken for the Part 3 result. Two tests cover the flag and the banner.
2026-11-02 analysis(module7): Part 3 systematics script, and the Part 1/2 figure scripts with tests
    stationary_diagnostics.py fits the trailing 600 s and then varies one thing at a time: 100 s window slides through the hold, each probe extrapolated to its own asymptote, T_inf by +-0.25/0.5/1.0 C, +-1 mm of geometry, and rod2 as the origin. It writes strict JSON with source_sha256, raw_unchanged and worst_change_percent, and makes --ambient required because a fitted T_inf is what a drifting record corrupts. sensor_map_figure.py and step_response_figure.py produce the Part 1 and Part 2 figures from committed geometry and a raw CSV; 22 new hardware-free tests (11 + 11).
2026-11-03 Complete A4 theoretical draft and reproducible rod predictions
2026-11-04 Update A4 predictions for measured 12.77 mm rod and November 9 deadline
2026-11-04 Keep the finite-rod derivation continuous across pages
2026-11-04 Complete offline Angstrom finite-rod analysis and document selected stationary result
